udellc/Optron/Images/general assembly/MPU/IMG_2807.JPG

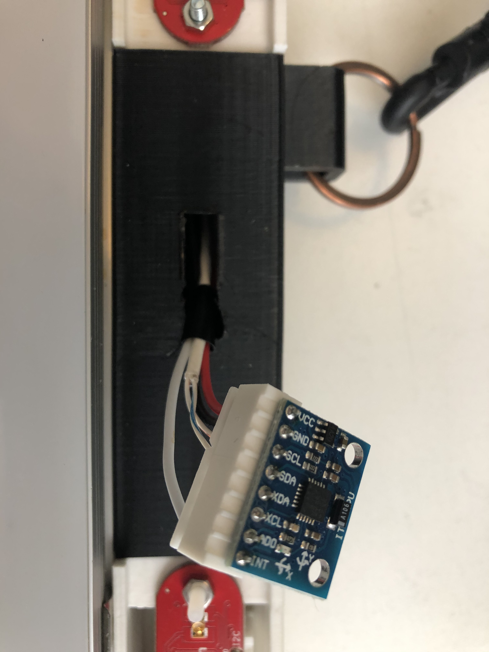
Images/general assembly/MPU/IMG_2807.JPG
