udellc/Optron/Images/general assembly/LED/IMG_2640.JPG

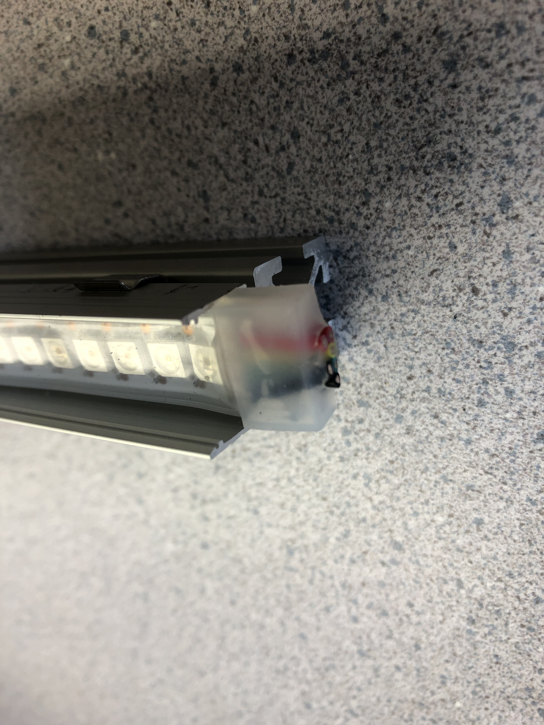
Images/general assembly/LED/IMG_2640.JPG
