udellc/Optron/Images/blocks/EPickWireManager2.1 orth1.png

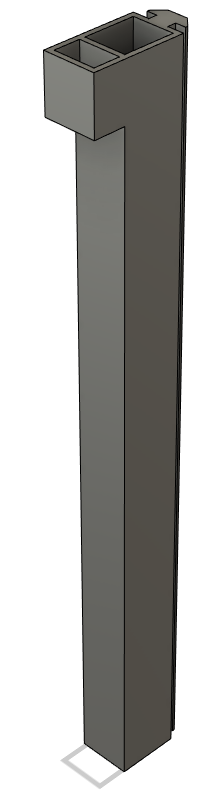
Images/blocks/EPickWireManager2.1 orth1.png
