udellc/Optron/Images/blocks/FretBoard ortho1.png

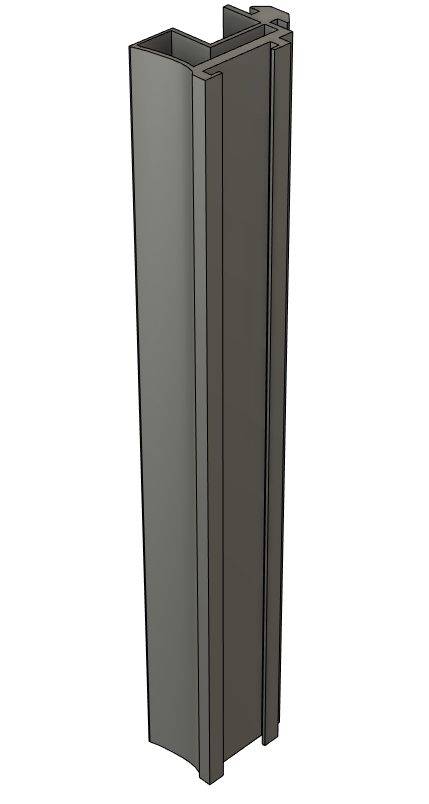
Images/blocks/FretBoard ortho1.png
