udellc/Optron/Images/blocks/FretBoard ortho2.png

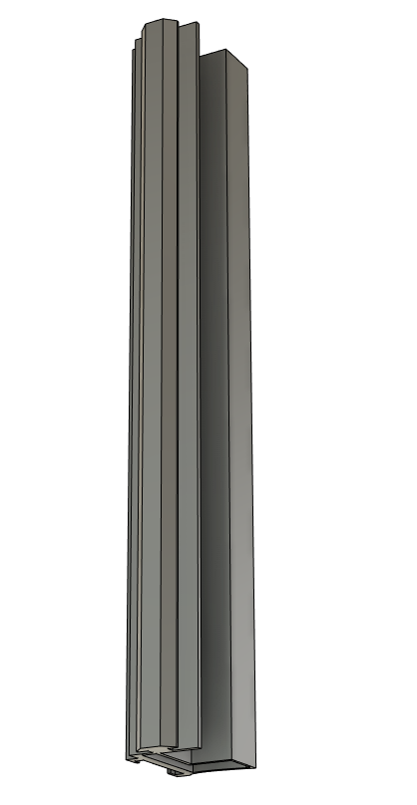
Images/blocks/FretBoard ortho2.png
