udellc/Optron/Images/blocks/FretBoardWireManager2.1.2 orth1.png

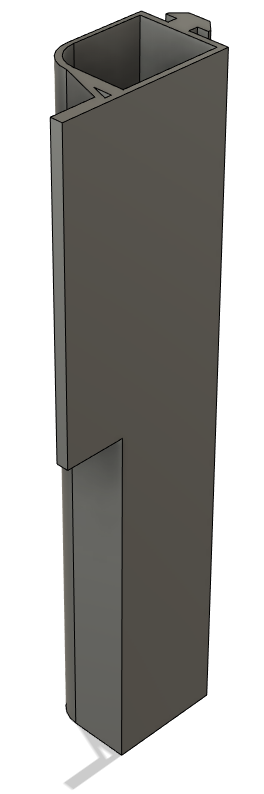
Images/blocks/FretBoardWireManager2.1.2 orth1.png
