udellc/Optron/Images/blocks/FretBoardWireManager2.1.2 orth2.png

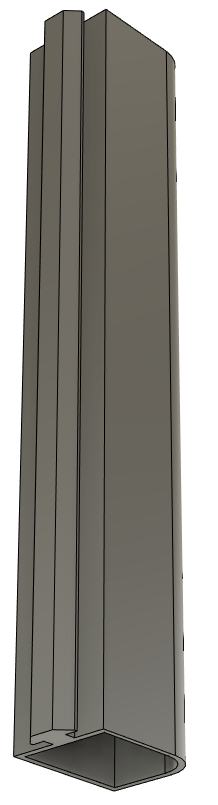
Images/blocks/FretBoardWireManager2.1.2 orth2.png
