udellc/Optron/Images/blocks/PCBMountBottom2.1.2 ortho1.png

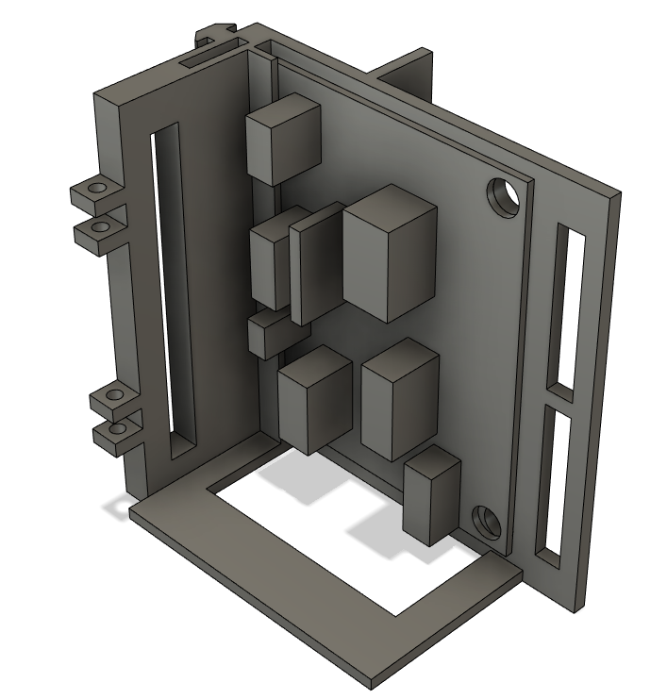
Images/blocks/PCBMountBottom2.1.2 ortho1.png
