udellc/Optron/Images/blocks/PCBMountBottom2.1.2 ortho2.png

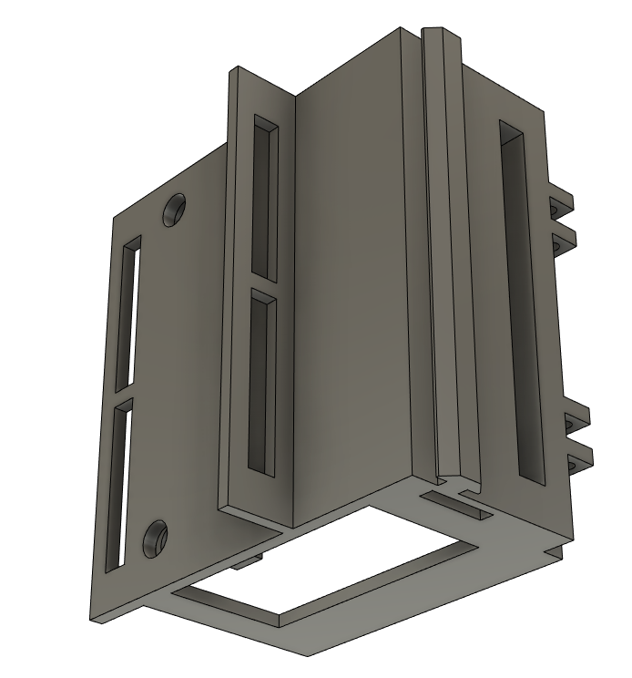
Images/blocks/PCBMountBottom2.1.2 ortho2.png
