udellc/Optron/Images/blocks/PCBMountTop2.1.2 ortho1.png

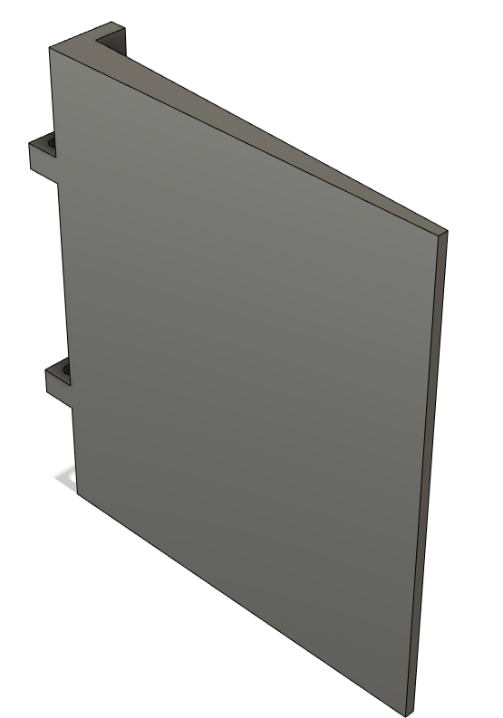
Images/blocks/PCBMountTop2.1.2 ortho1.png
