udellc/Optron/Images/blocks/PCBMountTop2.1.2 ortho2.png

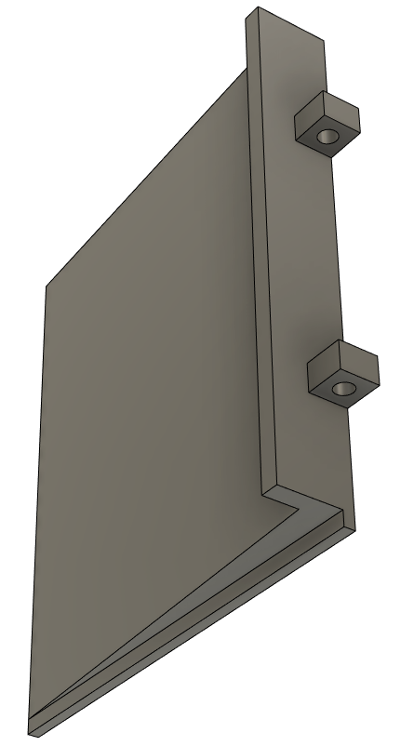
Images/blocks/PCBMountTop2.1.2 ortho2.png
