udellc/Optron/Images/blocks/SlidingWireManager2.1 ortho1.png

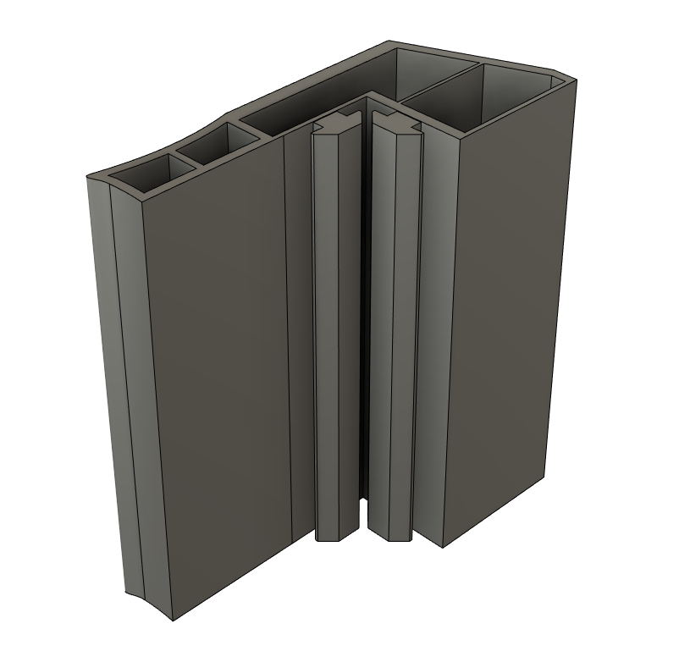
Images/blocks/SlidingWireManager2.1 ortho1.png
