udellc/Optron/Images/blocks/SlidingWireManager2.1 ortho2.png

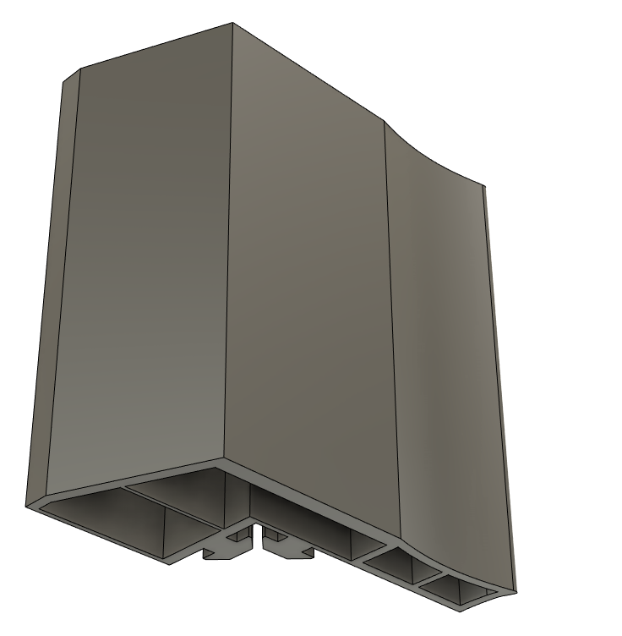
Images/blocks/SlidingWireManager2.1 ortho2.png
