udellc/Optron/Images/blocks/SlidingWireManagerSimple2.1 ortho1.png

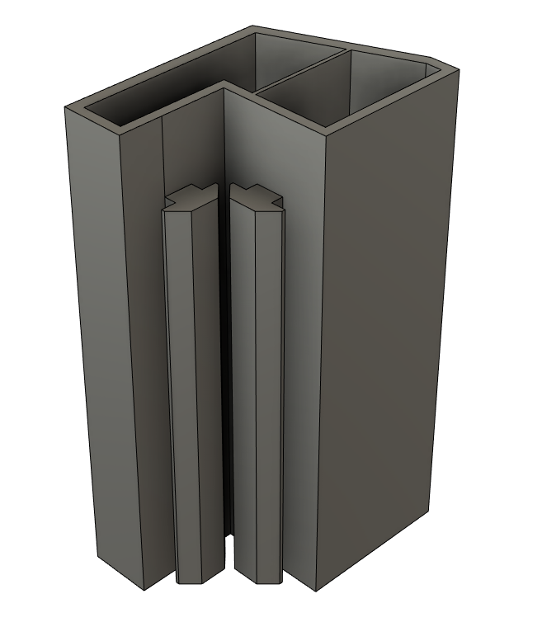
Images/blocks/SlidingWireManagerSimple2.1 ortho1.png
