udellc/Optron/Images/blocks/SlidingWireManagerSimple2.1 ortho2.png

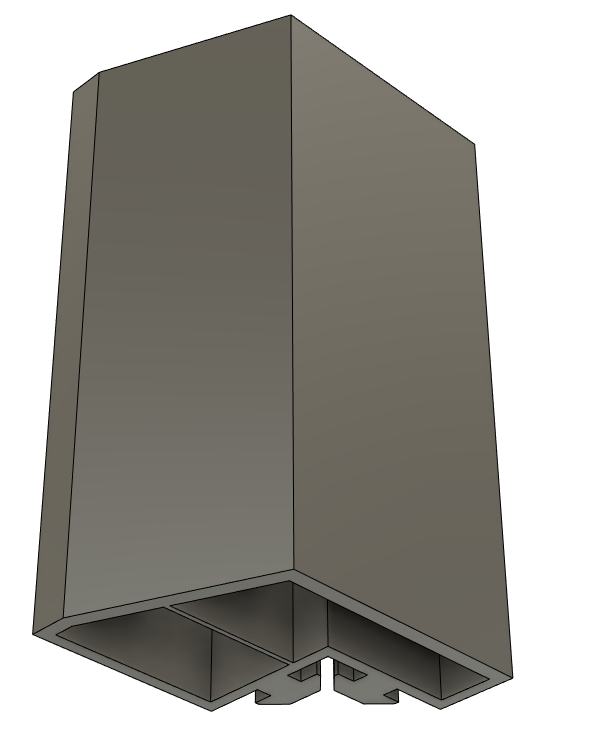
Images/blocks/SlidingWireManagerSimple2.1 ortho2.png
