udellc/Optron/Images/blocks/SlidingWireManagerStrapmount2.1 ortho1.png

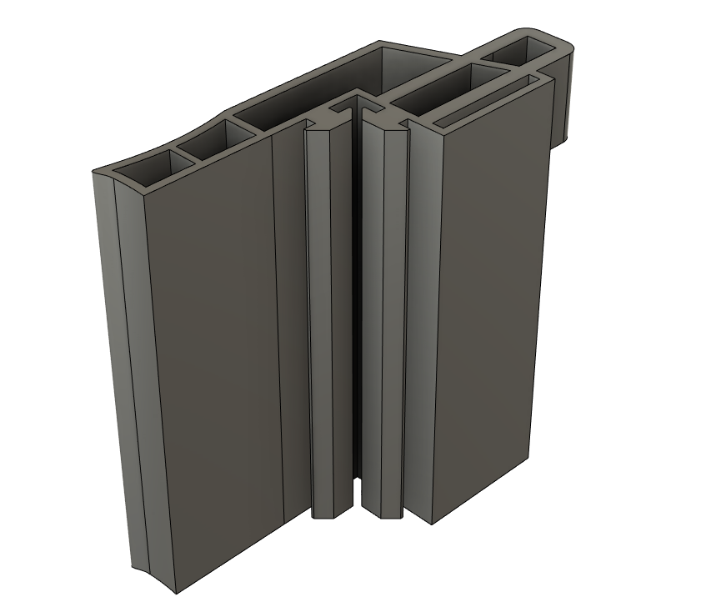
Images/blocks/SlidingWireManagerStrapmount2.1 ortho1.png
