udellc/Optron/Images/blocks/SlidingWireManagerStrapmount2.1 ortho2.png

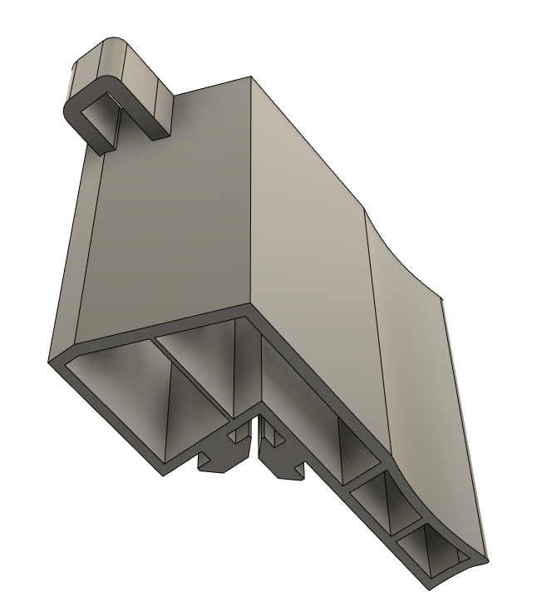
Images/blocks/SlidingWireManagerStrapmount2.1 ortho2.png
