udellc/Optron/Images/blocks/SlidingWireManagerStrapmountMPU6050Mount2.1 orth2.png

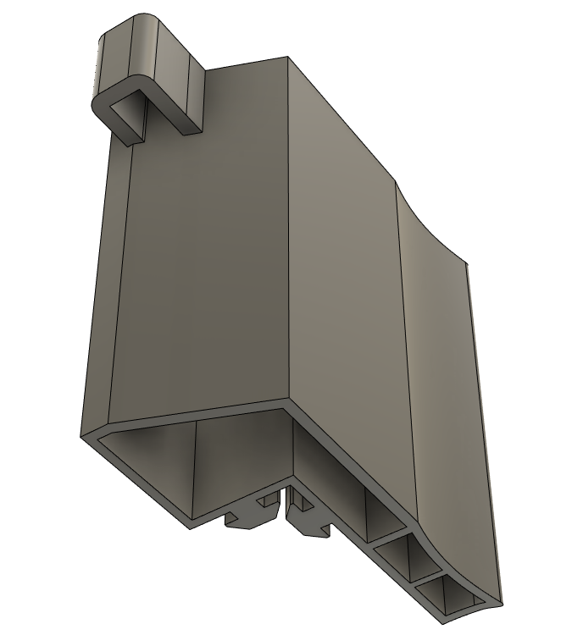
Images/blocks/SlidingWireManagerStrapmountMPU6050Mount2.1 orth2.png
