udellc/Optron/Images/blocks/ZXGestureSensorMount2.1 ortho1.png

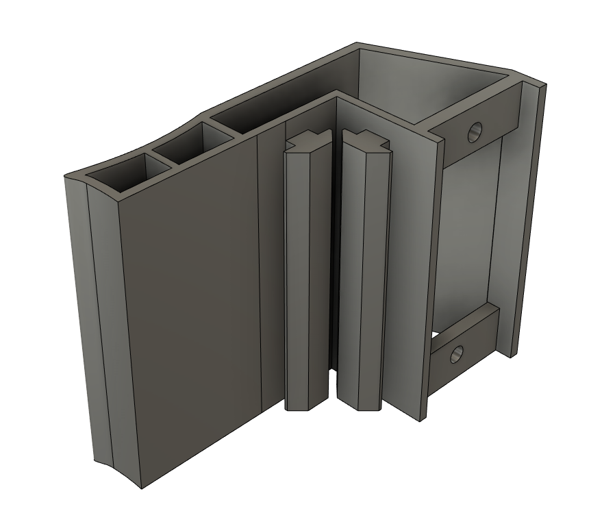
Images/blocks/ZXGestureSensorMount2.1 ortho1.png
