udellc/Optron/Images/blocks/ZXGestureSensorMount2.1 ortho2.png

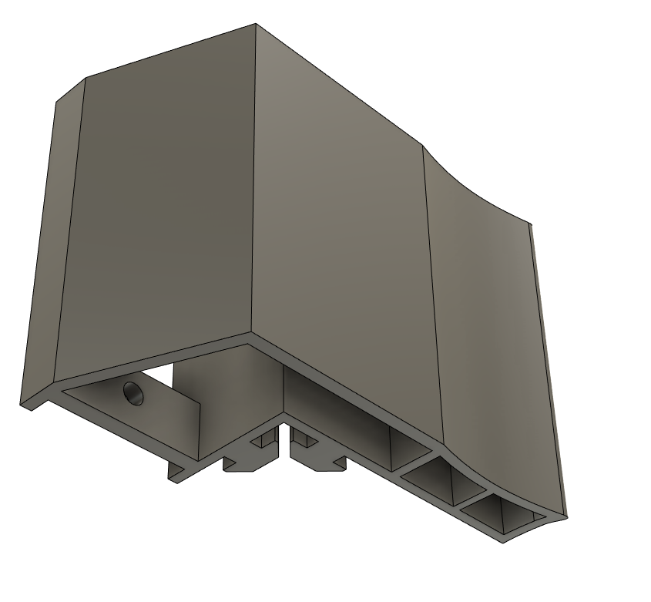
Images/blocks/ZXGestureSensorMount2.1 ortho2.png
