udellc/Optron/Images/blocks/ZXGestureSensorMountSimple2.1 ortho1.png

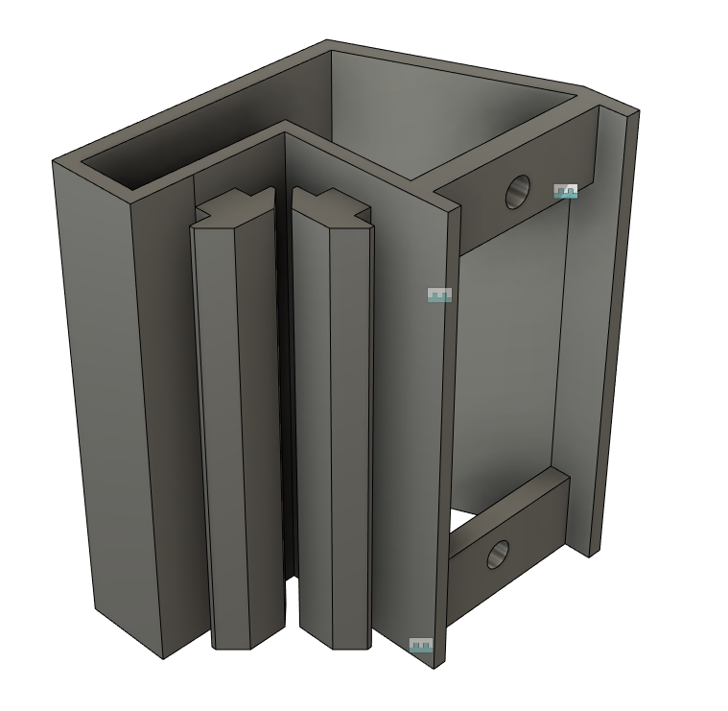
Images/blocks/ZXGestureSensorMountSimple2.1 ortho1.png
