udellc/Optron/Images/blocks/ZXGestureSensorMountSimple2.1 ortho2.png

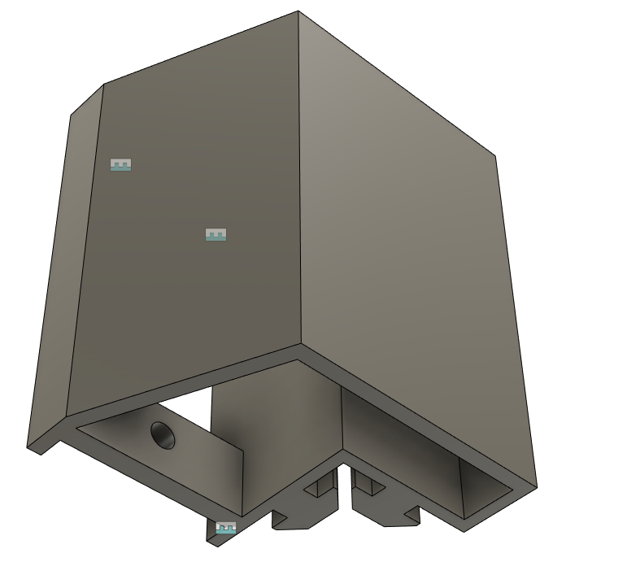
Images/blocks/ZXGestureSensorMountSimple2.1 ortho2.png
