udellc/Optron/Images/in_action.jpg

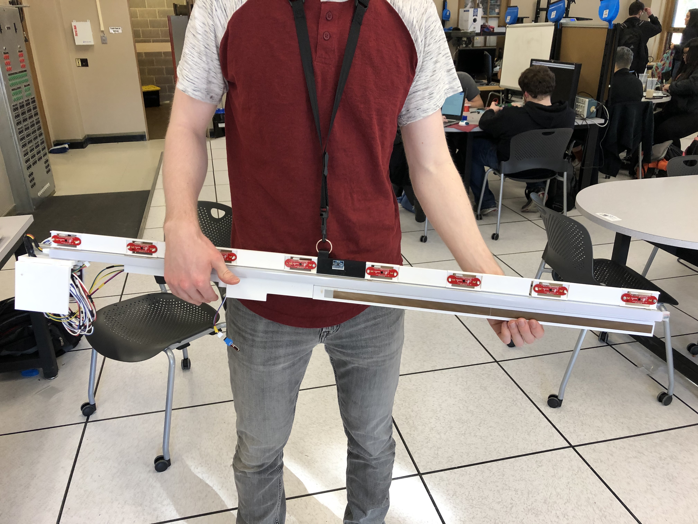
Images/in_action.jpg
