udellc/Optron/Program Flow Diagram.png

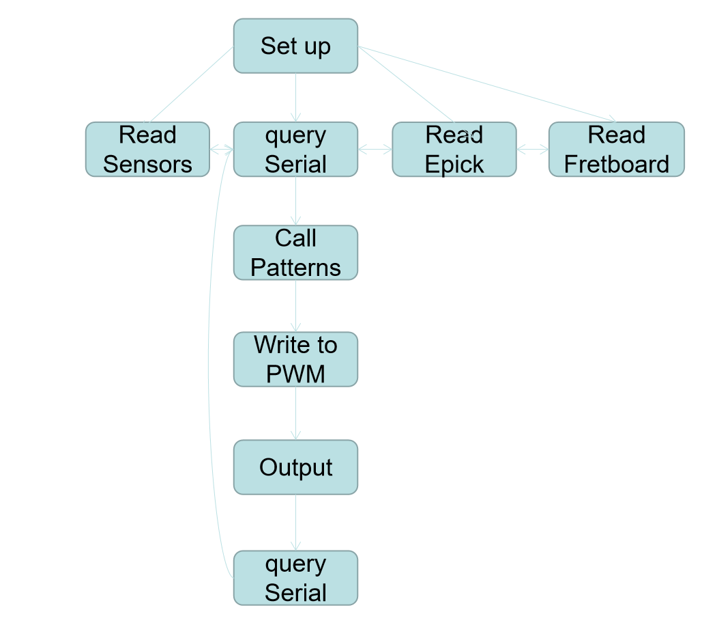
Program Flow Diagram.png
