udellc/Optron/Optron2.1 BOM.xlsx

Sheet: Overview
Optron Bill of Materials |  | Part Numbers
Document Created by: Chet Udell |  | Part numbers come in three parts, and are assigned to each part in the BOM:
Document Created on: 10/10/2019 |  | A letter which indicates type of part:
 |  | M - Mechanical | E - Electrical | H - Hardware
 |  | A number which indicates which part it is
Per 1 Optron: |  | A number indicating which duplicate of a part it is
Mechanical Components Total: | $71.13
Electrical Components Total: | $238.02 | For example:
PCBs Total: | $45.00 | M-26-0 is the first ZXGestureSensorMount2.1
3D Printing Total: | $164.68
Labor: | $0.00
Overall Cost: | $518.83

Sheet: Electrical Components
Optron Electrical Components Bill of Materials
Section of Optron | Optron ID number | Item | Distributor part number | MFG part number | Qty per 1 Optron | Cost per 1 pcs | Cost per 1 Optron | Product/site info | Datasheet/Guide | Notes
Microcontroller Assembly | E-28 | ItsyBitsy | ID:3800 | ID:3800 | 1 | $14.95 | $14.95 | Adafruit (https://www.adafruit.com/product/3800) | Datasheet (http://ww1.microchip.com/downloads/en/DeviceDoc/60001507E.pdf) | Main Microprocessor
 | E-29 | i2c Logic Level Shifter | BOB-12009 | BOB-12009 | 1 | $2.95 | $2.95 | Sparkfun (https://www.sparkfun.com/products/12009) | Datasheet (https://cdn.sparkfun.com/datasheets/BreakoutBoards/BSS138.pdf) | for shifting 3V i2c logic to 5V ZX sensor logic
 | E-30 | Quad Level Shifter | 1787 | 74AHCT125 | 1 | $1.50 | $1.50 | Adafruit (https://www.adafruit.com/product/1787) | Datasheet (https://cdn-shop.adafruit.com/product-files/1787/1787AHC125.pdf) | For shifting 3V M4 SPI MO SCK logic to 5V Dotstar Logic
 | E-31 | i2c Multiplexer 8ch | 2717 | TCA9548A | 1 | $6.95 | $6.95 | Adafruit (https://www.adafruit.com/product/2717) | Datasheet (https://cdn-shop.adafruit.com/datasheets/tca9548a.pdf) | Enables using 8 ZX sensors
Sensors | E-32 | 6dof IMU breakout | MPU6050 | MPU6050 | 1 | $5.84 | $5.84 | Amazon (https://www.amazon.com/GY-521-MPU-6050-Module-Sensors-Accelerometer/dp/B08184X254?hvadid=385372410444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) | DataSheet (https://www.invensense.com/wp-content/uploads/2015/02/MPU-6000-Datasheet1.pdf) | RegisterMap (https://www.invensense.com/wp-content/uploads/2015/02/MPU-6000-Register-Map1.pdf) | 3-axis gyroscope, 3-axis accelerometer, and a Digital Motion Processor™ (DMP)
 | E-33 | FSR Long | 1071 | Interlink408 | 1 | $19.95 | $19.95 | Adafruit (https://www.adafruit.com/product/1071) | DataSheet (https://cdn-shop.adafruit.com/datasheets/FSR400Series_PD.pdf) | Pressure sensor for Guitar Neck
 | E-34 | Long Linear Pot | SEN-08681 | SP-L-0500-103-MP | 1 | $23.95 | $23.95 | Sparkfun (https://www.sparkfun.com/products/8681) | DataSheet (https://www.sparkfun.com/datasheets/Sensors/Flex/SoftPot-Datasheet.pdf) | Position sensor for Guitar Neck
 | E-35 | ZX Gesture |  |  | 8 | $9.90 | $79.20 | Sparkfun (https://www.sparkfun.com/products/13162) | DataSheet (https://cdn.sparkfun.com/assets/learn_tutorials/3/4/5/XYZ_Interactive_Technologies_-_ZX_SparkFun_Sensor_Datasheet.pdf) | IR hand position tracking
 | E-36 | Bend Sensor, 1in bidirectional male connector, polyester overlay | 1in bi directional male tabs |  | 1 | $7.83 | $7.83 | Flexpoint (https://shop.flexpoint.com/products/the-bend-sensor%C2%AE?variant=17047449141294) | DataSheet (https://docs.wixstatic.com/ugd/5ec652_fc693c57e9374146bdcbbaa52bceb2d3.pdf) | ePick
LEDs | E-37 | Adafruit Dotstars 144led/m white, 1m | 2242 |  | 1 | $49.95 | $49.95 | Adafruit (https://www.adafruit.com/product/2242) | Tutorial (https://learn.adafruit.com/adafruit-dotstar-leds) | FastLED.io | 1 DotStar (https://cdn-shop.adafruit.com/product-files/2242/SK9822SHIJI.pdf)
 | E-38 | Adafruit Dotstars 144led/m white 0.5m | 2329 |  | 1 | $24.95 | $24.95 | Adafruit (https://www.adafruit.com/product/2329) | Tutorial
Misc | E-39 | Alitove 5V AC to DC |  |  | 1 | $25.99 | $25.99 | Amazon (https://www.amazon.com/ALITOVE-Transformer-Converter-5-5x2-1mm-100V-240V/dp/B01LXN7MN3?th=1) | Manufacturer Info (http://www.alitove.net/product/5v-15a-bk/) | Power supply
 | E-40 | 2.1mm DC Barrel Jack (for breadboard) |  |  | 1 | $8.99 | $8.99 | Amazon (https://www.amazon.com/DIKAVS-Breadboard-friendly-2-1mm-Barrel-Jack/dp/B074LK7G86/) |  | Power supply jack
 | E-41 | 2.1mm DC Barrel Jack (for PCB) |  |  | 1 | $5.99 | $5.99 | Amazon (https://www.amazon.com/Uxcell-a15012900ux0190-5-5x2-1-Female-Connector/dp/B011HFLKI2/)
 | E-42 | Haptic Motor Driver |  |  | 1 | $7.95 | $7.95 | Digikey (https://www.digikey.com/product-detail/en/sparkfun-electronics/ROB-14538/1568-1862-ND/9093800?productid=9093800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) |  | Future Components
 | E-43 | LRA Motor |  |  | 1 | $3.61 | $3.61 | Digikey (https://www.digikey.com/product-detail/en/jinlong-machinery-electronics-inc/G1036002D/1670-1068-ND/9974281) | DataSheet (http://www.vibration-motor.com/wp-content/themes/vibration-motors/dk-pdf/products/download/G1036002D.pdf)
Headers, Jumpers |  | R1 2.2k
 |  | R2 10k
 |  | R3, R4 47k
 |  | C1, 1kuF
 |  | M4.1, M4.2
 |  | M4.3
 |  | J5VDC, J5VDC2
 |  | J.MPU
 |  | J. 74A1, 74A2
 |  | B1
 |  | J.FSR
 |  | J.C1, for 1000µFCap |  |  |  |  |  |  | Cap reference (https://learn.adafruit.com/adafruit-dotstar-leds/power-and-connections) | 1000µF cap needed close to the strip for power consideration
 |  | J.DS
 |  | J.PIC
 |  | J.LN
 |  | i2c1.1, i2c2.1
 |  | i2c.1.2, i2c.2.2
 |  | J. TCA.1, TCA.2

Sheet: Mechanical Components
Optron Mechanical Components Bill of Materials
Section of Optron | Part Number | Item Description | Distributor part number | MFG part number | Qty per 1 Optron | Cost per 1 pcs | Cost per 1 Optron | Required Purchasing quantity | Cost for Required quantity | Product/site info | Notes
Core | M-0 | Al Extrusion Track 20x20 x 1220 mm | HFS3-1515-1220 | HFS5-2020-1220 | 1 | $7.68 | $7.68 | 1 | $7.68 | Misumi (https://us.misumi-ec.com/vona2/detail/110302683830/) | You will need to put the specs in yourself: HFS5, 2020, 1220mm len
 | M-1 | Muzata LED Channel | U103 | U103 | 1 | $32.99 | $32.99 | 1 | $32.99 | Amazon (https://www.amazon.com/gp/product/B07R7ZRZB1/ref=ppx_yo_dt_b_asin_title_o00_s00?ie=UTF8&psc=1) | This is a pack of 6 3.3ft diffusers which will be cut to length
Fretboard | M-2 | Teflon PFTE Film, 24" wide, 0.01" thick, 1ft length | 8569K63 | 8569K63 | 1 | $6.79 | $6.79 | 0.33 | $20.58 | McMaster (https://www.mcmaster.com/8569k63) | Will Need to laser cut frets. (https://github.com/udellc/Optron/blob/master/DXFs/Teflon.dxf)
 | M-3 | Silicone Rubber Strip, Grey, High-temp, Adhesive back, 3/4" wide, 1/32" thick | 8622k52 | 8622k52 | 1 | $7.43 | $7.43 | 0.33 | $22.52 | McMaster (https://www.mcmaster.com/8622k52) | Cut to Length
Securing, Fasteners | H-4 | M3 Slide in T Nut for 2020 Series Aluminum Extrusion Profile Slot 6mm | BR-TN-0015 | n/a | 12 | $0.16 | $1.92 | 50 | $7.99 | Amazon (https://www.amazon.com/gp/product/B01GCDG2QE/ref=ppx_yo_dt_b_asin_title_o00_s01?ie=UTF8&psc=1) | For mounting LED channel and other parts
 | H-5 | M3 x 0.5 mm Thread Steel Phillips Flat Head Screws, 8 mm Long | 91420A118 |  | 24 | $0.03 | $0.67 | 100 | $2.80 | McMasterCarr (https://www.mcmaster.com/91420a118) | For mounting LED channel and other parts
 | H-6 | M3 x 0.5 mm Thread Stainless Steel Hex Nut | 91828A211 |  | 42 | $0.06 | $2.33 | 100 | $5.55 | McMasterCarr (https://www.mcmaster.com/91828a211) | For mounting LED channel, IR sensors, PCB, and other parts
 | H-7 | M3 Stainless Steel Split Lock Washer | 92148A150 |  | 24 | $0.01 | $0.24 | 100 | $0.99 | McMasterCarr (https://www.mcmaster.com/92153a416) | For mounting LED channel and other parts
 | H-45 | M3 x 0.5 mm Thread Steel Phillips Flat Head Screws, 12 mm Long | 91420A122 |  | 8 | $0.03 | $0.26 | 100 | $3.20 | McMasterCarr (https://www.mcmaster.com/91420a122) | For mounting LED channel and other parts
 | H-44 | M3 x 0.5 mm Thread Nylon Slotted Flat Head Screws, 16 mm Long | 92929A246 |  | 18 | $0.10 | $1.73 | 100 | $9.63 | McMasterCarr (https://www.mcmaster.com/92929a246-93840A126) | For mounting IR sensor and PCB
 | H-8 | M3 Nylon Plastic Washer | 95610A530 |  | 18 | $0.04 | $0.65 | 100 | $3.60 | McMasterCarr (https://www.mcmaster.com/95610a530-95610A130) | For mounting IR sensor and PCB
 | H-9 | M3 x 0.5 mm Thread Nylon Slotted Flat Head Screws, 8 mm Long | 92929A252 |  | 0 | $0.09 | $0.00 | 100 | $9.40 | McMasterCarr (https://www.mcmaster.com/92929A252) | For mounting IR sensor and PCB
Pinout Cabling | H-10 | 4 pin JST-XH Male thru-hole. |  |  | 16 | 0.194 | 3.88 | 20 | 0.194 | Digikey (https://www.digikey.com/product-detail/en/jst-sales-america-inc/B4B-XH-A-LF-SN/455-2249-ND/1651047) | Used with IR sensors.
 | H-11 | 4 pin JST-XH Female thru-hole. |  |  | 16 | 0.0728 | 1.82 | 25 | 0.0728 | Digikey (https://www.digikey.com/product-detail/en/jst-sales-america-inc/XHP-4/455-2267-ND/683353) | Used with IR sensors.
 | H-12 | 3 pin JST-XH Male thru hole. |  |  | 4 | 0.19 | 1.14 | 6 | 0.19 | Digikey (https://www.digikey.com/product-detail/en/jst-sales-america-inc/B3B-XH-A-LF-SN/455-2248-ND/1651046) | Used with Position/Flex sensor
 | H-13 | 3 pin JST-XH Female thru hole. |  |  | 4 | 0.1 | 0.6 | 6 | 0.1 | Digikey (https://www.digikey.com/product-detail/en/jst-sales-america-inc/XHP-3/455-2219-ND/1651017) | Used with Position/Flex sensor
 | H-14 | 2 pin JST-XH Male thru hole. |  |  | 2 | 0.15 | 0.6 | 4 | 0.15 | Digikey (https://www.digikey.com/product-detail/en/jst-sales-america-inc/B2B-XH-A-LF-SN/455-2247-ND/1651045) | Used with Pressure sensor
 | H-15 | 2 pin JST-XH Female thru hole. |  |  | 2 | 0.1 | 0.4 | 4 | 0.1 | Digikey (http://www.digikey.com/product-detail/en/jst-sales-america-inc/XHP-2/455-2266-ND/555485) | Used with Pressure sensor
 | H-16 | XH JST Contact |  |  | 0.0363 | 80 | 5.445 | 150 | 0.0363 | Digikey (https://www.digikey.com/product-detail/en/SXH-001T-P0.6/455-1135-1-ND/527370/?itemSeq=315029088) | These are the sockets for JST connectors
Brush Track for cable mgmt |  | North shore commercial door |  |  |  |  |  |  |  | NSCD (https://cart.northshorecommercialdoor.com/yhst-16416632405890/ymix/MetaController.html?ysco_key_event_id=1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)

Sheet: PCBs
V8a | $38.00 | x 3 oshpark
TRRS breakout | $1.75 | x 3 oshpark | get 15 total
Total for v8 run: | $45.00

Sheet: 3D Printing
Part Number | Name | Quantity | Grams | Total Grams | Infill | Layer Height | Generate Support | STL | gcode
M-17 | FretBoard2.1 | 1 | 68.59 | 68.59 | 33 | 0.2 | No | STL (https://github.com/udellc/Optron/blob/master/STLs/2.1/FretBoard2.1.stl) | gcode (https://github.com/udellc/Optron/blob/master/STLs/2.1/FretBoard2.1.gcode)
M-18 | FretBoardBottom2.1 | 1 | 67.86 | 67.86 | 33 | 0.2 | Yes | STL (https://github.com/udellc/Optron/blob/master/STLs/2.1/FretBoardBottom2.1.stl) | gcode (https://github.com/udellc/Optron/blob/master/STLs/2.1/FretBoardBottom2.1.gcode)
M-19 | FretBoardTop2.1 | 1 | 70.65 | 70.65 | 33 | 0.2 | No | STL (https://github.com/udellc/Optron/blob/master/STLs/2.1/FretBoardTop2.1.stl) | gcode (https://github.com/udellc/Optron/blob/master/STLs/2.1/FretBoardTop2.1.gcode)
M-22 | SlidingWireManger2.1 | 3 | 71.62 | 214.86 | 33 | 0.2 | No | STL (https://github.com/udellc/Optron/blob/master/STLs/2.1/SlidingWireManager2.1.stl) | gcode (https://github.com/udellc/Optron/blob/master/STLs/2.1/SlidingWireManger2.1.gcode)
M-23 | SlidingWireMangerSimple2.1 | 3 | 53.54 | 160.62 | 33 | 0.2 | No | STL (https://github.com/udellc/Optron/blob/master/STLs/2.1/SlidingWireManagerSimple2.1.stl) | gcode (https://github.com/udellc/Optron/blob/master/STLs/2.1/SlidingWireMangerSimple2.1.gcode)
M-48 | PCBMountBottom2.1.2 | 1 | 72.5 | 72.5 | 33 | 0.2 | Yes | STL (https://github.com/udellc/Optron/blob/master/STLs/2.1/PCBMountBottom2.1.2.stl)
M-47 | PCBMountTop2.1.2 | 1 | 43.13 | 43.13 | 33 | 0.2 | Yes | STL (https://github.com/udellc/Optron/blob/master/STLs/2.1/PCBMountTop2.1.2.stl)
M-26 | ZXGestureSensorMount2.1 | 4 | 47.52 | 190.08 | 33 | 0.2 | Yes | STL (https://github.com/udellc/Optron/blob/master/STLs/2.1/ZXGestureSensorMount2.1.stl) | gcode (https://github.com/udellc/Optron/blob/master/STLs/2.1/ZXGestureSensorMount2.1.gcode)
M-27 | ZXGestureSensorMountSimple2.1 | 4 | 35.24 | 140.96 | 33 | 0.2 | Yes | STL (https://github.com/udellc/Optron/blob/master/STLs/2.1/ZXGestureSensorMountSimple2.1.stl) | gcode (https://github.com/udellc/Optron/blob/master/STLs/2.1/ZXGestureSensorMountSimple2.1.gcode)
M-46 | SlidingWireManagerSimpleStrapmountMPU6050Mount2.1 | 1 | 79 | 79 | 33 | 0.2 | Yes | STL (https://github.com/udellc/Optron/blob/master/STLs/2.1/SlidingWireManagerStrapmountMPU6050Mount2.1.stl)
M-49 | EPickWireManager2.1 | 1 | 30.63 | 30.63 | 33 | 0.2 | Yes | STL (https://github.com/udellc/Optron/blob/master/STLs/2.1/EPickWireManager2.1.stl)
M-50 | FretBoardWireManager2.1.2 | 1 | 39.38 | 39.38 | 33 | 0.2 | Yes | STL (https://github.com/udellc/Optron/blob/master/STLs/2.1/FretBoardWireManager2.1.2.stl)
M-24 | SlidingWireManagerSimpleStrapmount2.1 | 0 | 62.48 | 0 | 33 | 0.2 | No | STL (https://github.com/udellc/Optron/blob/master/STLs/2.1/SlidingWireManagerSimpleStrapmount2.1.stl) | gcode (https://github.com/udellc/Optron/blob/master/STLs/2.1/SlidingWireManagerSimpleStrapmount2.1.gcode)
M-25 | SlidingWireManagerStrapmount2.1 | 0 | 80.38 | 0 | 33 | 0.2 | No | STL (https://github.com/udellc/Optron/blob/master/STLs/2.1/SlidingWireManagerStrapmount2.1.stl) | gcode (https://github.com/udellc/Optron/blob/master/STLs/2.1/SlidingWireManagerStrapmount2.1.gcode)
M-21 | PCBMount2.1 | 0 | 23.21 | 0 | 33 | 0.2 | Yes | STL (https://github.com/udellc/Optron/blob/master/STLs/2.1/PCBMount2.1.stl) | gcode (https://github.com/udellc/Optron/blob/master/STLs/2.1/PCBMount2.1.gcode)
M-20 | FretBoardWireManager2.1 | 0 | 4.25 | 0 | 33 | 0.2 | Yes | STL (https://github.com/udellc/Optron/blob/master/STLs/2.1/FretBoardWireManager2.1.stl) | gcode (https://github.com/udellc/Optron/blob/master/STLs/2.1/FretBoardWireManager2.1.gcode)
 | Cost Per Gram:
 | $0.16
 | Total Cost:
 | $164.68
