udellc/Optron/STLs/2.0/DiffuserBodyv1.stl

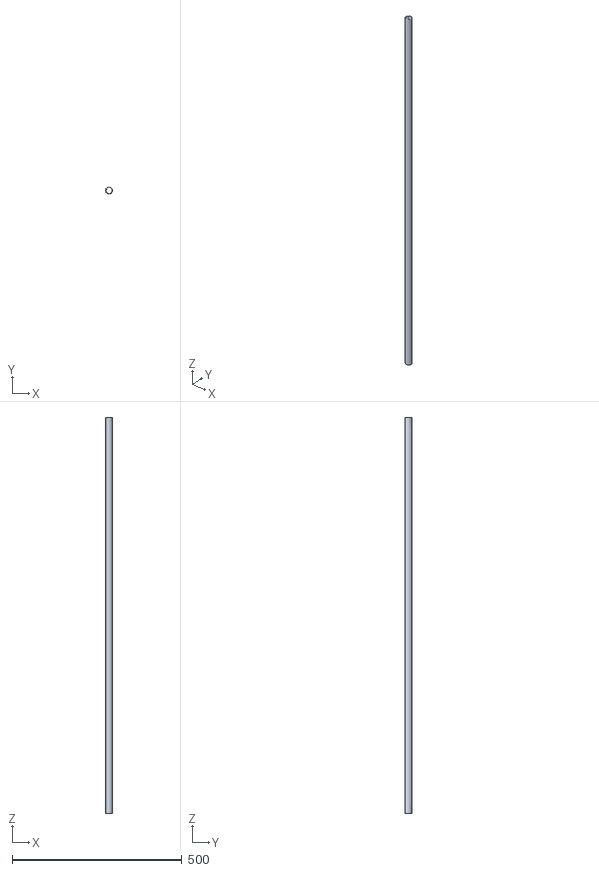
[picture p26: CAD file, 2019-10-22]
STLs/2.0/DiffuserBodyv1.stl
20.3 x 20.3 x 1165.2
