udellc/Optron/STLs/2.1/EPickWireManager2.1.stl

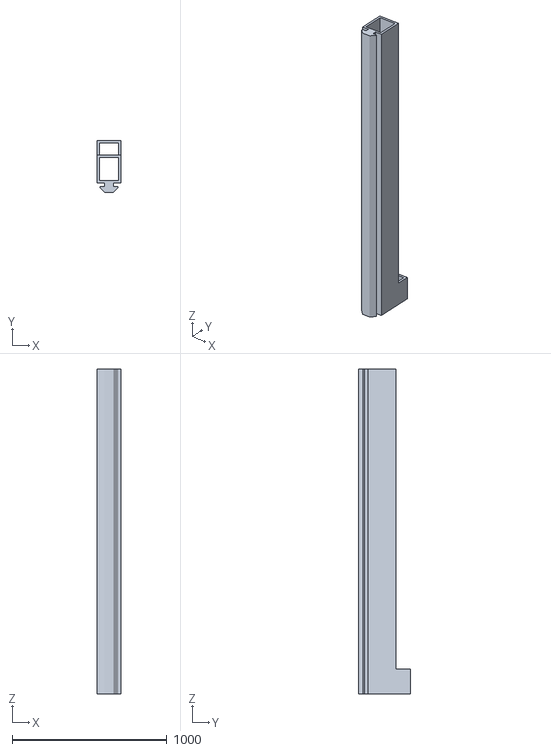
[picture p27: CAD file, 2020-04-10]
STLs/2.1/EPickWireManager2.1.stl
154.0 x 335.0 x 2100.0
