udellc/Optron/STLs/2.0/GitStrapMount.stl

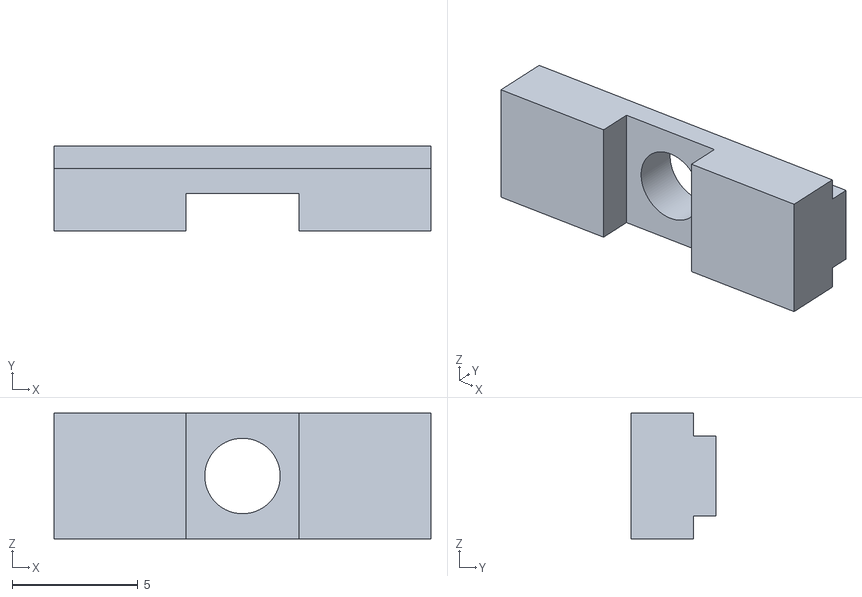
[picture p28: CAD file, 2019-10-15]
STLs/2.0/GitStrapMount.stl
15.0 x 3.40 x 5.00
