udellc/Optron/STLs/2.1/PCBMountBottom2.1.2.stl

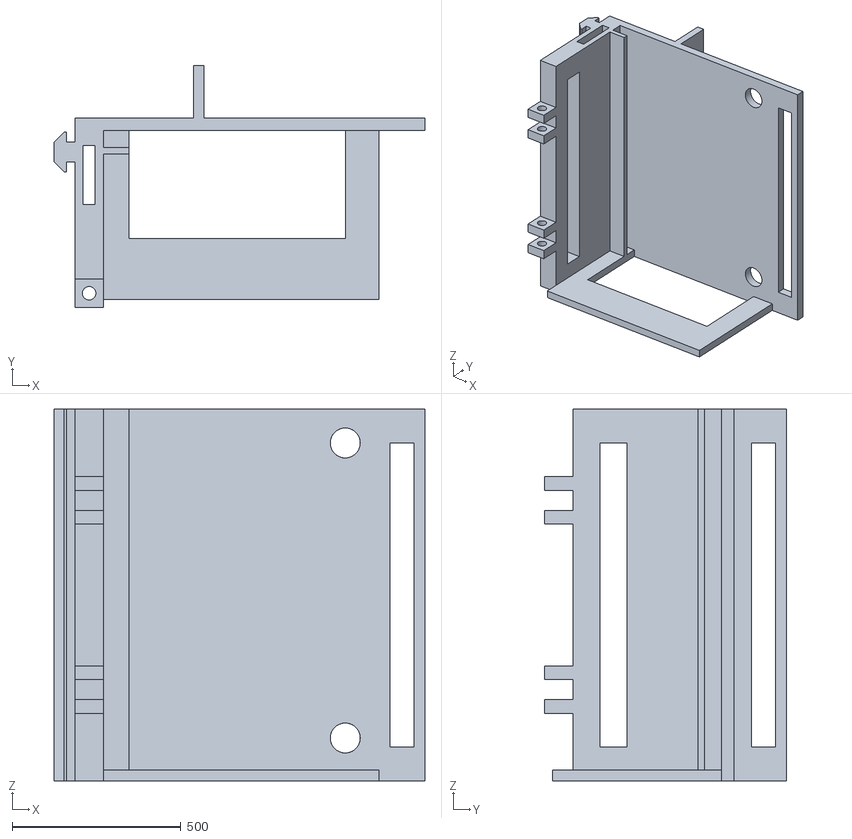
[picture p29: CAD file, 2020-04-10]
STLs/2.1/PCBMountBottom2.1.2.stl
1098.0 x 716.0 x 1100.0
