udellc/Optron/STLs/2.0/NeckClipBridgeV2.stl

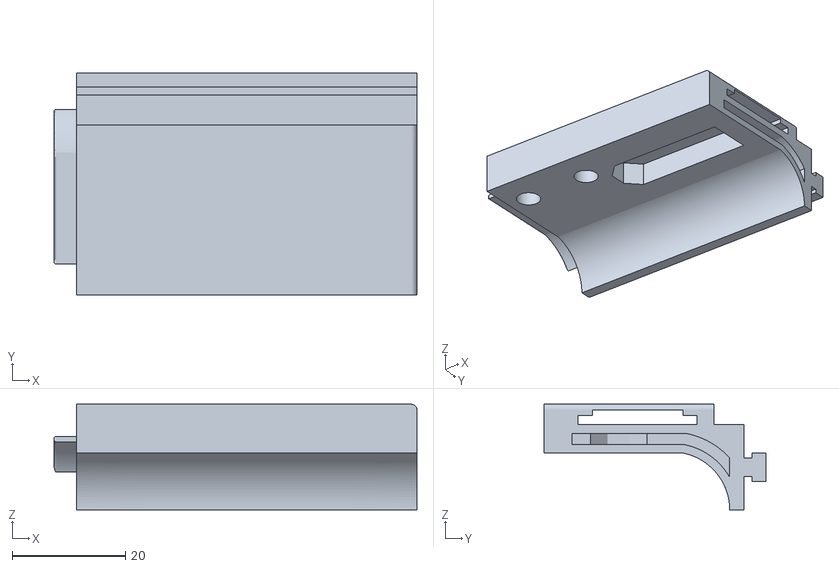
[picture p30: CAD file, 2019-10-15]
STLs/2.0/NeckClipBridgeV2.stl
64.0 x 39.1 x 18.6
