udellc/Optron/STLs/2.1/FretBoardWireManager2.1.2.stl

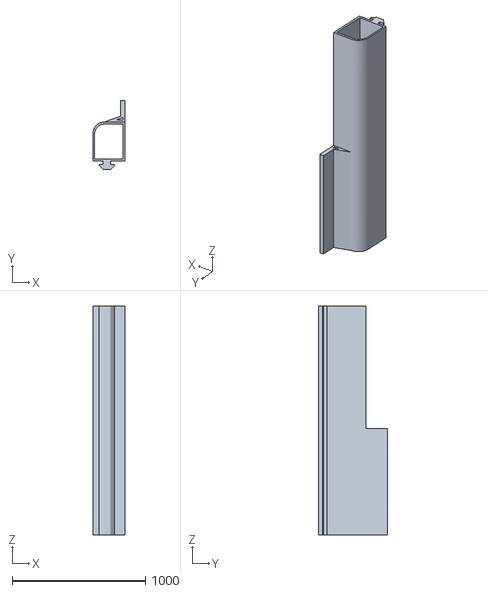
[picture p31: CAD file, 2020-04-10]
STLs/2.1/FretBoardWireManager2.1.2.stl
240.0 x 516.0 x 1720.0
