udellc/Optron/STLs/2.0/GitStrapPegTop.stl

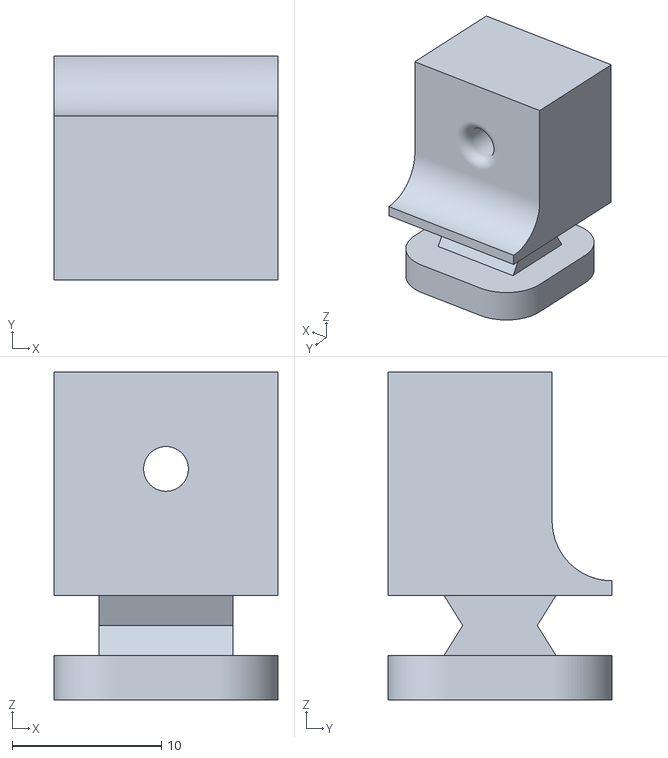
[picture p32: CAD file, 2019-10-15]
STLs/2.0/GitStrapPegTop.stl
15.0 x 15.0 x 22.0
