udellc/Optron/STLs/2.1/PCBMountTop2.1.2.stl

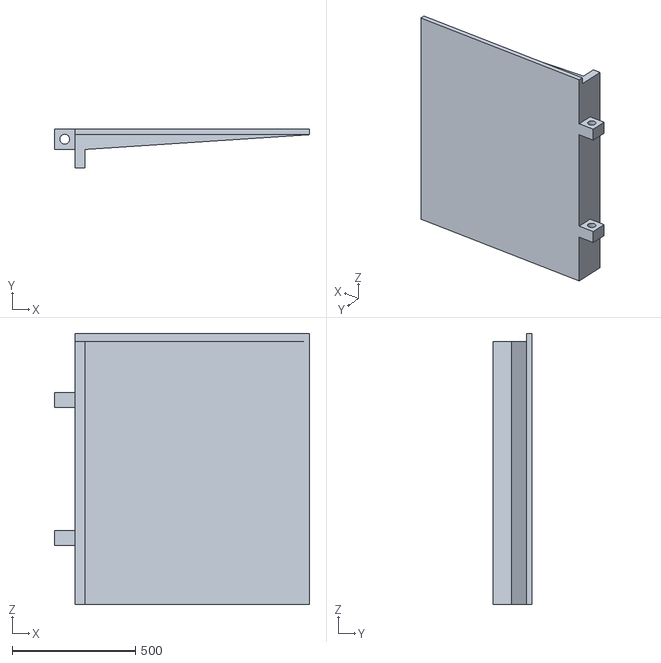
[picture p33: CAD file, 2020-04-10]
STLs/2.1/PCBMountTop2.1.2.stl
1036.0 x 160.0 x 1100.0
