udellc/Optron/STLs/2.0/NeckClipV3.stl

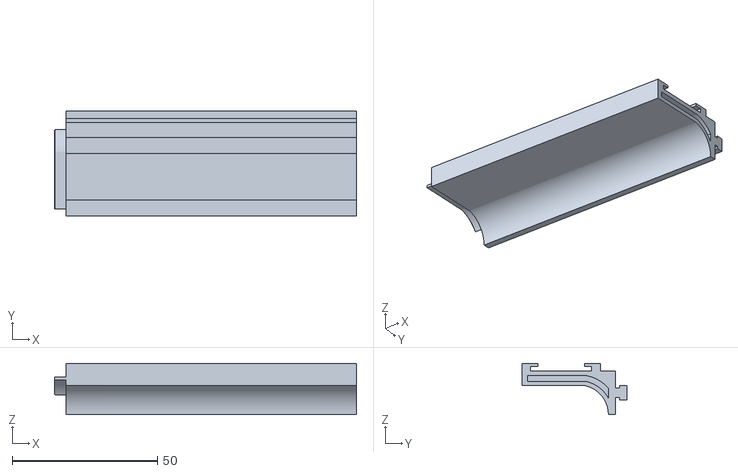
[picture p34: CAD file, 2019-10-15]
STLs/2.0/NeckClipV3.stl
104.0 x 36.1 x 17.6
