udellc/Optron/STLs/2.1/SlidingWireManagerStrapmountMPU6050Mount2.1.stl

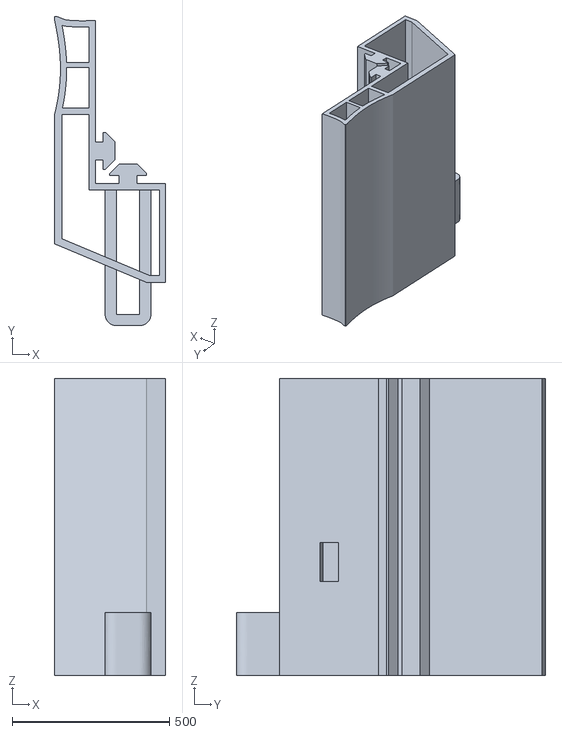
[picture p35: CAD file, 2020-02-19]
STLs/2.1/SlidingWireManagerStrapmountMPU6050Mount2.1.stl
354.8 x 985.1 x 945.7
