udellc/Optron/STLs/2.0/NeckClipNutV1.stl

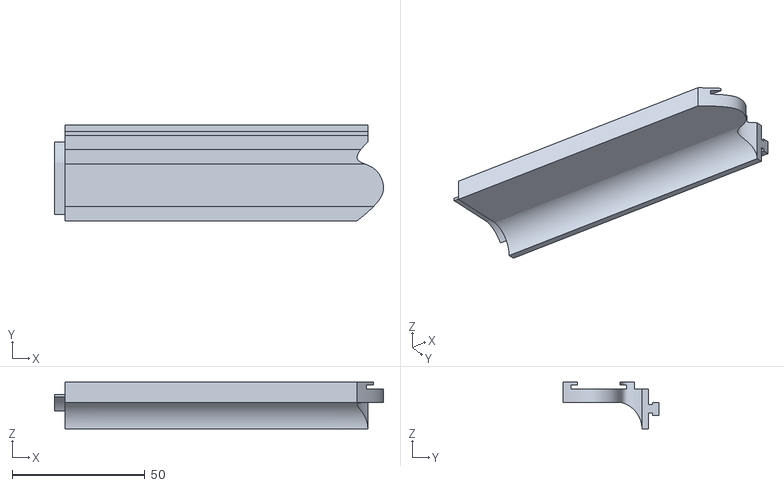
[picture p36: CAD file, 2019-10-15]
STLs/2.0/NeckClipNutV1.stl
124.0 x 36.1 x 17.6
