udellc/Optron/STLs/2.1/ZXGestureSensorMount2.1.stl

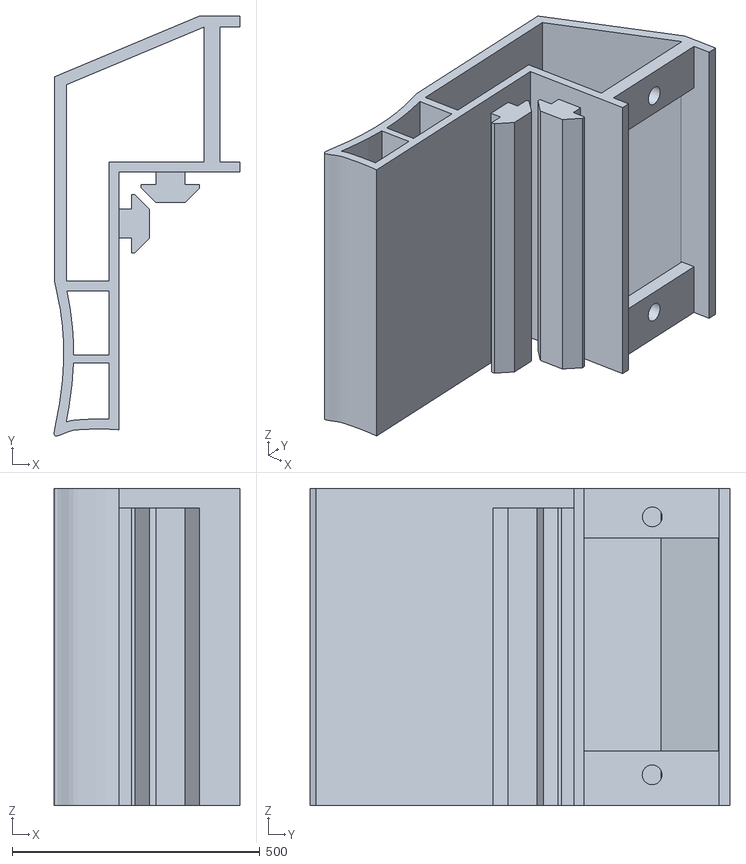
[picture p37: CAD file, 2020-01-15]
STLs/2.1/ZXGestureSensorMount2.1.stl
374.8 x 847.2 x 640.0
