udellc/Optron/STLs/2.0/PCBmountV3.stl

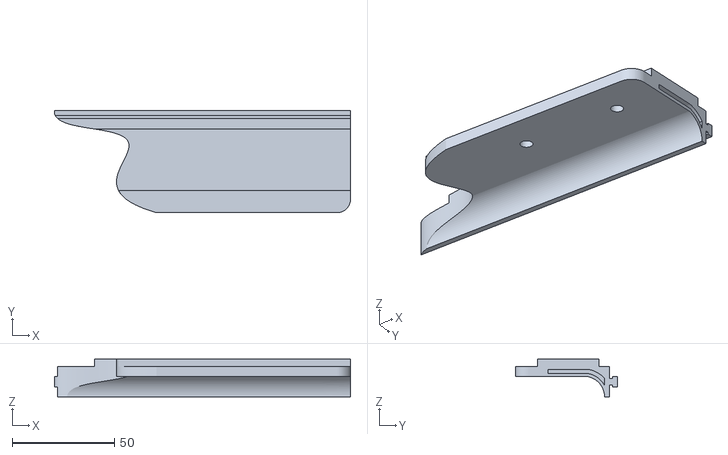
[picture p38: CAD file, 2019-10-15]
STLs/2.0/PCBmountV3.stl
145.0 x 50.1 x 18.6
