udellc/Optron/STLs/2.1/ZXGestureSensorMountSimple2.1.stl

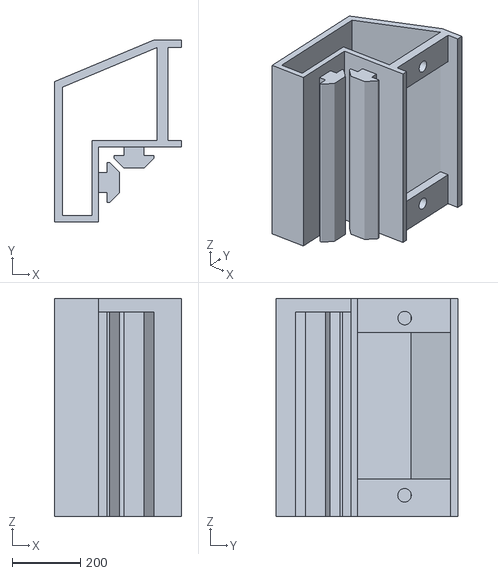
[picture p39: CAD file, 2020-01-15]
STLs/2.1/ZXGestureSensorMountSimple2.1.stl
374.0 x 534.7 x 640.0
