udellc/Optron/STLs/2.0/LED_insert100mm.stl

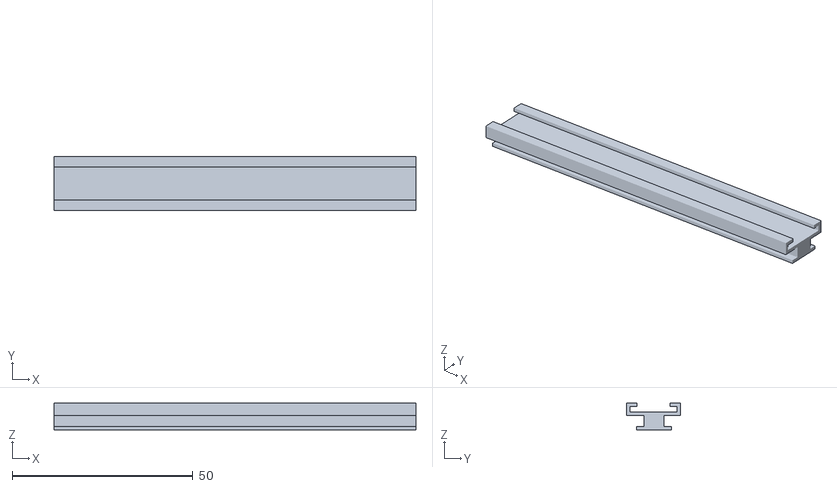
[picture p40: CAD file, 2019-10-15]
STLs/2.0/LED_insert100mm.stl
100.0 x 15.0 x 7.45
