udellc/Optron/STLs/2.1/FretBoard2.1.stl

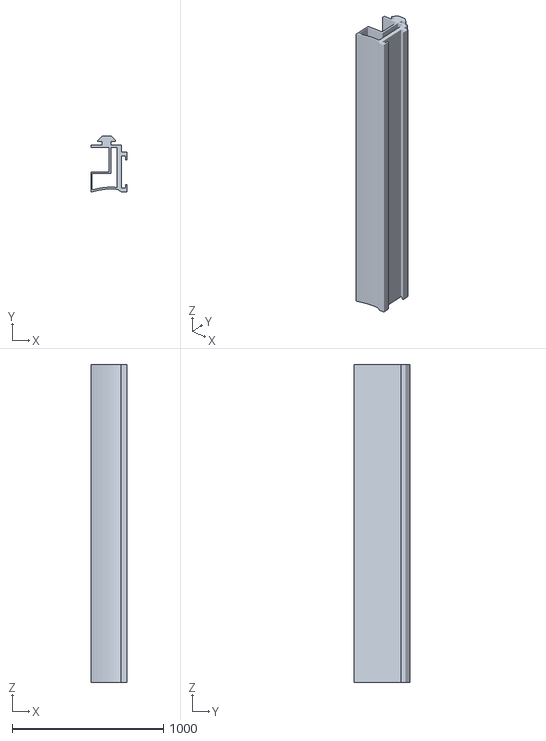
[picture p41: CAD file, 2020-01-15]
STLs/2.1/FretBoard2.1.stl
240.0 x 372.0 x 2100.0
