udellc/Optron/STLs/2.0/KeyedDiffuserBraceV3ZX.stl

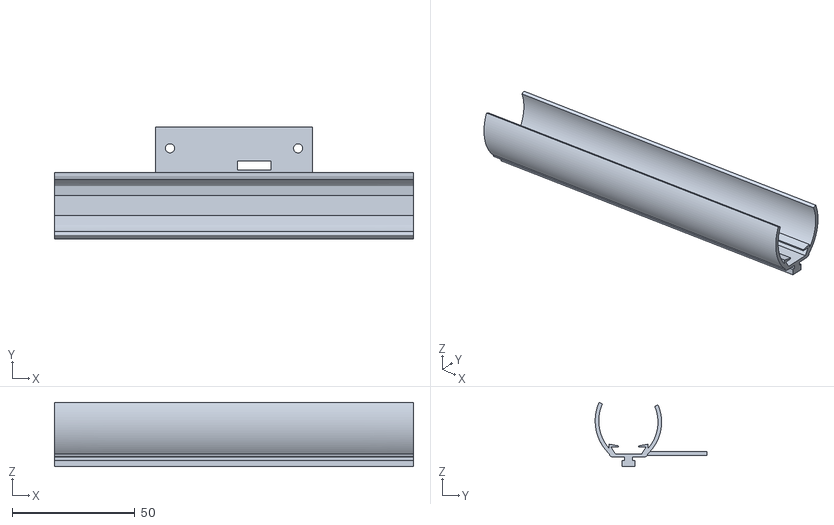
[picture p42: CAD file, 2019-10-15]
STLs/2.0/KeyedDiffuserBraceV3ZX.stl
146.0 x 45.4 x 26.1
