udellc/Optron/STLs/2.1/SlidingWireManagerSimpleStrapmount2.1.stl

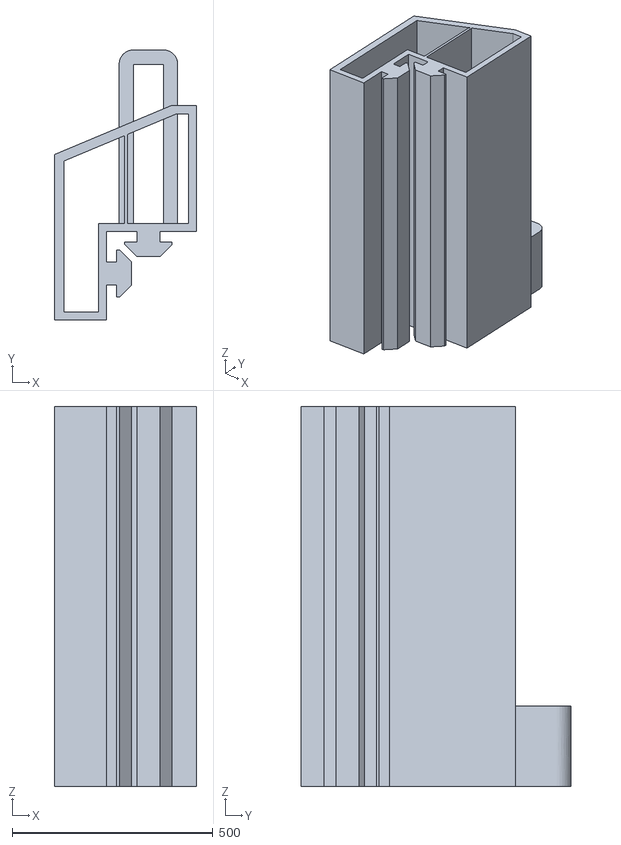
[picture p43: CAD file, 2020-01-15]
STLs/2.1/SlidingWireManagerSimpleStrapmount2.1.stl
354.0 x 672.6 x 945.7
