udellc/Optron/STLs/2.0/CableClip1V2.stl

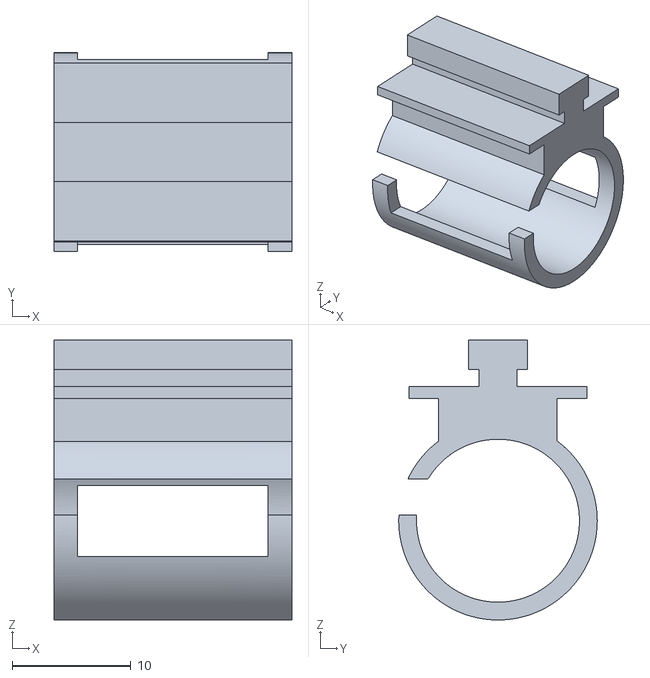
[picture p44: CAD file, 2019-10-15]
STLs/2.0/CableClip1V2.stl
20.0 x 16.7 x 23.5
