udellc/Optron/STLs/2.0/BarrelJackHolderFix.stl

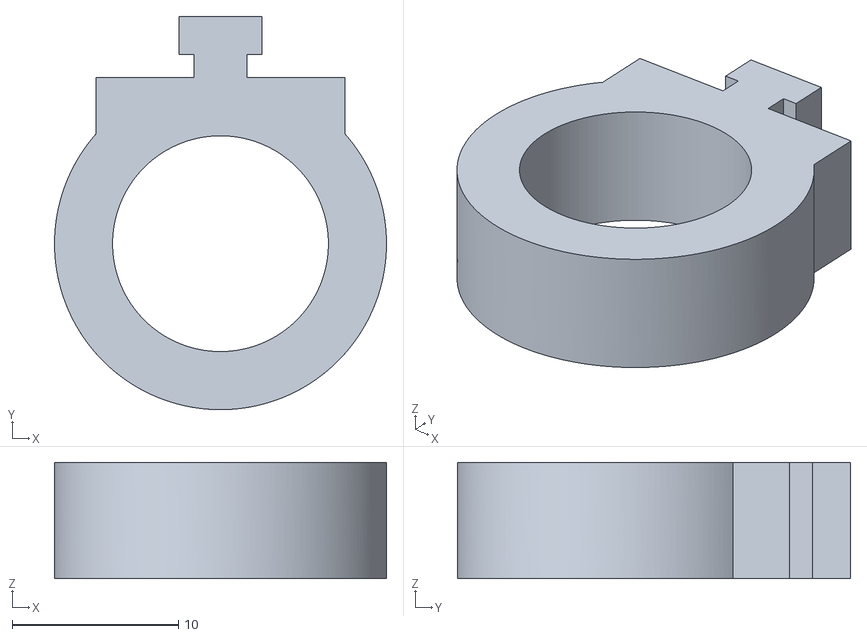
[picture p45: CAD file, 2019-10-15]
STLs/2.0/BarrelJackHolderFix.stl
20.0 x 23.7 x 7.00
