udellc/Optron/STLs/2.1/SlidingWireManagerSimple2.1.stl

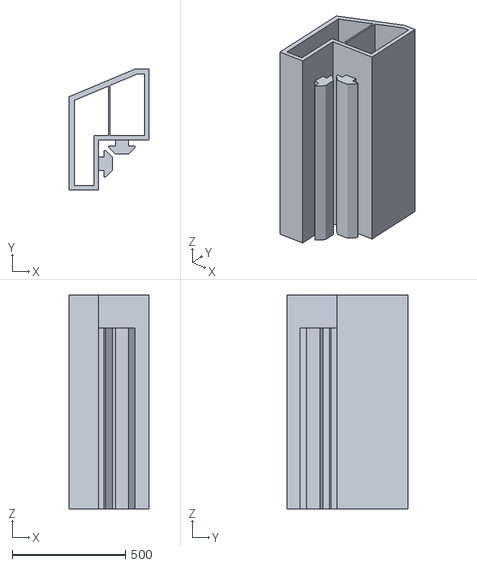
[picture p46: CAD file, 2020-01-15]
STLs/2.1/SlidingWireManagerSimple2.1.stl
354.0 x 534.7 x 945.7
