udellc/Optron/STLs/2.0/fingerboard6.17.154mm.stl

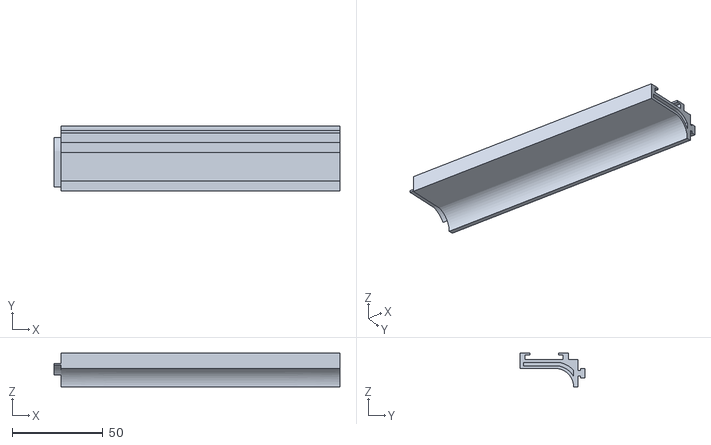
[picture p47: CAD file, 2019-10-15]
STLs/2.0/fingerboard6.17.154mm.stl
158.0 x 36.1 x 18.6
