udellc/Optron/STLs/2.1/FretBoardWireManager2.1.stl

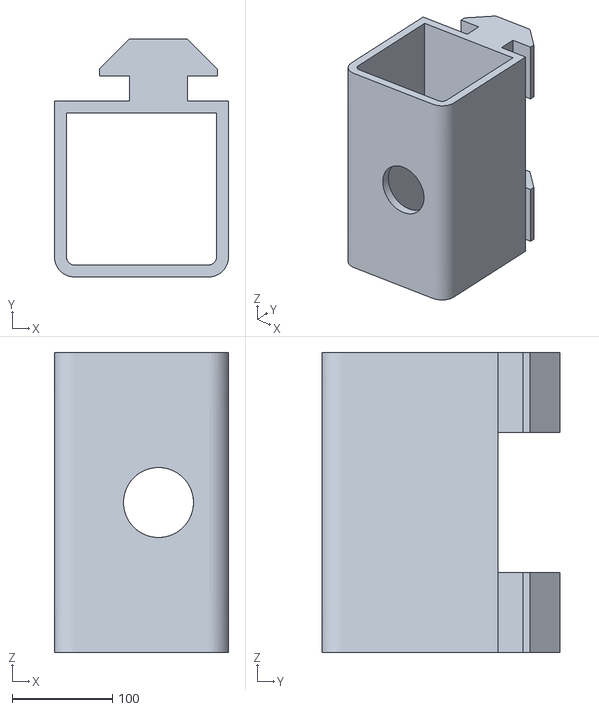
[picture p48: CAD file, 2020-01-15]
STLs/2.1/FretBoardWireManager2.1.stl
174.0 x 238.0 x 300.0
