udellc/Optron/STLs/2.0/fingerBoardClip6.17.stl

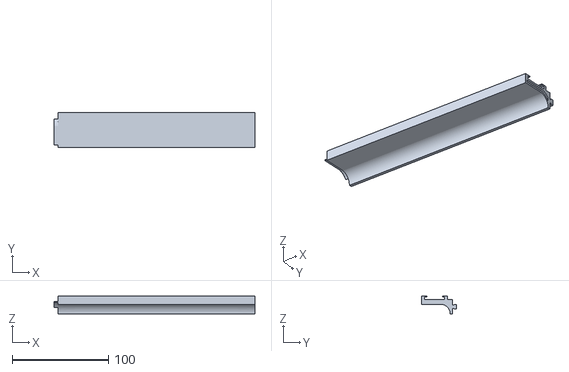
[picture p49: CAD file, 2019-10-15]
STLs/2.0/fingerBoardClip6.17.stl
209.0 x 36.1 x 18.6
