udellc/Optron/STLs/2.1/SlidingWireManager2.1.stl

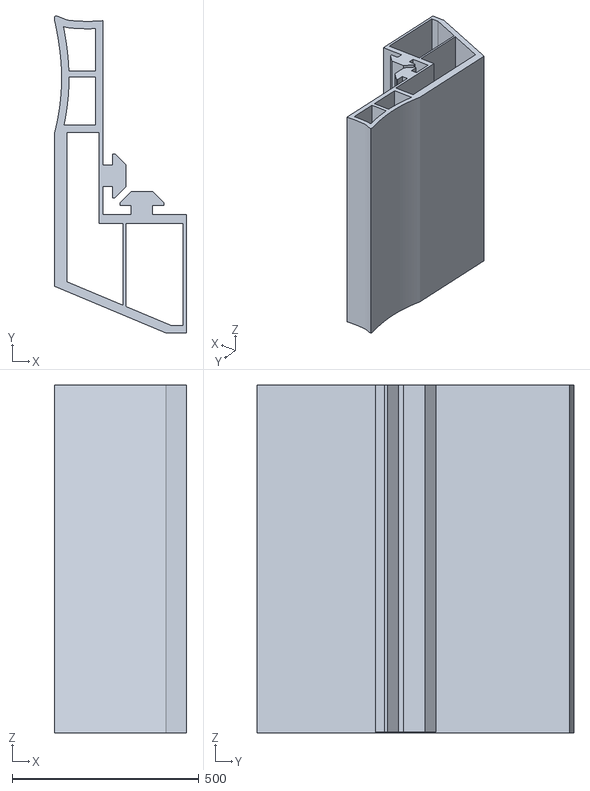
[picture p50: CAD file, 2020-01-15]
STLs/2.1/SlidingWireManager2.1.stl
354.8 x 849.6 x 931.4
