udellc/Optron/STLs/2.0/StrumLine.stl

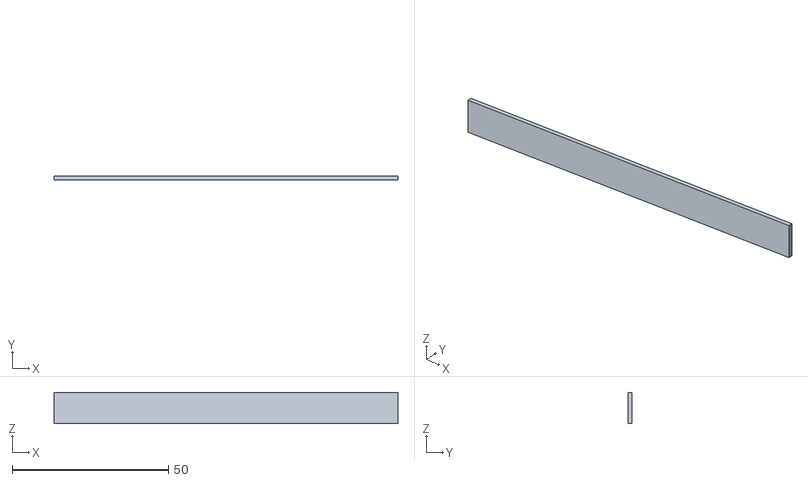
[picture p51: CAD file, 2019-10-15]
STLs/2.0/StrumLine.stl
110.2 x 1.30 x 10.0
