udellc/Optron/STLs/2.1/FretBoardTop2.1.stl

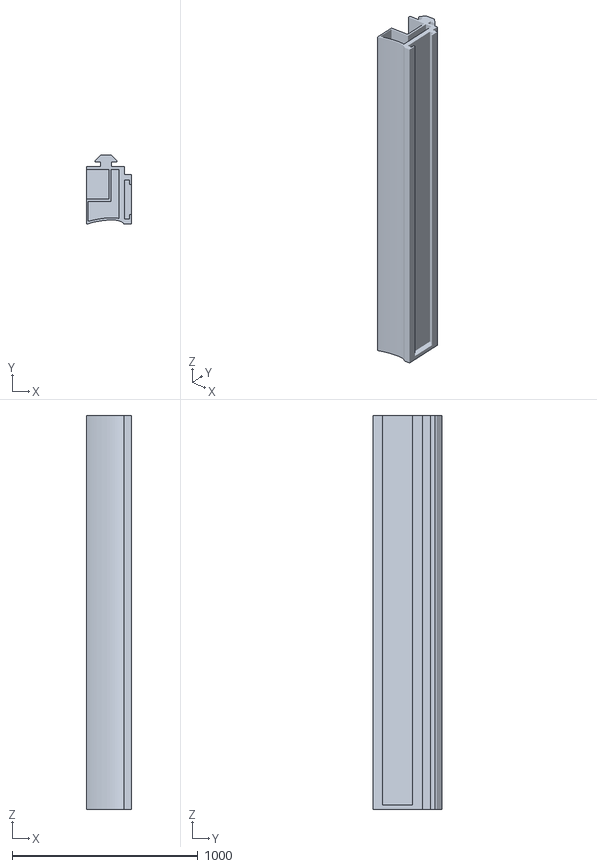
[picture p52: CAD file, 2020-01-15]
STLs/2.1/FretBoardTop2.1.stl
240.0 x 372.0 x 2124.0
