udellc/Optron/STLs/2.1/SlidingWireManagerStrapmount2.1.stl

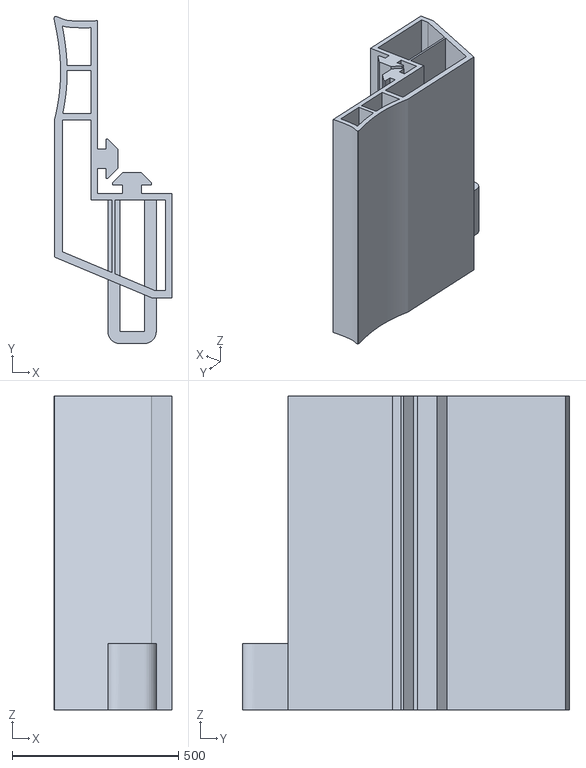
[picture p53: CAD file, 2020-01-15]
STLs/2.1/SlidingWireManagerStrapmount2.1.stl
354.8 x 985.1 x 945.7
