udellc/Optron/STLs/2.1/PCBmount2.1.stl

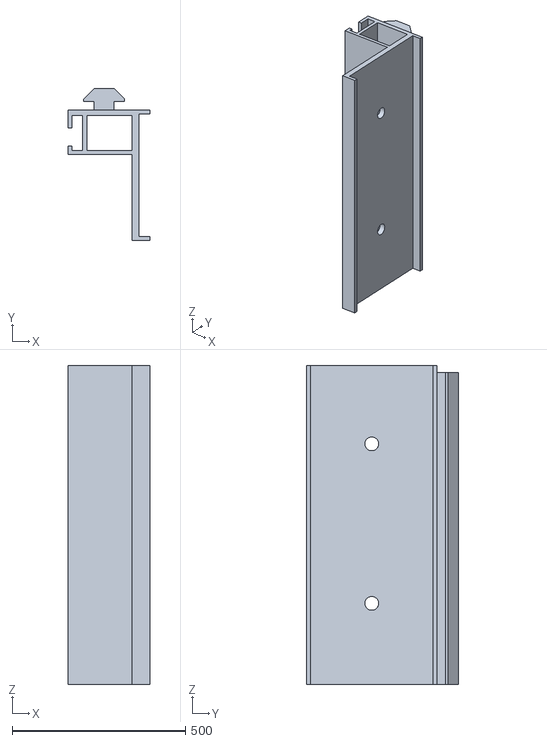
[picture p54: CAD file, 2020-01-07]
STLs/2.1/PCBmount2.1.stl
236.0 x 438.0 x 920.0
