udellc/Optron/(list of files, cad)

Other CAD files:
DXFs/Teflon.dxf
STLs/2.1/FretBoardBottom2.1.stl
