udellc/Optron/Images/blocks/ir_sensor_assembly.png

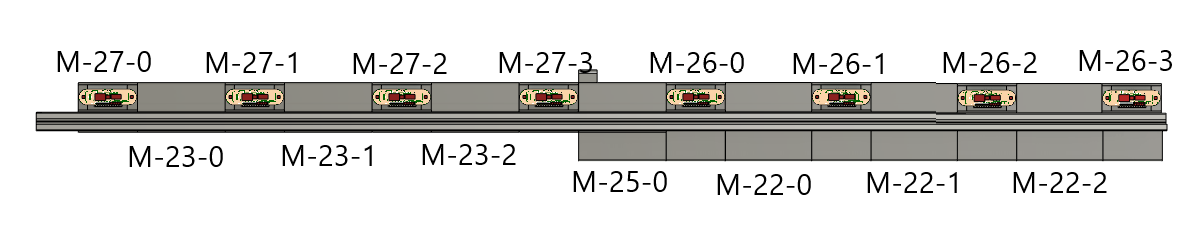
Images/blocks/ir_sensor_assembly.png
