udellc/Optron/Images/general assembly/Fretboard/bottom.png

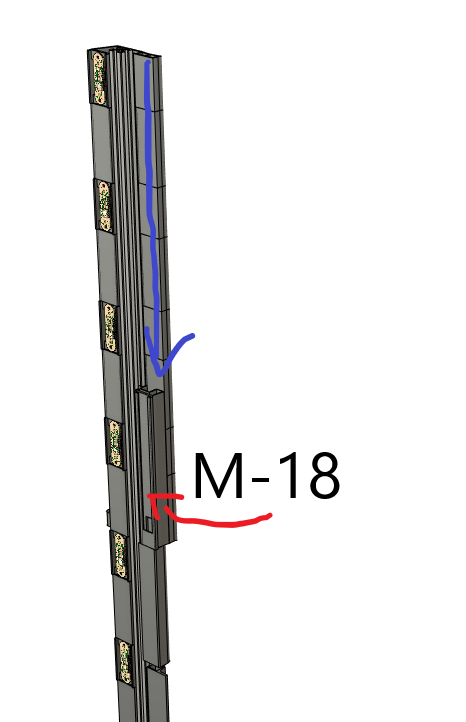
Images/general assembly/Fretboard/bottom.png
