udellc/Optron/Images/general assembly/Fretboard/middle.png

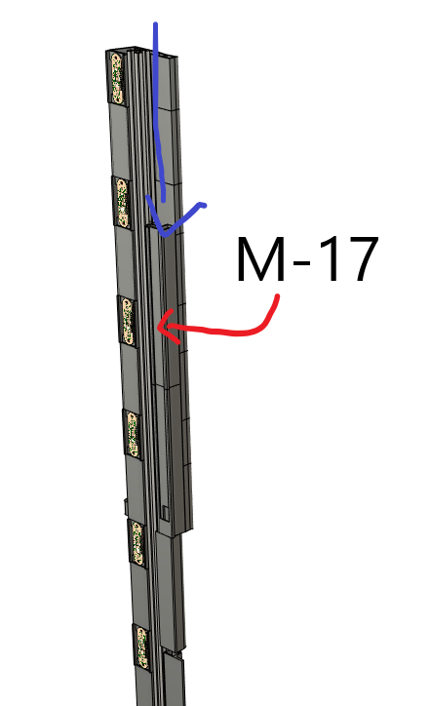
Images/general assembly/Fretboard/middle.png
