udellc/Optron/Images/general assembly/Fretboard/top.png

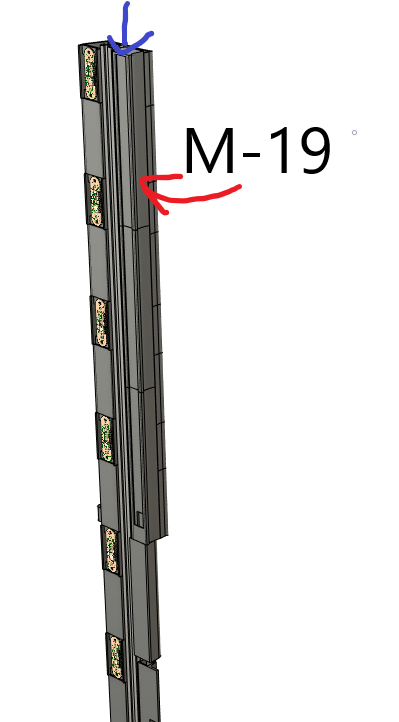
Images/general assembly/Fretboard/top.png
