udellc/Optron/Images/general assembly/IMG_2809.JPG

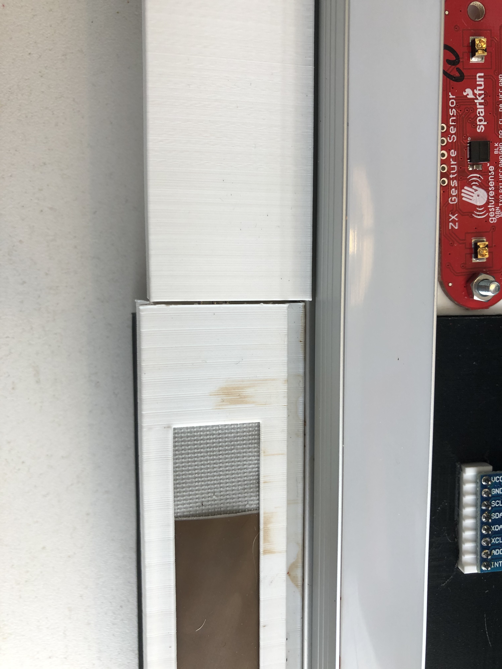
Images/general assembly/IMG_2809.JPG
