udellc/Optron/Images/general assembly/IMG_2810.JPG

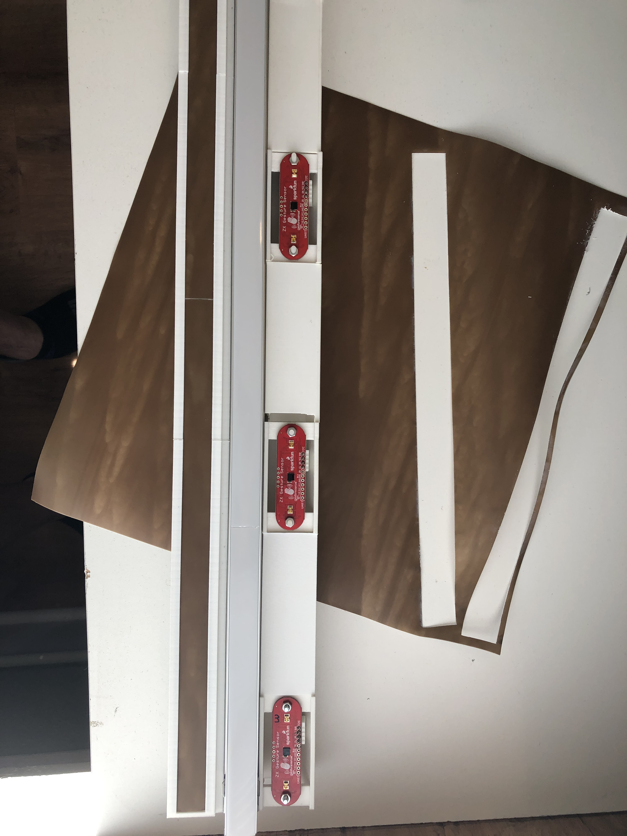
Images/general assembly/IMG_2810.JPG
