udellc/Optron/Images/general assembly/IMG_2811.JPG

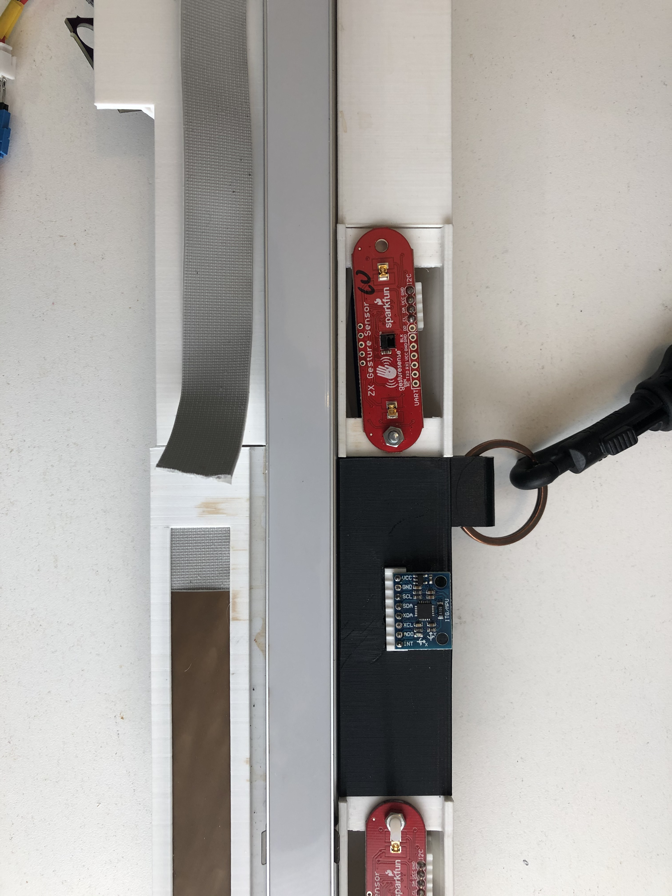
Images/general assembly/IMG_2811.JPG
