udellc/Optron/Images/general assembly/IMG_2812.JPG

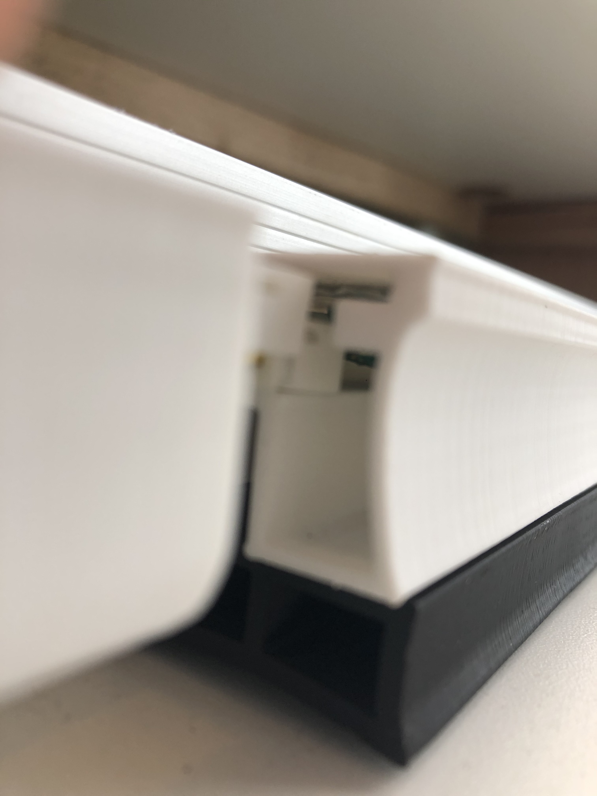
Images/general assembly/IMG_2812.JPG
