udellc/Optron/Images/general assembly/IMG_2813.JPG

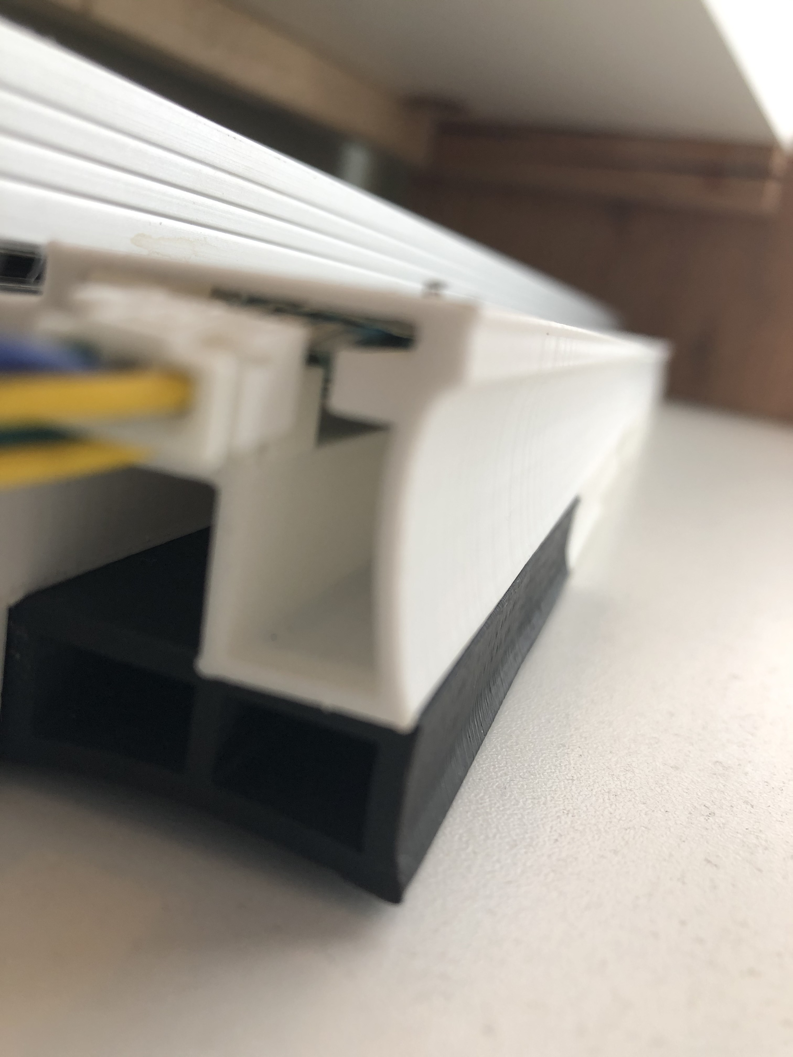
Images/general assembly/IMG_2813.JPG
