udellc/Optron/Images/general assembly/IR/cad/chopped_step_1.png

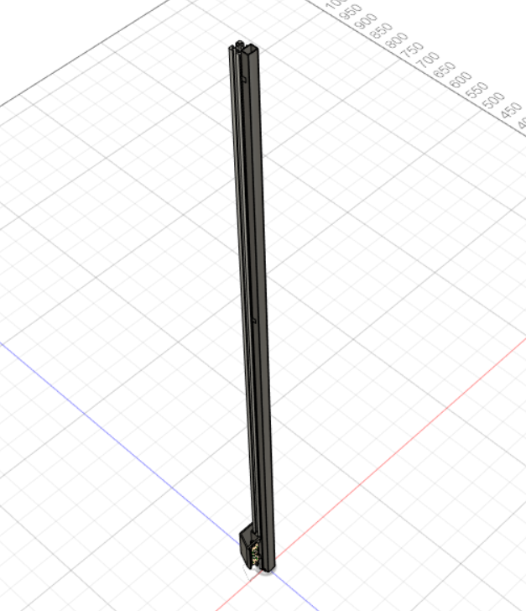
Images/general assembly/IR/cad/chopped_step_1.png
