udellc/Optron/Images/general assembly/IR/cad/step_1.png

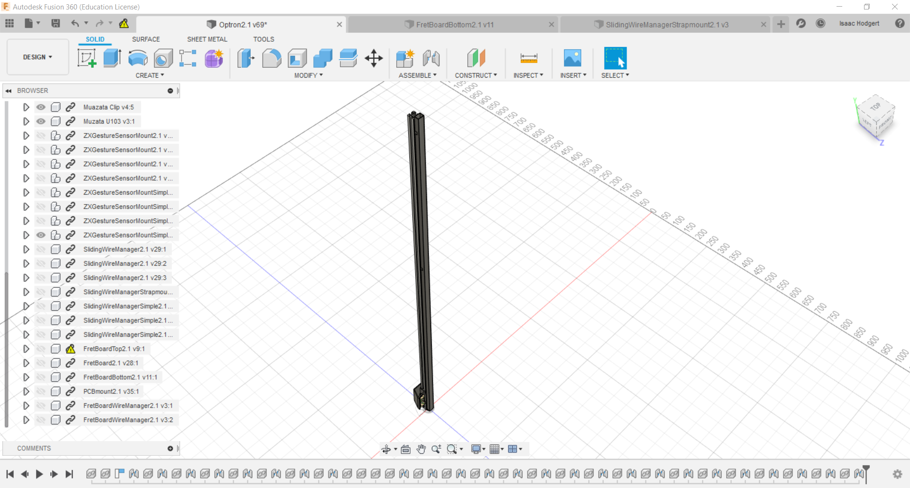
Images/general assembly/IR/cad/step_1.png
