udellc/Optron/Images/general assembly/IR/cad/step_12.png

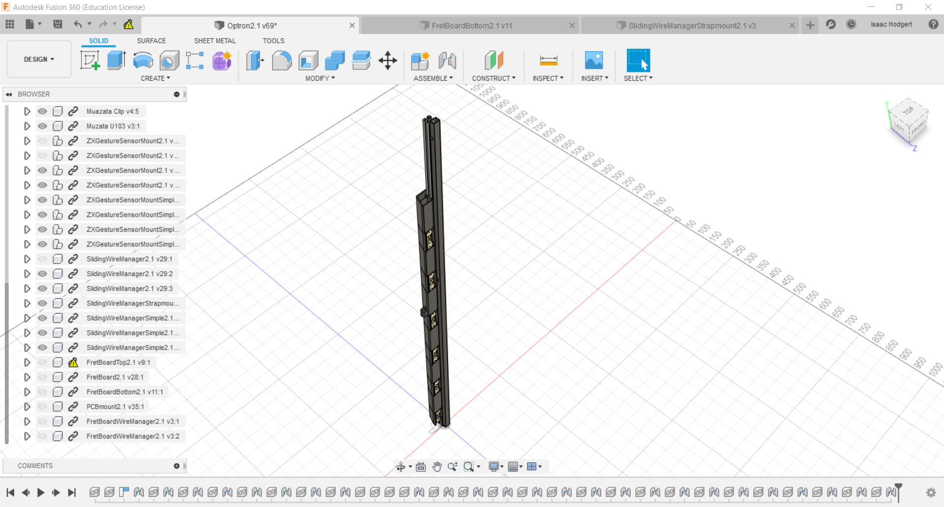
Images/general assembly/IR/cad/step_12.png
