udellc/Optron/Images/general assembly/IR/IMG_2630.JPG

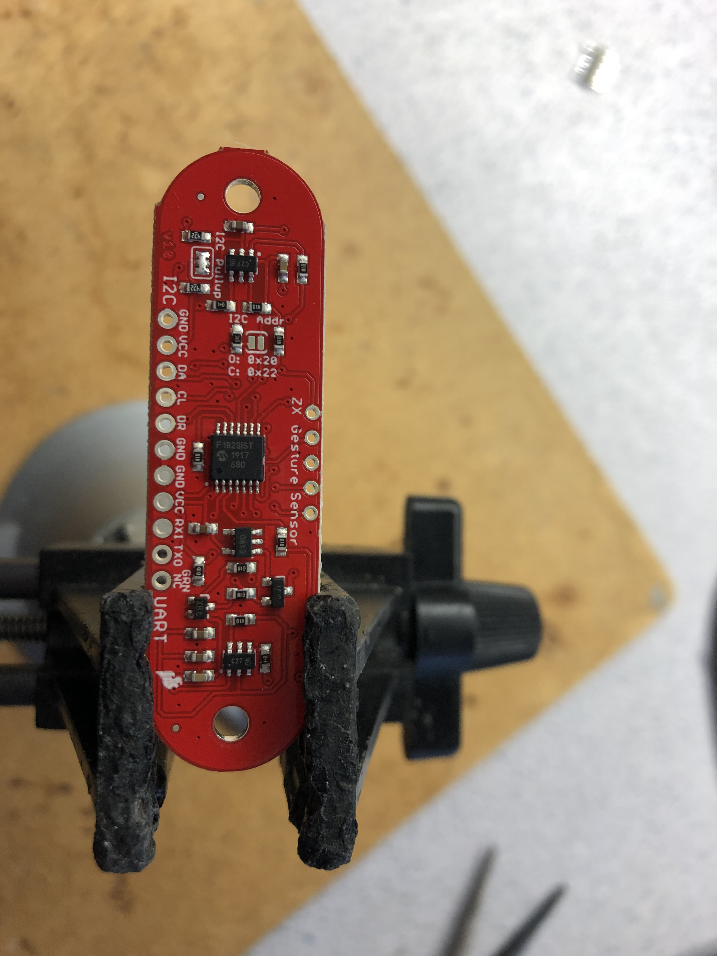
Images/general assembly/IR/IMG_2630.JPG
