udellc/Optron/Images/general assembly/IR/IMG_2631.JPG

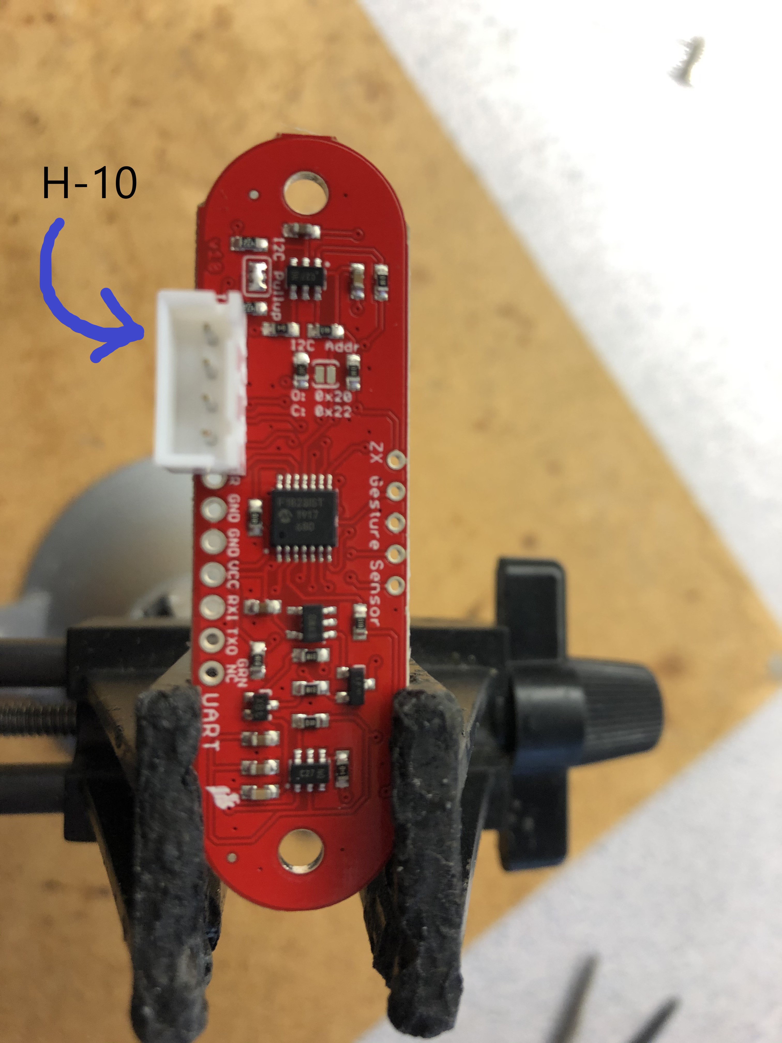
Images/general assembly/IR/IMG_2631.JPG
