udellc/Optron/Images/general assembly/IR/IMG_2646.JPG

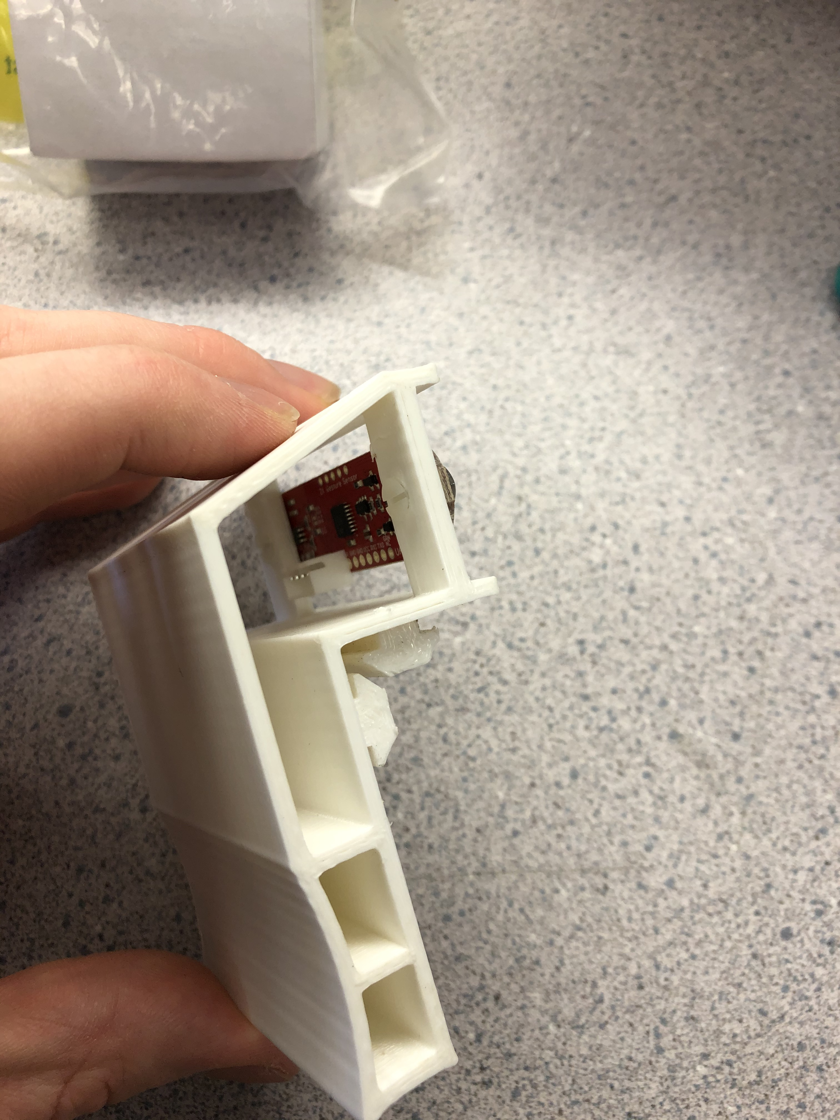
Images/general assembly/IR/IMG_2646.JPG
