udellc/Optron/Images/general assembly/IR/IMG_2647.JPG

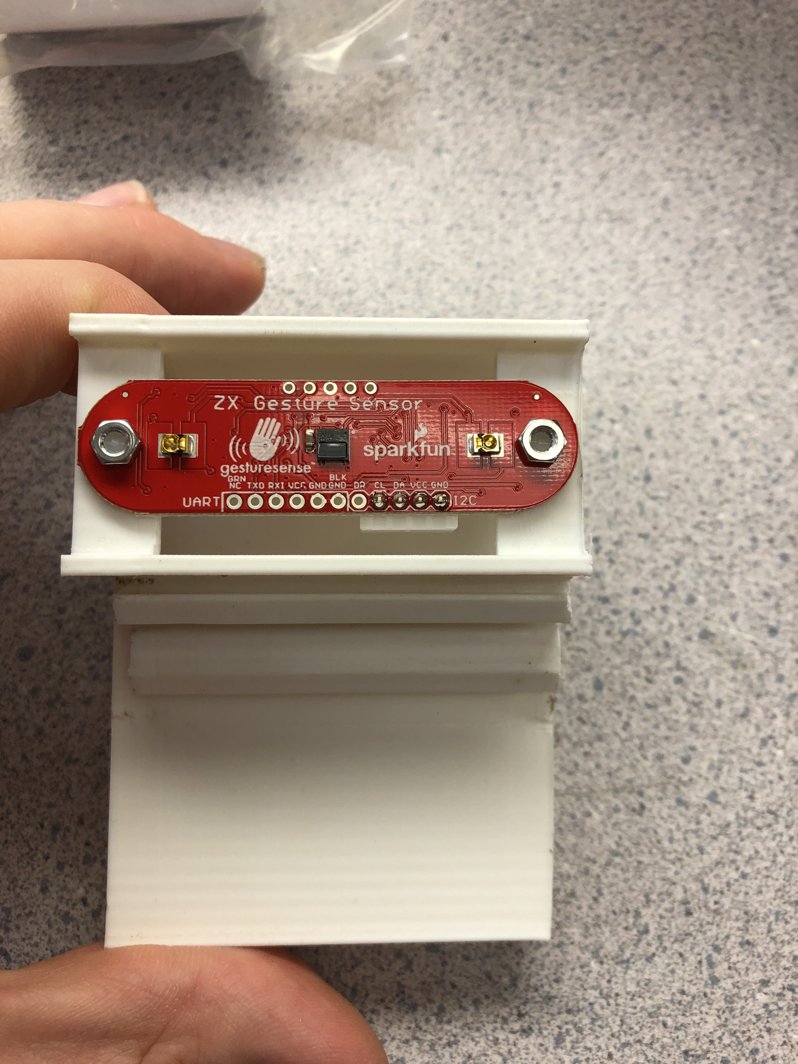
Images/general assembly/IR/IMG_2647.JPG
