udellc/Optron/Images/general assembly/IR/IMG_2668.JPG

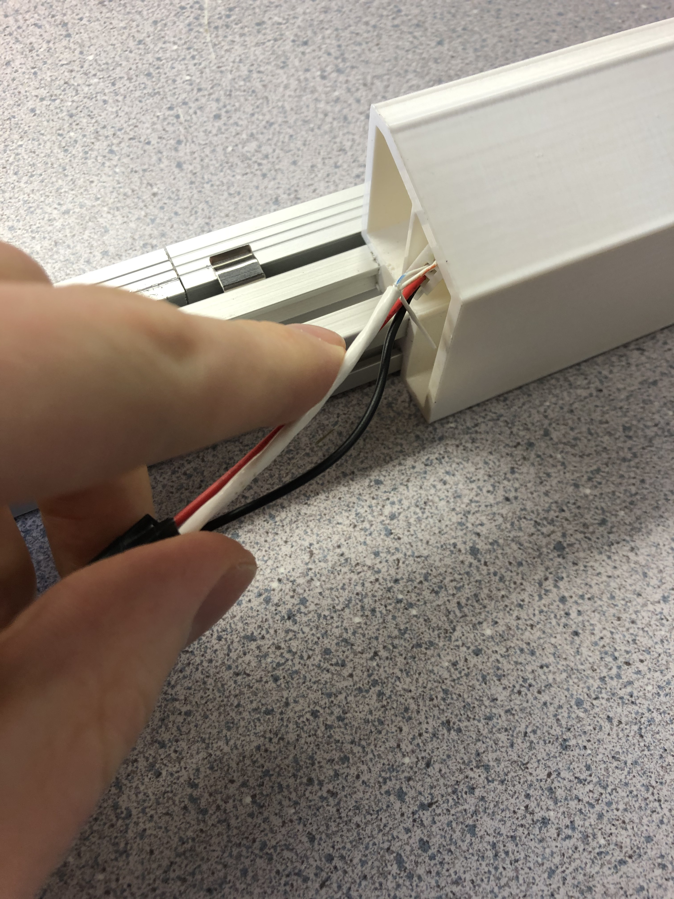
Images/general assembly/IR/IMG_2668.JPG
