udellc/Optron/Images/general assembly/IR/IMG_2669.JPG

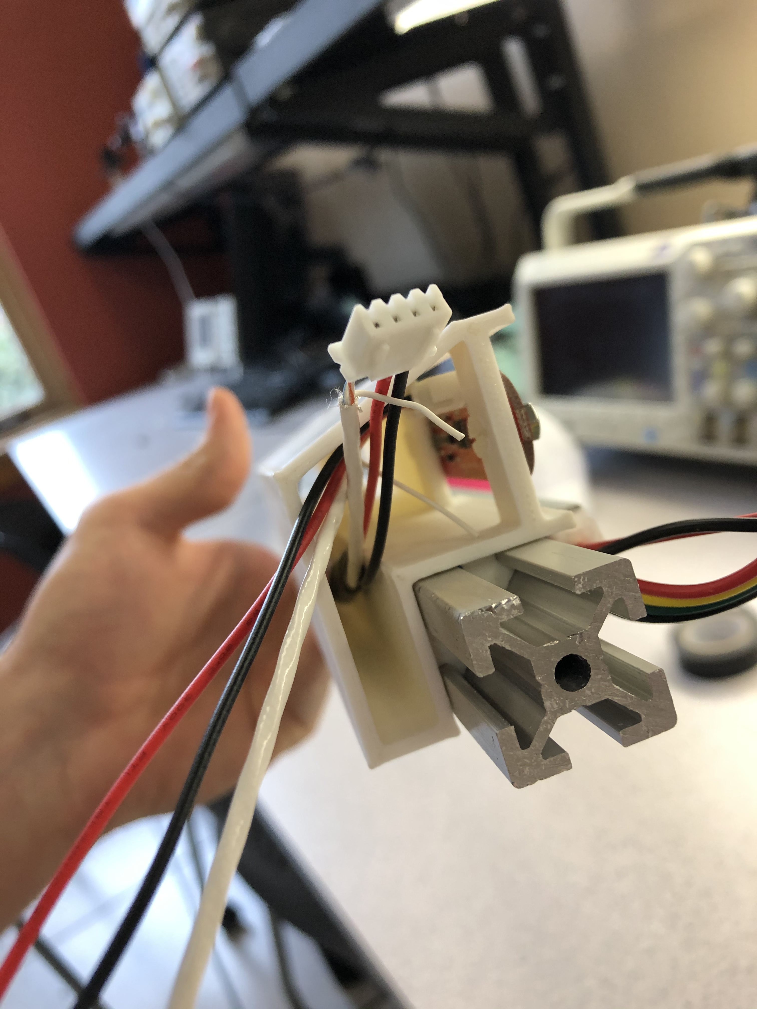
Images/general assembly/IR/IMG_2669.JPG
