udellc/Optron/Images/general assembly/JST/IMG_2648.JPG

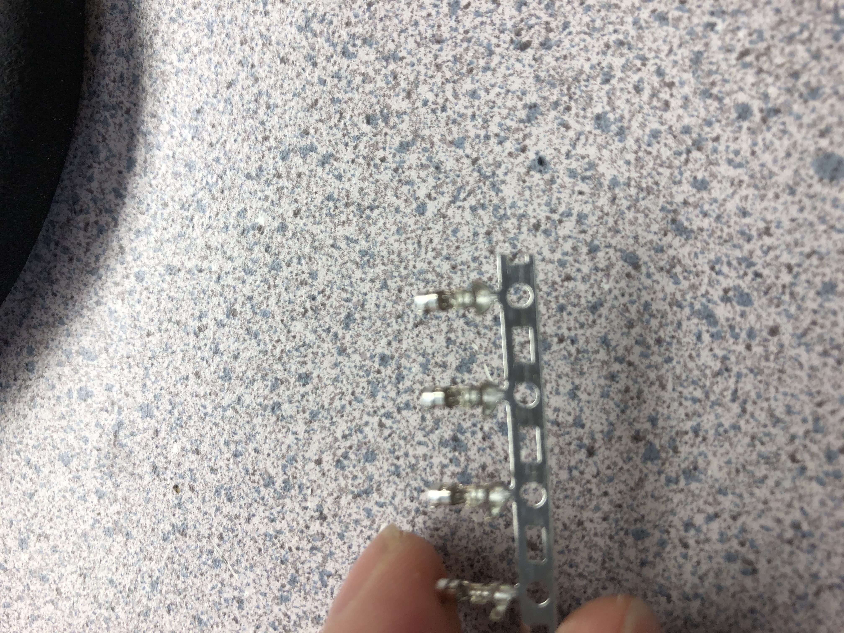
Images/general assembly/JST/IMG_2648.JPG
