udellc/Optron/Images/general assembly/JST/IMG_2650.JPG

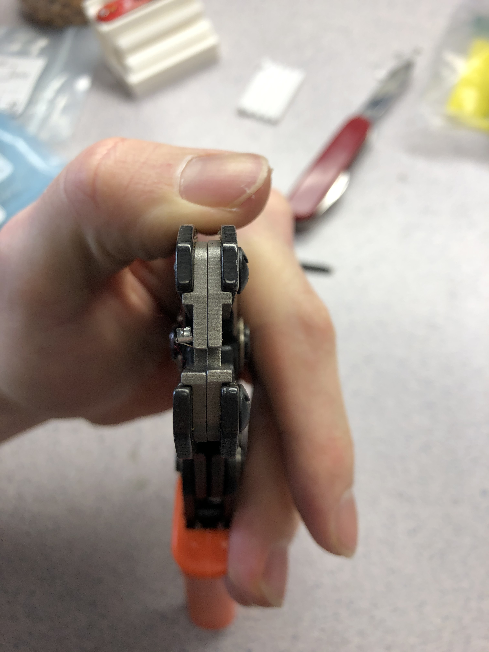
Images/general assembly/JST/IMG_2650.JPG
