udellc/Optron/Images/general assembly/JST/IMG_2651.JPG

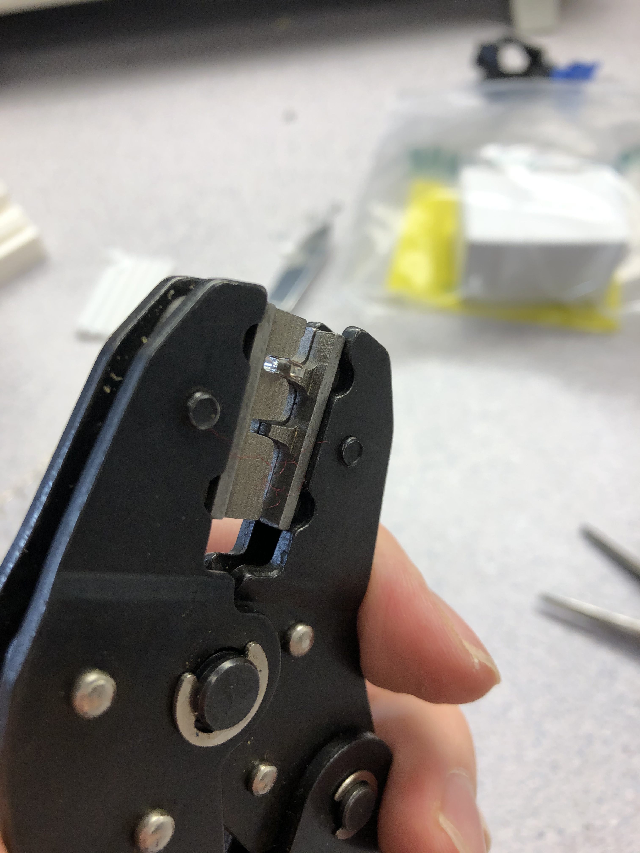
Images/general assembly/JST/IMG_2651.JPG
