udellc/Optron/Images/general assembly/JST/IMG_2652.JPG

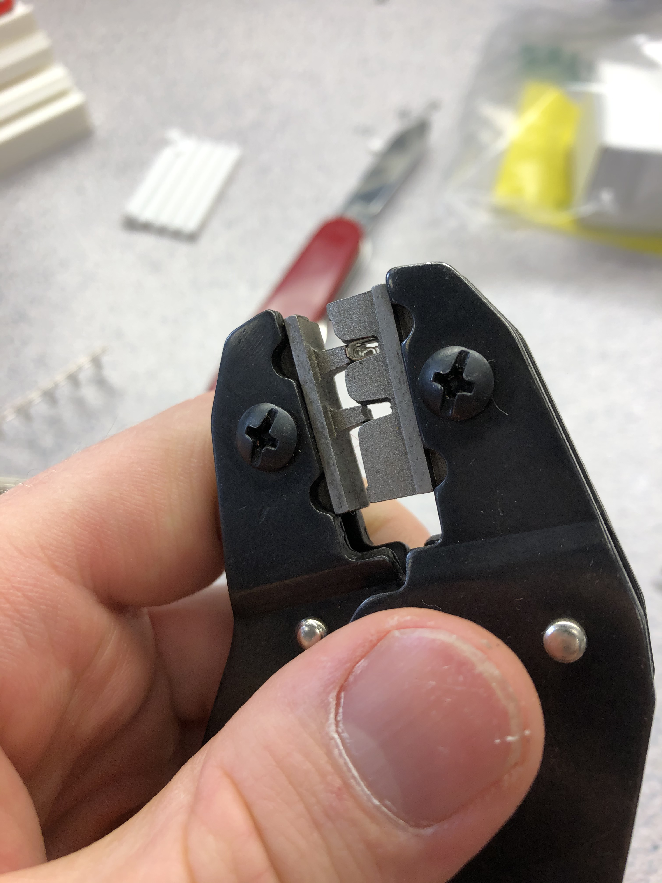
Images/general assembly/JST/IMG_2652.JPG
