udellc/Optron/Images/general assembly/JST/IMG_2653.JPG

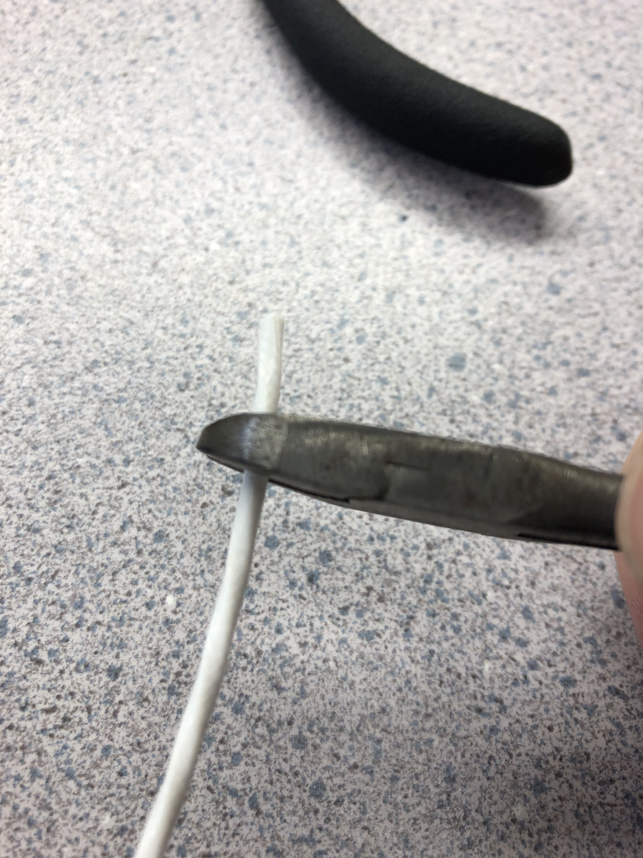
Images/general assembly/JST/IMG_2653.JPG
