udellc/Optron/Images/general assembly/JST/IMG_2658.JPG

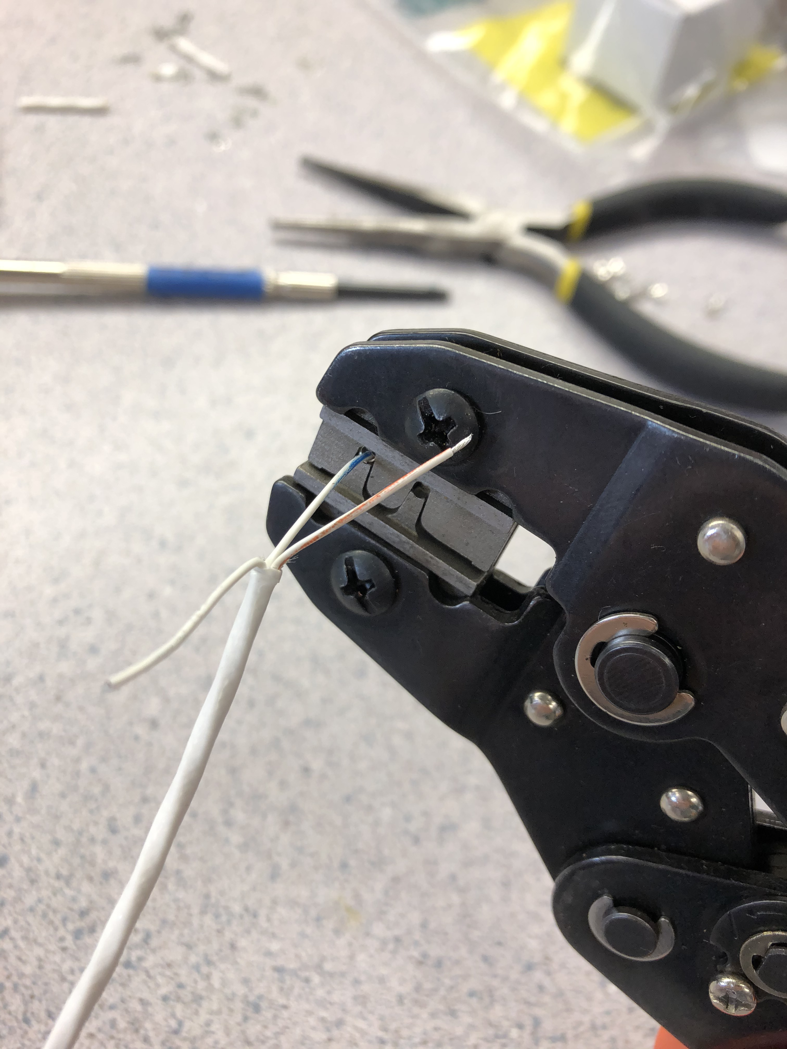
Images/general assembly/JST/IMG_2658.JPG
