udellc/Optron/Images/general assembly/JST/IMG_2659.JPG

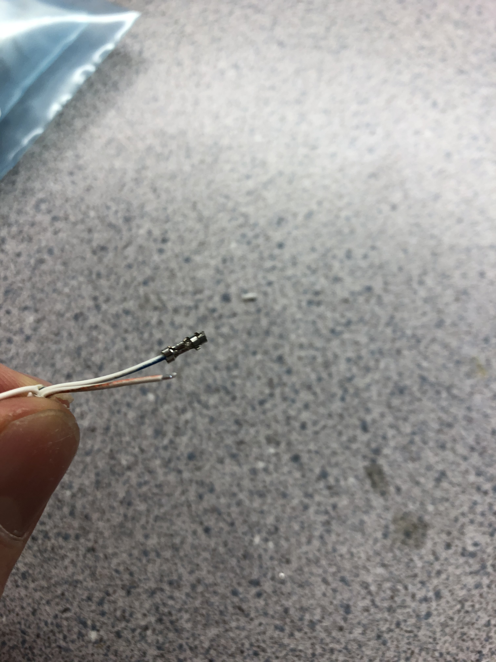
Images/general assembly/JST/IMG_2659.JPG
