udellc/Optron/Images/general assembly/JST/IMG_2661.JPG

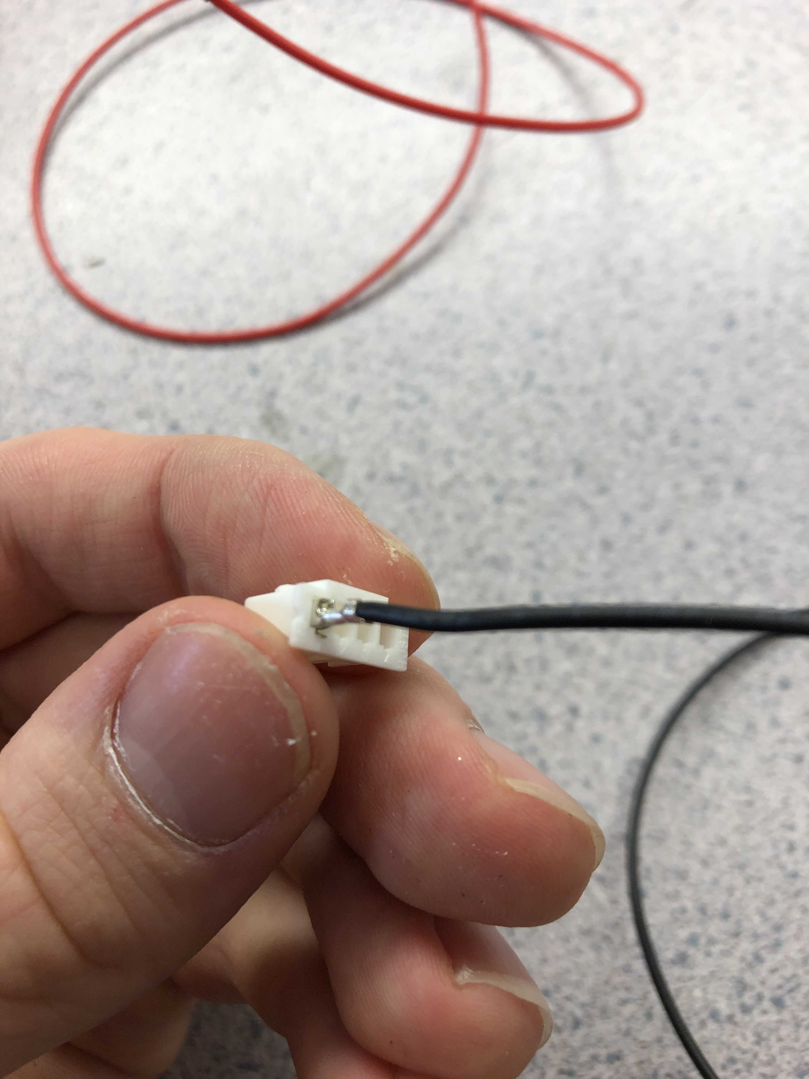
Images/general assembly/JST/IMG_2661.JPG
