udellc/Optron/Images/general assembly/JST/IMG_2662.JPG

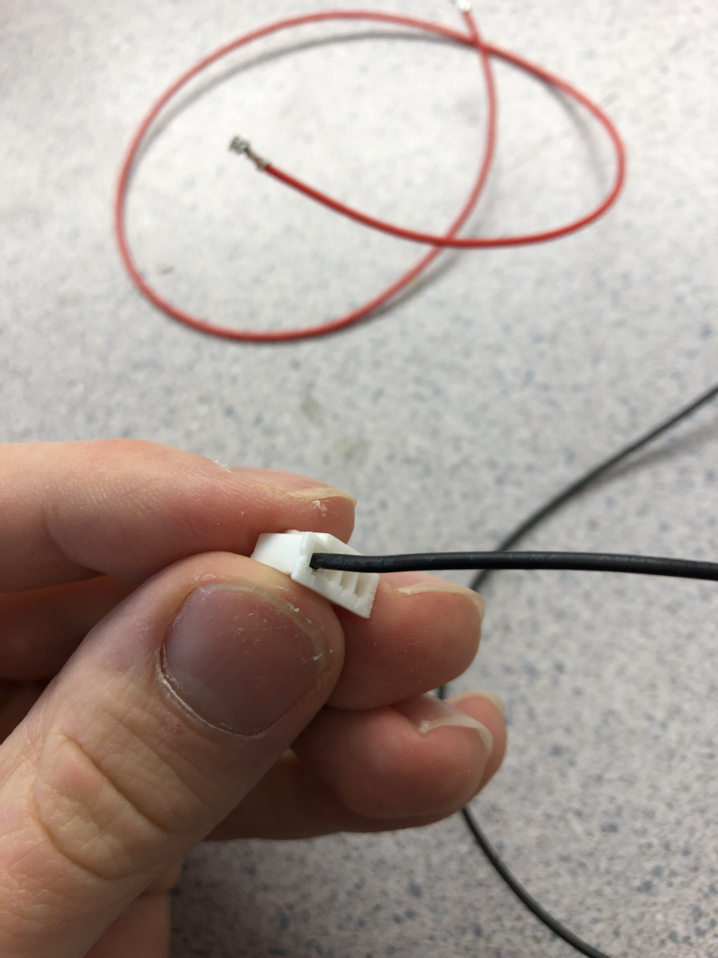
Images/general assembly/JST/IMG_2662.JPG
