udellc/Optron/Images/general assembly/LED/IMG_2632.JPG

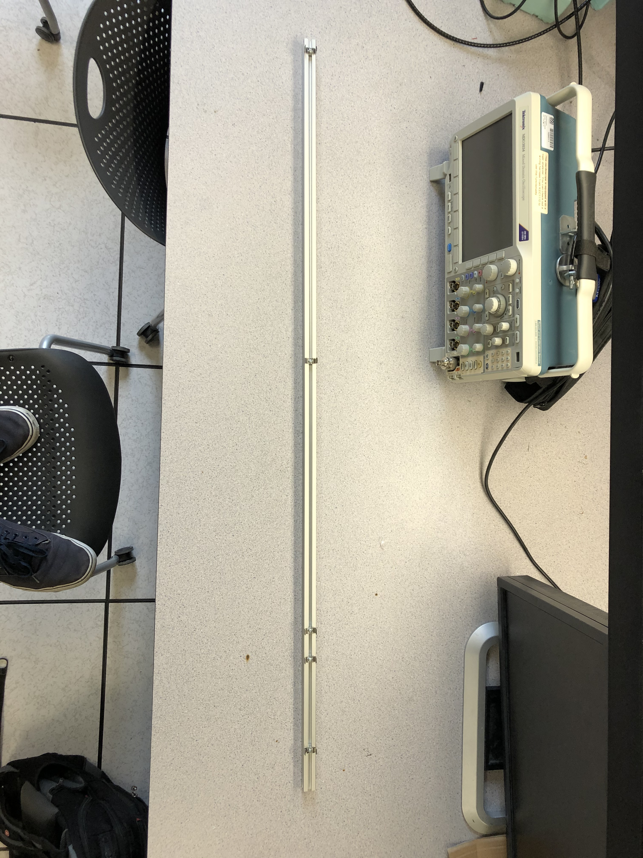
Images/general assembly/LED/IMG_2632.JPG
