udellc/Optron/Images/general assembly/LED/IMG_2636_edited.jpg

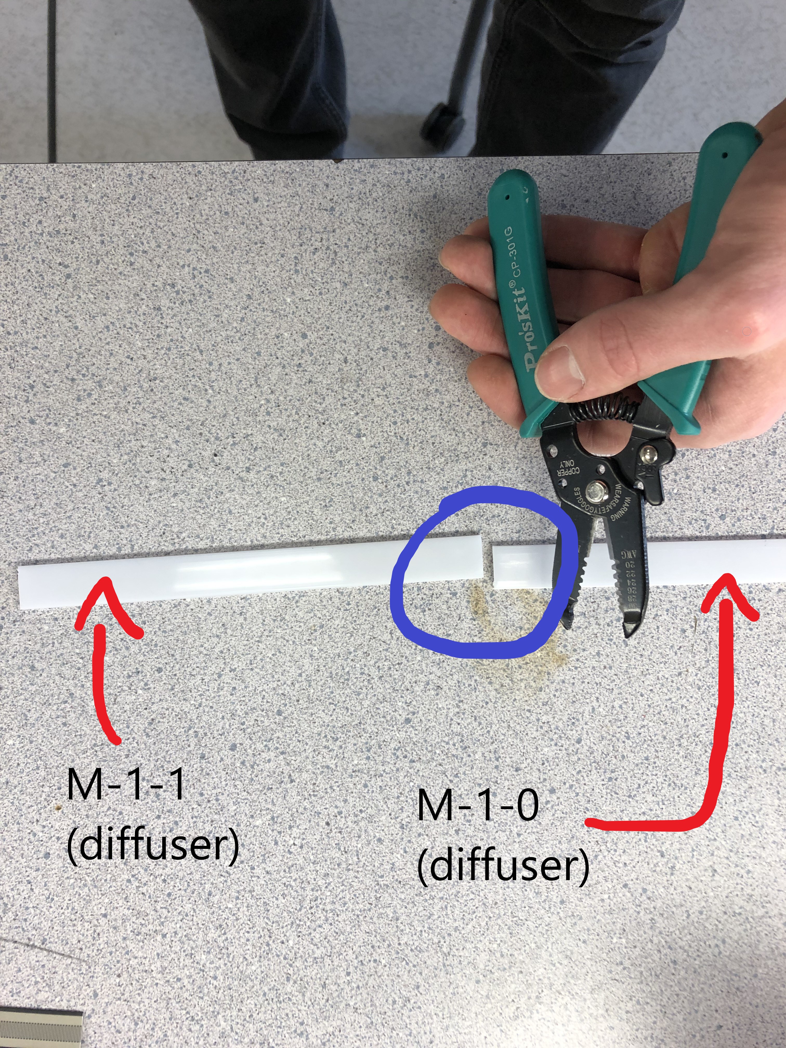
Images/general assembly/LED/IMG_2636_edited.jpg
