udellc/Optron/Images/general assembly/LED/IMG_2638.JPG

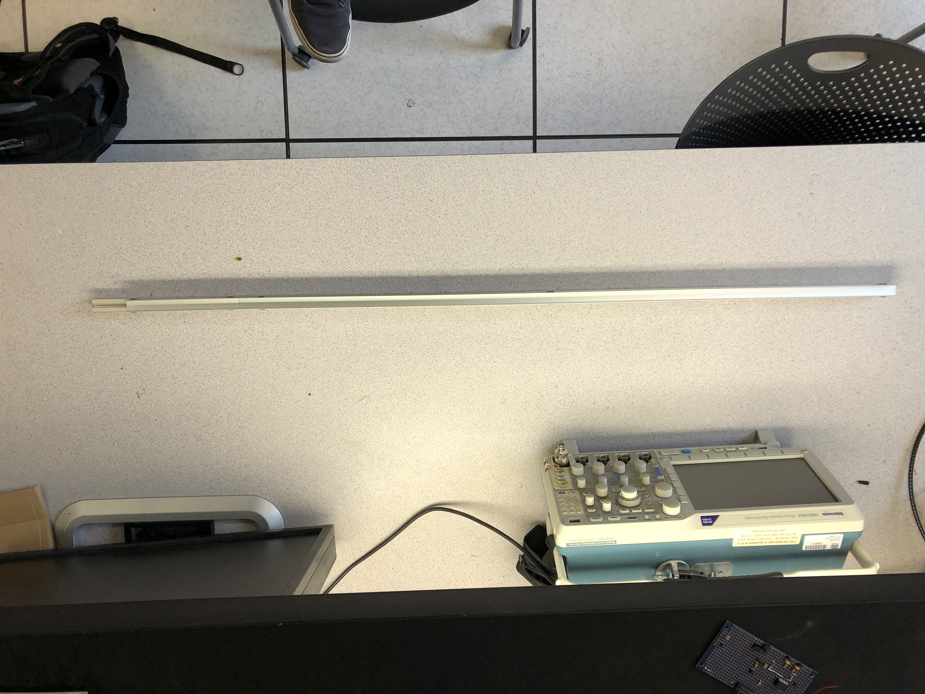
Images/general assembly/LED/IMG_2638.JPG
