udellc/Optron/Images/general assembly/LED/IMG_2641_edited.jpg

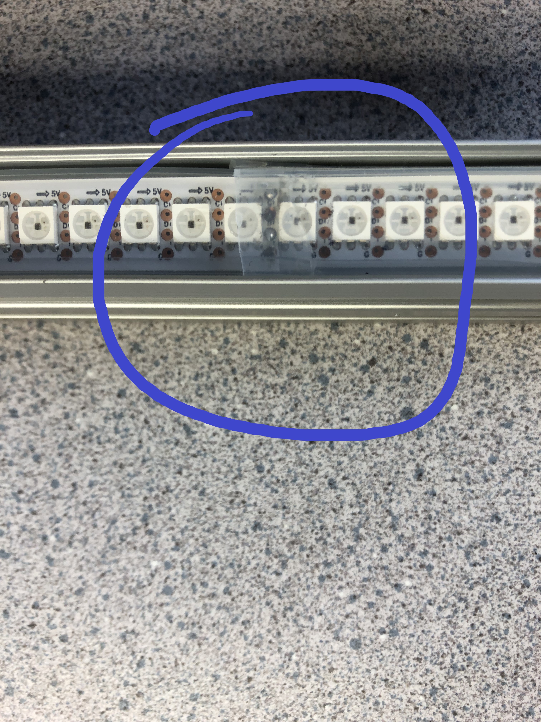
Images/general assembly/LED/IMG_2641_edited.jpg
