udellc/Optron/Images/general assembly/LED/sliding_tnut_inuse.jpg

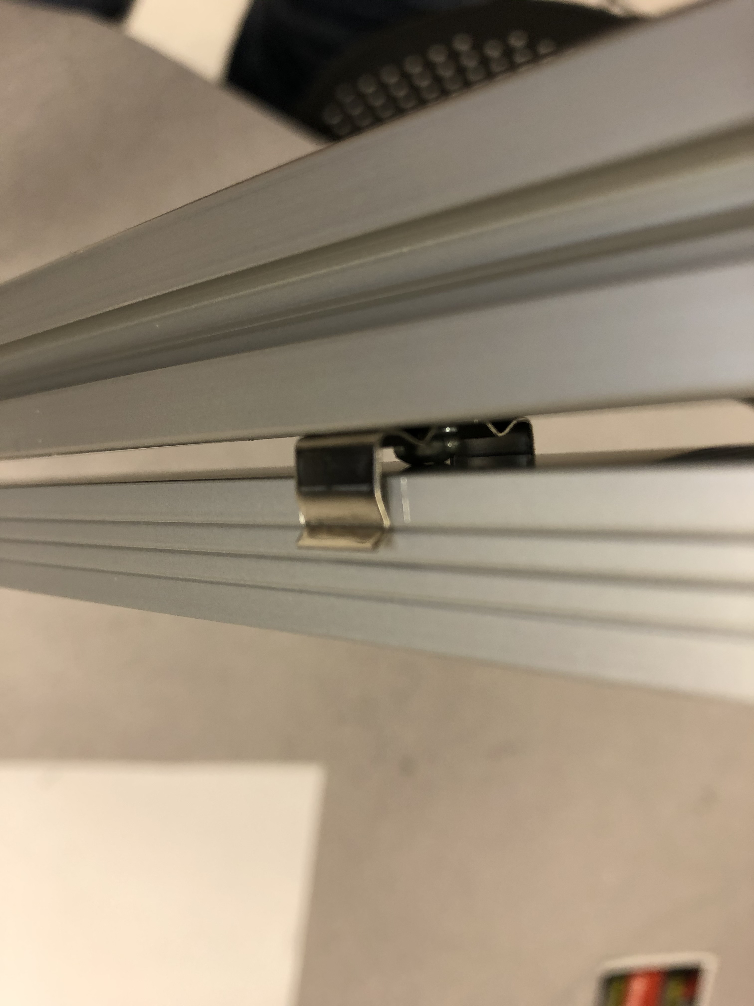
Images/general assembly/LED/sliding_tnut_inuse.jpg
