udellc/Optron/Images/general assembly/MPU/IMG_2808.JPG

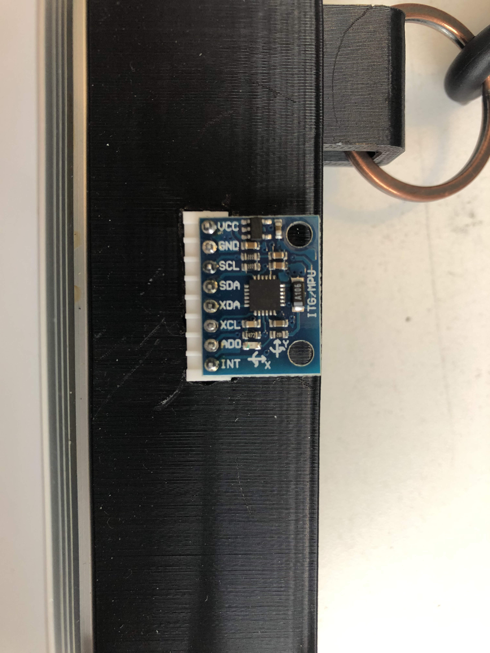
Images/general assembly/MPU/IMG_2808.JPG
