udellc/Optron/Images/general assembly/PCB/ataching pcb mount top.png

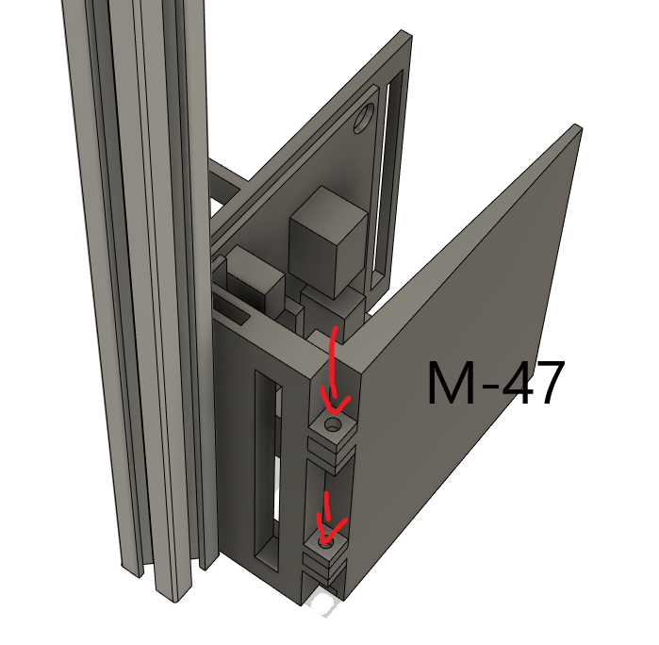
Images/general assembly/PCB/ataching pcb mount top.png
