udellc/Optron/Images/general assembly/PCB/attaching main pcb to bottom.png

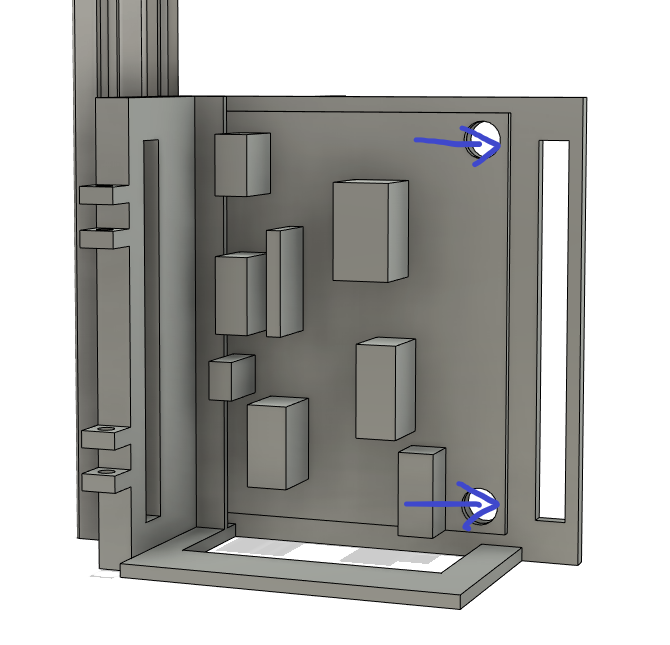
Images/general assembly/PCB/attaching main pcb to bottom.png
