udellc/Optron/Images/general assembly/PCB/sliding on PCB mount bottom.png

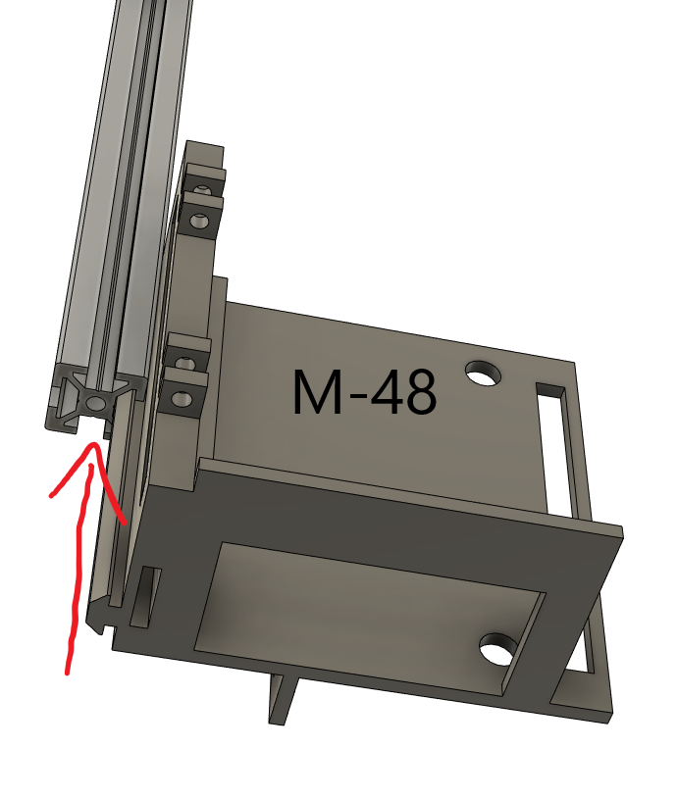
Images/general assembly/PCB/sliding on PCB mount bottom.png
