udellc/Optron/PCBs/PCB2.1.0/OptronV7_PCB.brd

## EAGLE design PCBs/PCB2.1.0/OptronV7_PCB.brd (2020-05-01)

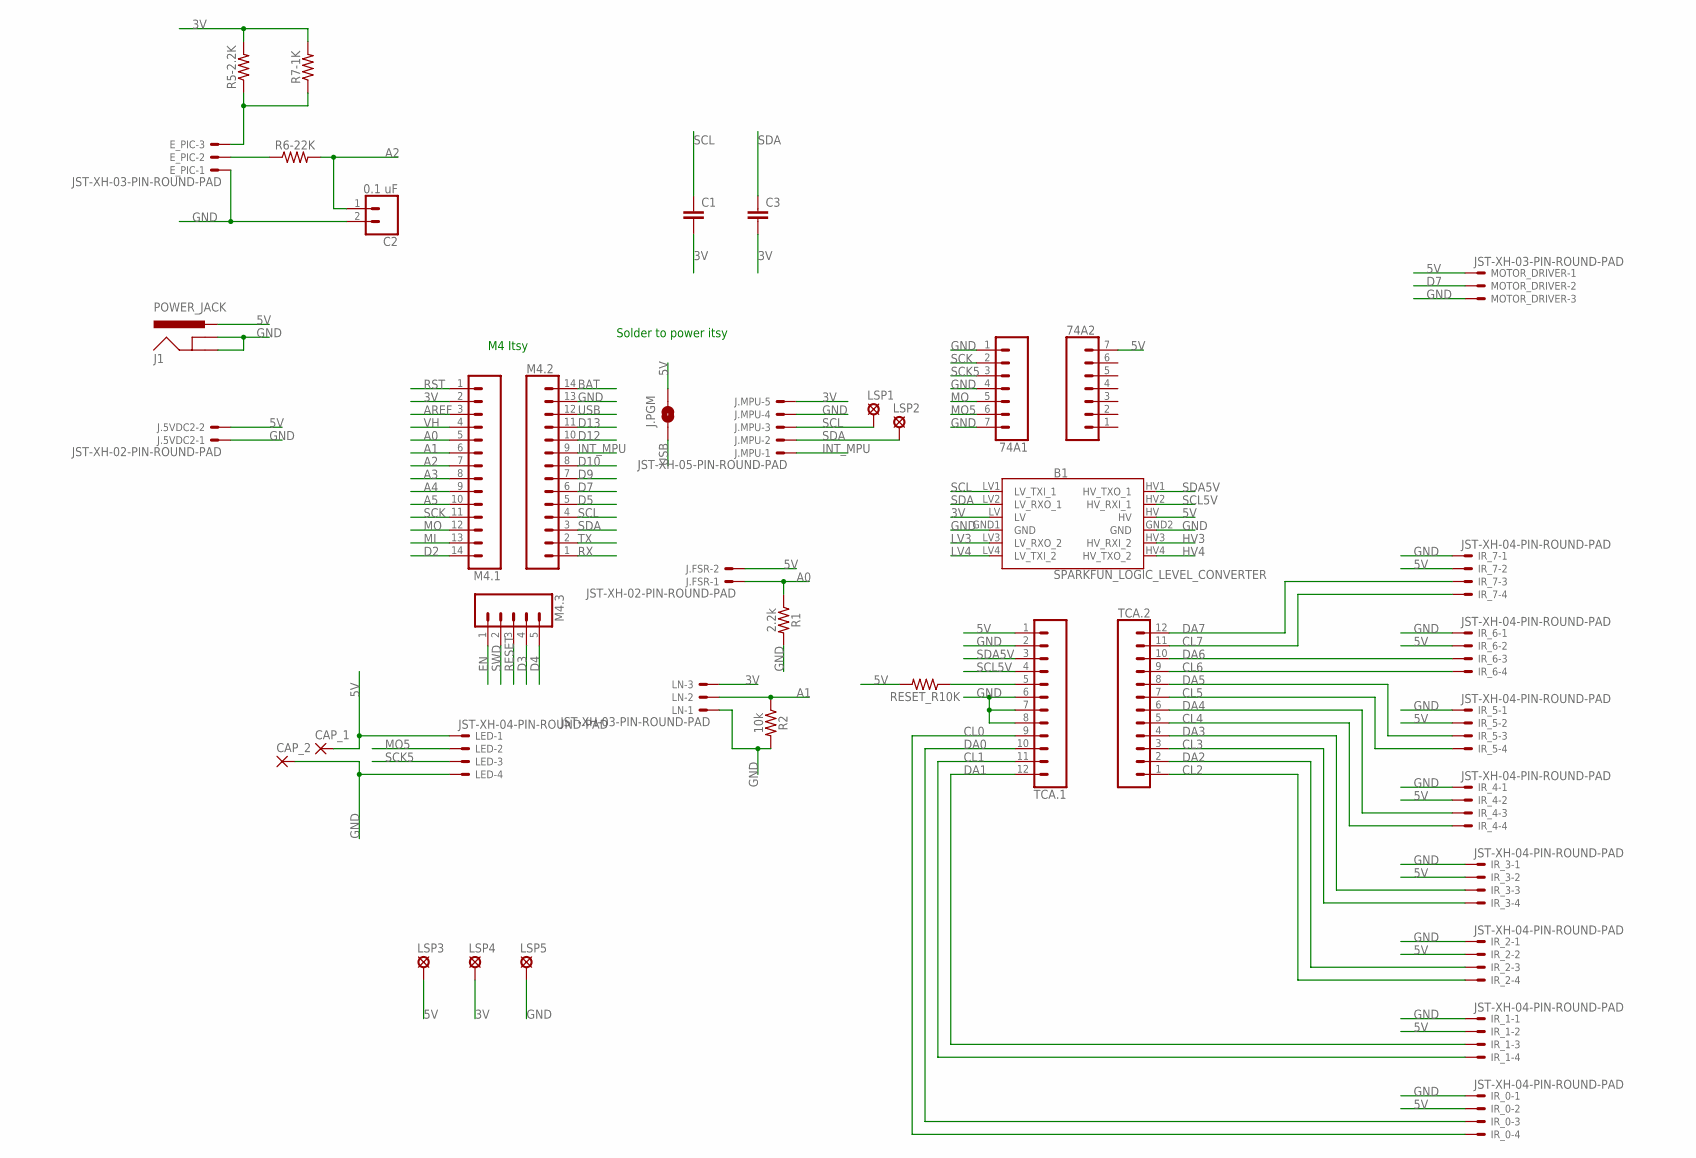
[picture p116: schematic OptronV7_PCB.sch]

Parts:
74A1, 74A2: CONN_07; 1X07
B1: SPARKFUN_LOGIC_LEVEL_CONVERTER
C1, C3: C5/2.5; C5B2.5
C2: 0.1 uF; 1X02
CAP_1, CAP_2: 1,6/0,8
E_PIC: JST-XH-03-PIN-ROUND-PAD; JST-XH-03-PACKAGE-ROUND-PAD
IR_0, IR_1, IR_2, IR_3, IR_4, IR_5, IR_6, IR_7: JST-XH-04-PIN-ROUND-PAD; JST-XH-04-PACKAGE-ROUND-PAD
J1: POWER_JACK; POWER_JACK_PTH
J.5VDC2, J.FSR: JST-XH-02-PIN-ROUND-PAD; JST-XH-02-PACKAGE-ROUND-PAD
J.MPU: JST-XH-05-PIN-ROUND-PAD; JST-XH-05-PACKAGE-ROUND-PAD
J.PGM: JUMPER-SMT_2_NO_NO-SILK; SMT-JUMPER_2_NO_NO-SILK
LED: JST-XH-04-PIN-ROUND-PAD; JST-XH-04-PACKAGE-ROUND-PAD
LN: JST-XH-03-PIN-ROUND-PAD; JST-XH-03-PACKAGE-ROUND-PAD
LSP1, LSP2, LSP3, LSP4, LSP5: MCS08
M4.1, M4.2: CONN_14; 1X14
M4.3: CONN_05; 1X05
MOTOR_DRIVER: JST-XH-03-PIN-ROUND-PAD; JST-XH-03-PACKAGE-ROUND-PAD
R1: 2.2k; AXIAL-0.3
R2: 10k; AXIAL-0.3
R5-2.2K, R6-22K, R7-1K: AXIAL-0.3
RESET_R10K: AXIAL-0.3
TCA.1, TCA.2: CONN_12; 1X12

Connections:
3V: B1.LV, C1.2, C3.2, J.MPU.5, LN.3, LSP4.MP, M4.1.2, R5-2.2K.P$2 (2), R7-1K.P$2 (2)
5V: 74A2.7, B1.HV, CAP_1.1, IR_0.2, IR_1.2, IR_2.2, IR_3.2, IR_4.2, IR_5.2, IR_6.2, IR_7.2, J1.PWR, J.5VDC2.2, J.FSR.2, J.PGM.2, LED.1, LSP3.MP, MOTOR_DRIVER.1, RESET_R10K.P$2 (2), TCA.1.1
A0: J.FSR.1, M4.1.5, R1.P$1 (1)
A1: LN.2, M4.1.6, R2.P$1 (1)
A2: C2.1, M4.1.7, R6-22K.P$2 (2)
A3: M4.1.8
A4: M4.1.9
A5: M4.1.10
AREF: M4.1.3
BAT: M4.2.14
CL0: IR_0.4, TCA.1.9
CL1: IR_1.4, TCA.1.11
CL2: IR_2.4, TCA.2.1
CL3: IR_3.4, TCA.2.3
CL4: IR_4.4, TCA.2.5
CL5: IR_5.4, TCA.2.7
CL6: IR_6.4, TCA.2.9
CL7: IR_7.4, TCA.2.11
D2: M4.1.14
D3: M4.3.4
D4: M4.3.5
D5: M4.2.5
D7: M4.2.6, MOTOR_DRIVER.2
D9: M4.2.7
D10: M4.2.8
D12: M4.2.10
D13: M4.2.11
DA0: IR_0.3, TCA.1.10
DA1: IR_1.3, TCA.1.12
DA2: IR_2.3, TCA.2.2
DA3: IR_3.3, TCA.2.4
DA4: IR_4.3, TCA.2.6
DA5: IR_5.3, TCA.2.8
DA6: IR_6.3, TCA.2.10
DA7: IR_7.3, TCA.2.12
EN: M4.3.1
GND: 74A1.1, 74A1.4, 74A1.7, B1.GND1 (GND), B1.GND2 (GND), C2.2, CAP_2.1, E_PIC.1, IR_0.1, IR_1.1, IR_2.1, IR_3.1, IR_4.1, IR_5.1, IR_6.1, IR_7.1, J1.GND, J1.GNDBREAK, J.5VDC2.1, J.MPU.4, LED.4, LN.1, LSP5.MP, M4.2.13, MOTOR_DRIVER.3, R1.P$2 (2), R2.P$2 (2), TCA.1.2, TCA.1.6, TCA.1.7, TCA.1.8
HV3: B1.HV3 (HV_RXI_2)
HV4: B1.HV4 (HV_TXO_2)
INT_MPU: J.MPU.1, M4.2.9
LV3: B1.LV3 (LV_RXO_2)
LV4: B1.LV4 (LV_TXI_2)
MI: M4.1.13
MO: 74A1.5, M4.1.12
MO5: 74A1.6, LED.2
unnamed: RESET_R10K.P$1 (1), TCA.1.5
unnamed: E_PIC.3, R5-2.2K.P$1 (1), R7-1K.P$1 (1)
unnamed: E_PIC.2, R6-22K.P$1 (1)
RESET: M4.3.3
RST: M4.1.1
RX: M4.2.1
SCK: 74A1.2, M4.1.11
SCK5: 74A1.3, LED.3
SCL: B1.LV1 (LV_TXI_1), C1.1, J.MPU.3, LSP1.MP, M4.2.4
SCL5V: B1.HV2 (HV_RXI_1), TCA.1.4
SDA: B1.LV2 (LV_RXO_1), C3.1, J.MPU.2, LSP2.MP, M4.2.3
SDA5V: B1.HV1 (HV_TXO_1), TCA.1.3
SWD: M4.3.2
TX: M4.2.2
USB: J.PGM.1, M4.2.12
VH: M4.1.4

Notes on the sheet:
M4 Itsy
Solder to power itsy

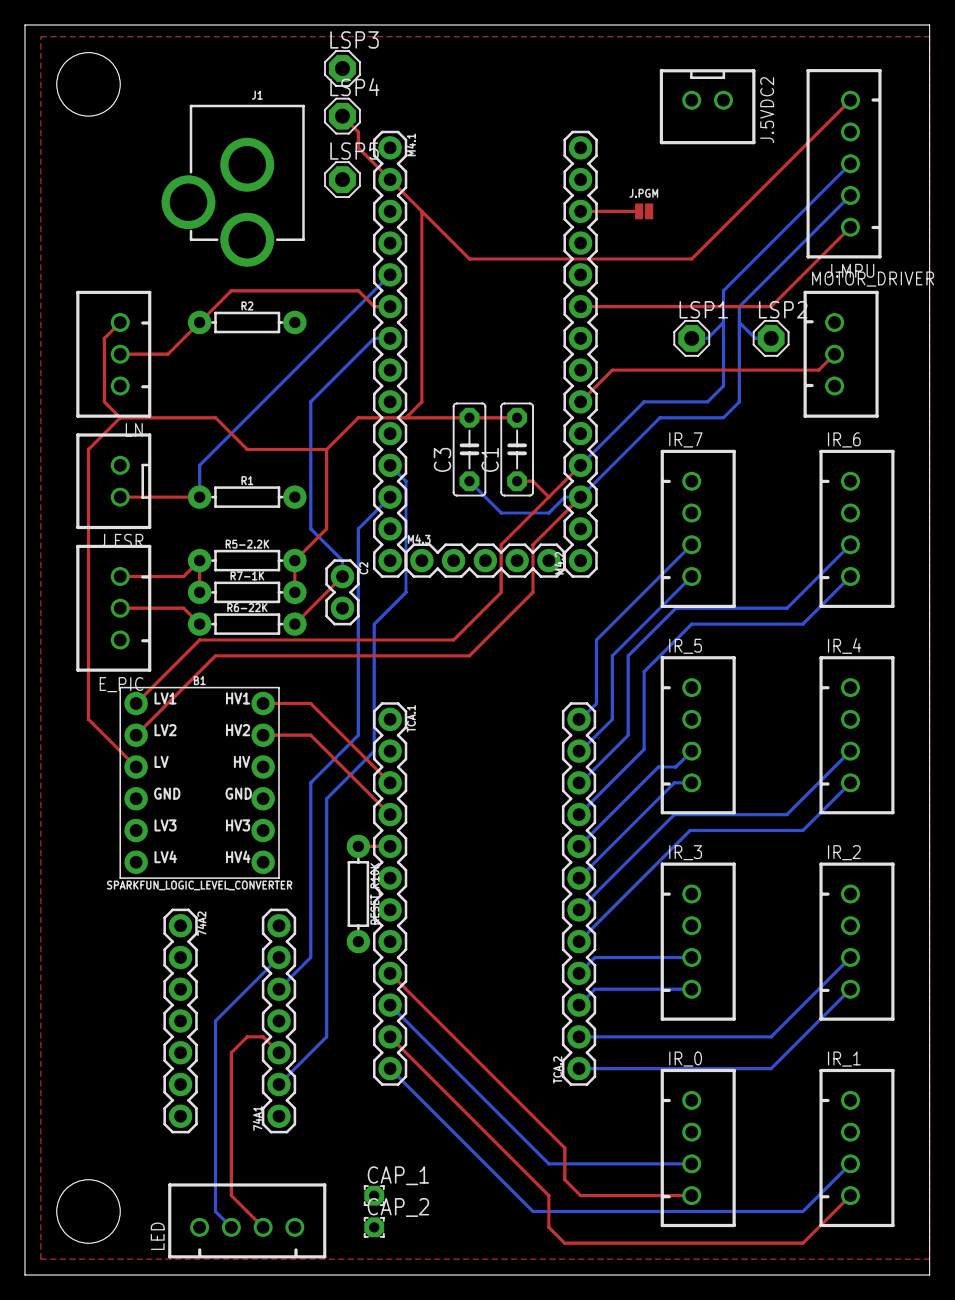
[picture p117: board PCBs/PCB2.1.0/OptronV7_PCB.brd from above]

Board: 2 copper layers, 72.4 x 100.0 mm, 41 parts (0 on the bottom side), 36 nets.
