udellc/Optron/PCBs/PCB 2.0.X/OptronV7_PCB.brd

## EAGLE design PCBs/PCB 2.0.X/OptronV7_PCB.brd (2019-10-12)

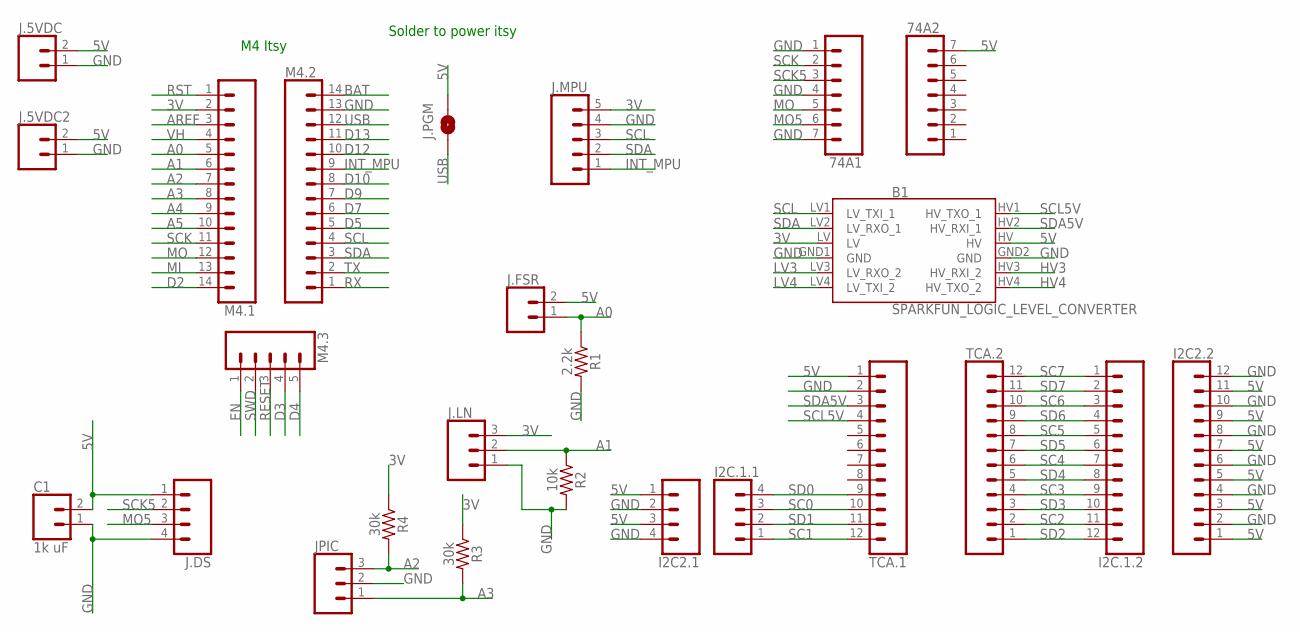
[picture p118: schematic OptronV7_PCB.sch]

Parts:
74A1, 74A2: CONN_07; 1X07
B1: SPARKFUN_LOGIC_LEVEL_CONVERTER
C1: 1k uF; 1X02
I2C2.1, I2C.1.1: CONN_04; 1X04
I2C2.2, I2C.1.2: CONN_12; 1X12
J.5VDC, J.5VDC2, J.FSR: CONN_02; 1X02
J.DS: CONN_04; 1X04
J.LN: CONN_03; 1X03
J.MPU: CONN_05; 1X05
J.PGM: JUMPER-SMT_2_NO_NO-SILK; SMT-JUMPER_2_NO_NO-SILK
JPIC: CONN_03; 1X03
M4.1, M4.2: CONN_14; 1X14
M4.3: CONN_05; 1X05
R1: 2.2k; AXIAL-0.3
R2: 10k; AXIAL-0.3
R3, R4: 30k; AXIAL-0.3
TCA.1, TCA.2: CONN_12; 1X12

Connections:
3V: B1.LV, J.LN.3, J.MPU.5, M4.1.2, R3.P$1 (1), R4.P$1 (1)
5V: 74A2.7, B1.HV, C1.2, I2C2.1.1, I2C2.1.3, I2C2.2.1, I2C2.2.3, I2C2.2.5, I2C2.2.7, I2C2.2.9, I2C2.2.11, J.5VDC.2, J.5VDC2.2, J.DS.1, J.FSR.2, J.PGM.2, TCA.1.1
A0: J.FSR.1, M4.1.5, R1.P$1 (1)
A1: J.LN.2, M4.1.6, R2.P$1 (1)
A2: JPIC.3, M4.1.7, R4.P$2 (2)
A3: JPIC.1, M4.1.8, R3.P$2 (2)
A4: M4.1.9
A5: M4.1.10
AREF: M4.1.3
BAT: M4.2.14
D2: M4.1.14
D3: M4.3.4
D4: M4.3.5
D5: M4.2.5
D7: M4.2.6
D9: M4.2.7
D10: M4.2.8
D12: M4.2.10
D13: M4.2.11
EN: M4.3.1
GND: 74A1.1, 74A1.4, 74A1.7, B1.GND1 (GND), B1.GND2 (GND), C1.1, I2C2.1.2, I2C2.1.4, I2C2.2.2, I2C2.2.4, I2C2.2.6, I2C2.2.8, I2C2.2.10, I2C2.2.12, J.5VDC.1, J.5VDC2.1, J.DS.4, J.LN.1, J.MPU.4, JPIC.2, M4.2.13, R1.P$2 (2), R2.P$2 (2), TCA.1.2
HV3: B1.HV3 (HV_RXI_2)
HV4: B1.HV4 (HV_TXO_2)
INT_MPU: J.MPU.1, M4.2.9
LV3: B1.LV3 (LV_RXO_2)
LV4: B1.LV4 (LV_TXI_2)
MI: M4.1.13
MO: 74A1.5, M4.1.12
MO5: 74A1.6, J.DS.3
RESET: M4.3.3
RST: M4.1.1
RX: M4.2.1
SC0: I2C.1.1.3, TCA.1.10
SC1: I2C.1.1.1, TCA.1.12
SC2: I2C.1.2.11, TCA.2.2
SC3: I2C.1.2.9, TCA.2.4
SC4: I2C.1.2.7, TCA.2.6
SC5: I2C.1.2.5, TCA.2.8
SC6: I2C.1.2.3, TCA.2.10
SC7: I2C.1.2.1, TCA.2.12
SCK: 74A1.2, M4.1.11
SCK5: 74A1.3, J.DS.2
SCL: B1.LV1 (LV_TXI_1), J.MPU.3, M4.2.4
SCL5V: B1.HV1 (HV_TXO_1), TCA.1.4
SD0: I2C.1.1.4, TCA.1.9
SD1: I2C.1.1.2, TCA.1.11
SD2: I2C.1.2.12, TCA.2.1
SD3: I2C.1.2.10, TCA.2.3
SD4: I2C.1.2.8, TCA.2.5
SD5: I2C.1.2.6, TCA.2.7
SD6: I2C.1.2.4, TCA.2.9
SD7: I2C.1.2.2, TCA.2.11
SDA: B1.LV2 (LV_RXO_1), J.MPU.2, M4.2.3
SDA5V: B1.HV2 (HV_RXI_1), TCA.1.3
SWD: M4.3.2
TX: M4.2.2
USB: J.PGM.1, M4.2.12
VH: M4.1.4

Notes on the sheet:
M4 Itsy
Solder to power itsy

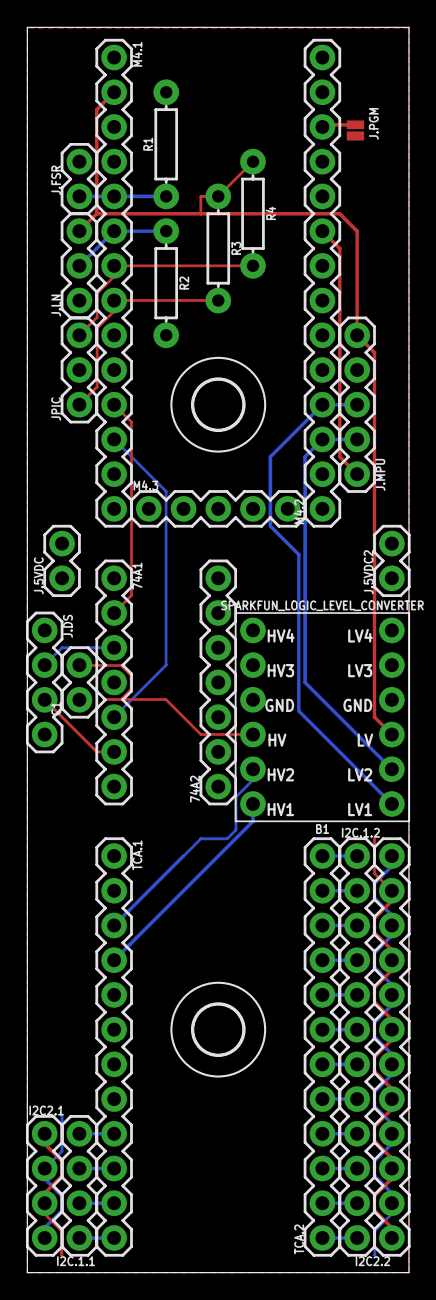
[picture p119: board PCBs/PCB 2.0.X/OptronV7_PCB.brd from above]

Board: 2 copper layers, 27.9 x 91.1 mm, 27 parts (0 on the bottom side), 33 nets.

Other parts of the board:
U$1, U$2: 3,6
