udellc/Optron/PCBs/Motor_Driver/Driver.brd

## EAGLE design PCBs/Motor_Driver/Driver.brd (2020-02-17)

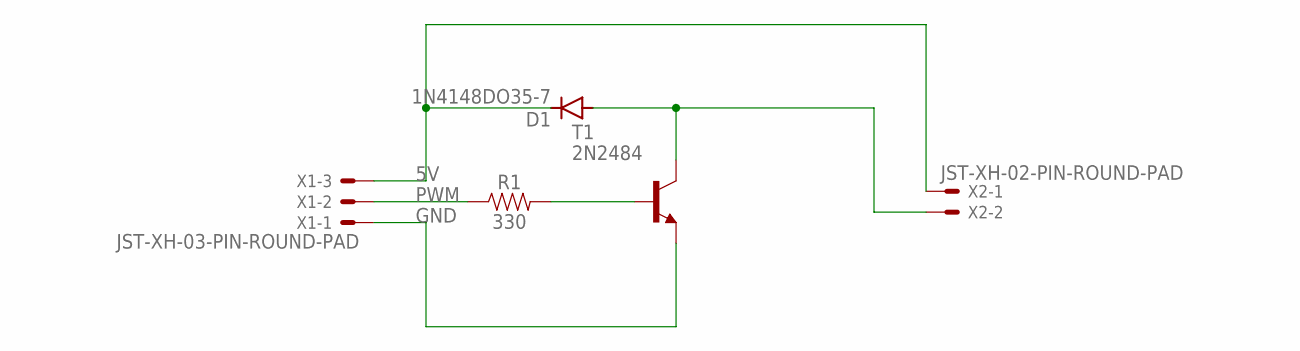
[picture p120: schematic Driver.sch]

Parts:
D1: 1N4148DO35-7; DO35-7
R1: 330; AXIAL-0.3
T1: 2N2484; TO18
X1: JST-XH-03-PIN-ROUND-PAD; JST-XH-03-PACKAGE-ROUND-PAD
X2: JST-XH-02-PIN-ROUND-PAD; JST-XH-02-PACKAGE-ROUND-PAD

Connections:
5V: D1.C, X1.3, X2.1
GND: T1.1 (E), X1.1
unnamed: R1.P$2 (2), T1.2 (B)
unnamed: D1.A, T1.3 (C), X2.2
PWM: R1.P$1 (1), X1.2

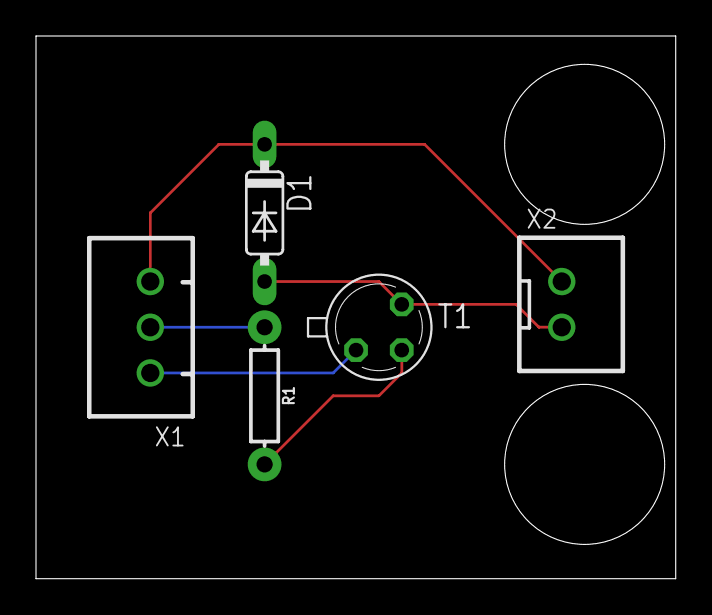
[picture p121: board Driver.brd from above]

Board: 2 copper layers, 35.5 x 30.1 mm, 5 parts (0 on the bottom side), 5 nets.
