udellc/Optron/(commit log)

2019-10-12 Optron V7 Main Adapter Board
    [OptronV7_PCB.brd, OptronV7_PCB.sch]
2019-10-22 Extrusion file from Misumi added
2019-11-21 Added ZX Gesture Sensor Mount 2.1
    [ZXGestureSensorMount2.1.stl]
2019-11-22 Fixed MPU6050 Library and function declarations
    [Headers.h]
2019-11-22 Added ZX Gesture Sensor Long Mount Clip STL
    [ZXGestureSensorLongMountClip2.1.stl]
2020-01-07 Added fret board stl's, wire manager stl's, and gesture sensor mount
    [FretBoard2.1.stl, FretBoardBottom2.1.stl, FretBoardTop2.1.stl, SlidingWireManager2.1.stl, SlidingWireManagerSimpleStrapmount2.1.stl, ZXGestureSensorMount2.1.stl]
2020-01-07 Separated 2.0 and 2.1 STLs
    [BarrelJackHolderFix.stl, CableClip1V2.stl, DiffuserBodyv1.stl, FretBoard2.1.stl, FretBoardBottom2.1.stl, FretBoardTop2.1.stl, GitStrapMount.stl, GitStrapPegTop.stl]
2020-01-07 Added pcb mount
    [PCBmount2.1.stl]
2020-01-07 Updated and added STL files
    [SlidingWireManagerSimple2.1.stl, ZXGestureSensorLongMountClip2.1.stl, ZXGestureSensorMount2.1.stl, ZXGestureSensorMountSimple2.1.stl]
2020-01-15 Updated STLs
    [FretBoard2.1.stl, FretBoardBottom2.1.stl, FretBoardTop2.1.stl, FretBoardWireManager2.1.stl, SlidingWireManager2.1.stl, SlidingWireManagerSimple2.1.stl, SlidingWireManagerSimpleStrapmount2.1.stl, SlidingWireManagerStrapmount2.1.stl]
2020-01-22 Added MPU6050 class. It is a frame right now that needs to be filled in.
2020-02-07 Added a bunch of assembly images
2020-02-08 Adding New PCB
    [OptronV7_PCB.brd, OptronV7_PCB.sch]
2020-02-09 Added a demo for branch. Works on teensy2.0.
2020-02-12 Added a bunch of images from the cad model.
2020-02-17 Added PCBs and Schematics
    [Driver.brd, Driver.sch, OptronV7_PCB.brd, OptronV7_PCB.sch]
2020-02-18 Added sliding wire manager strap mount with mpu mount.
    [SlidingWireManagerStrapmountMPU6050Mount2.1.stl]
2020-02-20 Added teflon dxf
    [Teflon.dxf]
2020-03-10 Added new PCB mount cad file
    [PCBMountBottom2.1.2.stl, PCBMountTop2.1.2.stl]
2020-03-10 Added EPick wire manager and Fretboard wire manager CAD files
    [EPickWireManager2.1.stl, FretBoardWireManager2.1.2.stl]
2020-03-10 Added BOM for Optron2.1
    [Optron2.1 BOM.xlsx]
2020-04-10 Added newest version of the PCB for review and requests for more additions.
    [OptronV7_PCB.brd, OptronV7_PCB.sch]
2020-04-17 PCB 2.1.0 added
    [OptronV7_PCB.brd, OptronV7_PCB.sch]
2020-04-20 Updated BOM
    [Optron2.1 BOM.xlsx]
2020-05-01 PCB review updates
    [OptronV7_PCB.brd, OptronV7_PCB.sch]
2020-05-02 Added brightness change-fretboard pressure
2020-05-03 Deleted previous main code in folder 'Optron2_1' and put current working code into folder titled 'Optron2.2'
2020-05-03 Made code more organized, and added toggle defines for sensing MPU and ZX sensors.
2020-05-03 Added masking of LEDs based on position sensor.
2020-05-04 Added some small bug fixes to masking.
    [LEDPatterns.ino]
2020-05-05 Added lighting control via IR sensors. Also added another sensor control panel for LEDs, and fixed up som ee-pick code.
    [E-pick.ino, Headers.h, LEDPatterns.ino, Optron2.1.ino, Patterns.h]
2020-05-27 added program flow diagram
