udellc/Optron/Images/diffuser_cut_away.jpg

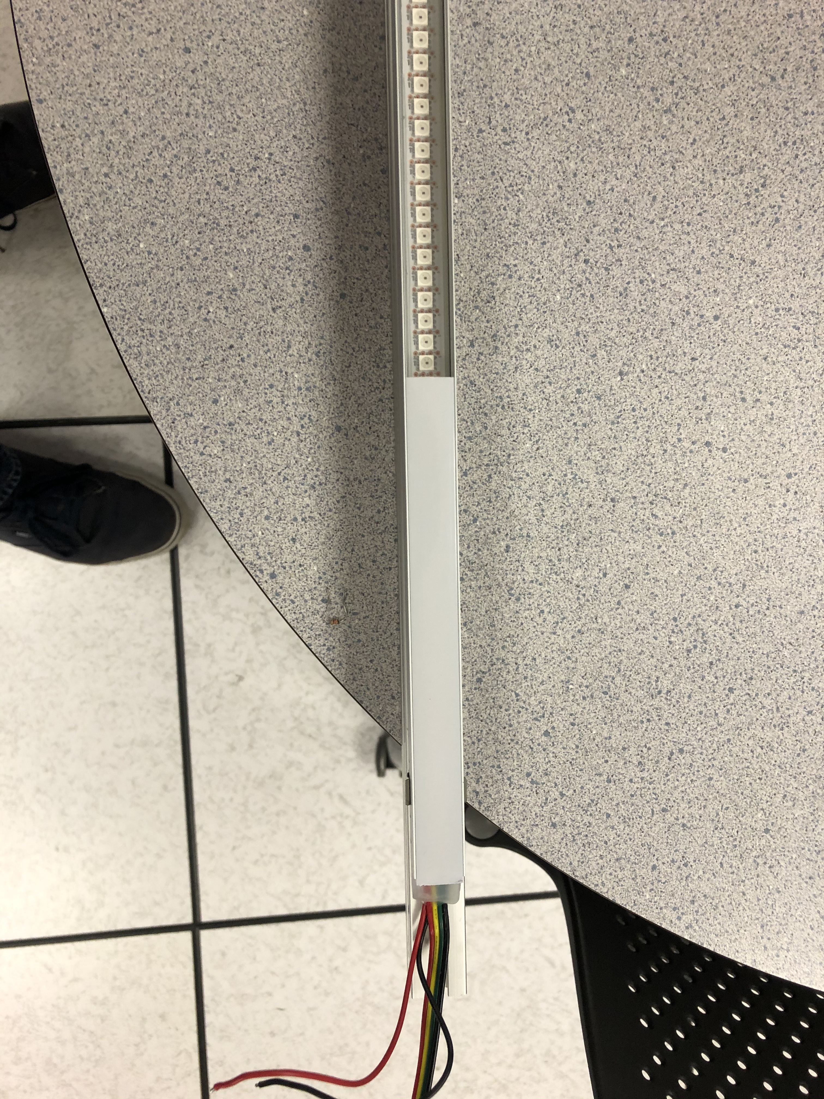
Images/diffuser_cut_away.jpg
