udellc/Optron/Images/general assembly/IR/IMG_2664.JPG

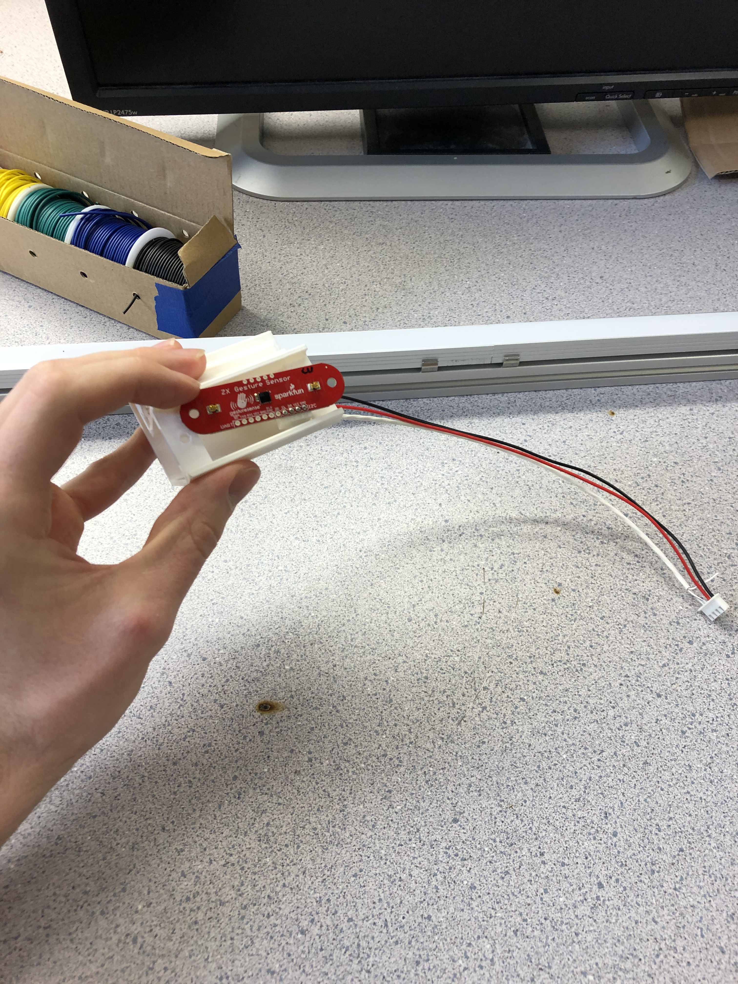
Images/general assembly/IR/IMG_2664.JPG
