udellc/Optron/Images/general assembly/IR/IMG_2679.JPG

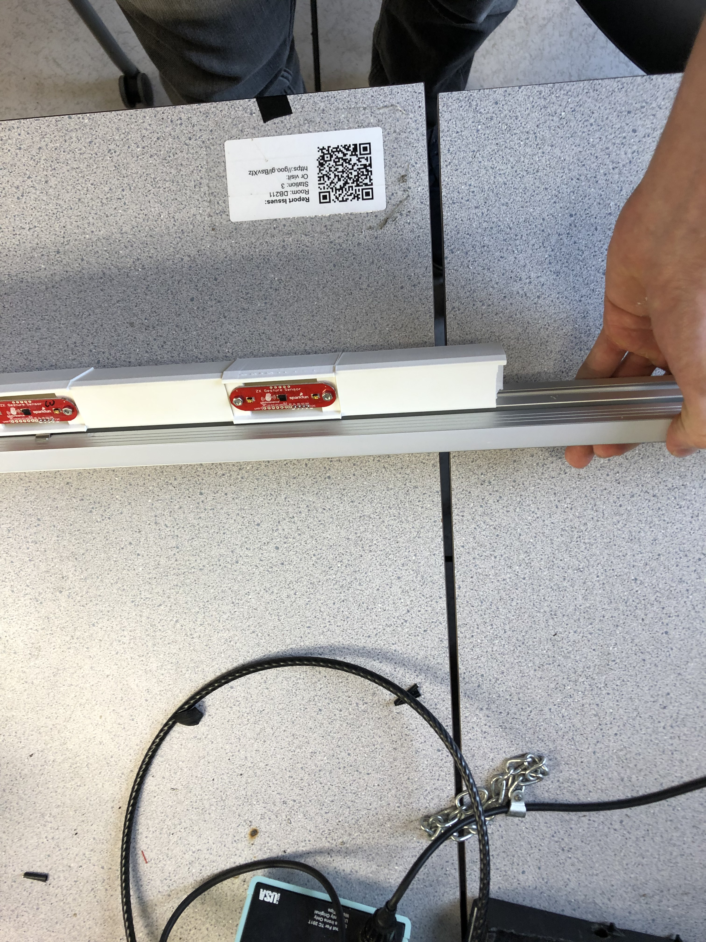
Images/general assembly/IR/IMG_2679.JPG
