udellc/Optron/Images/general assembly/LED/IMG_2636.JPG

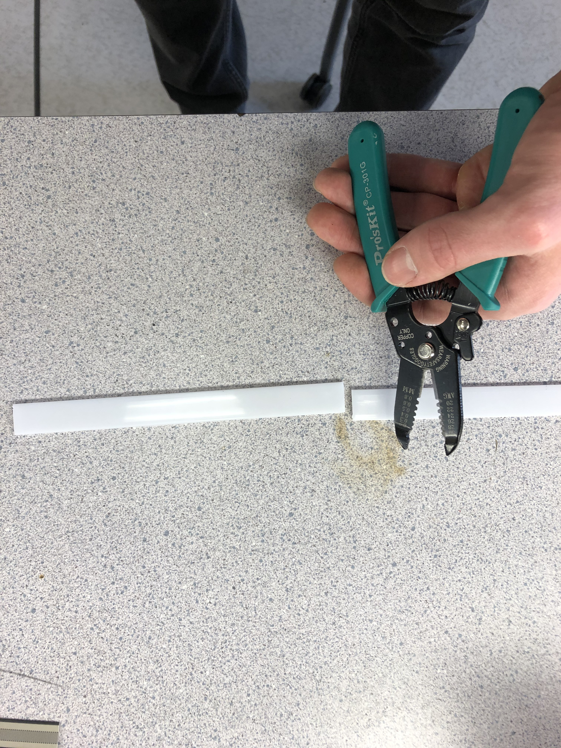
Images/general assembly/LED/IMG_2636.JPG
