udellc/Optron/Images/general assembly/LED/IMG_2637.JPG

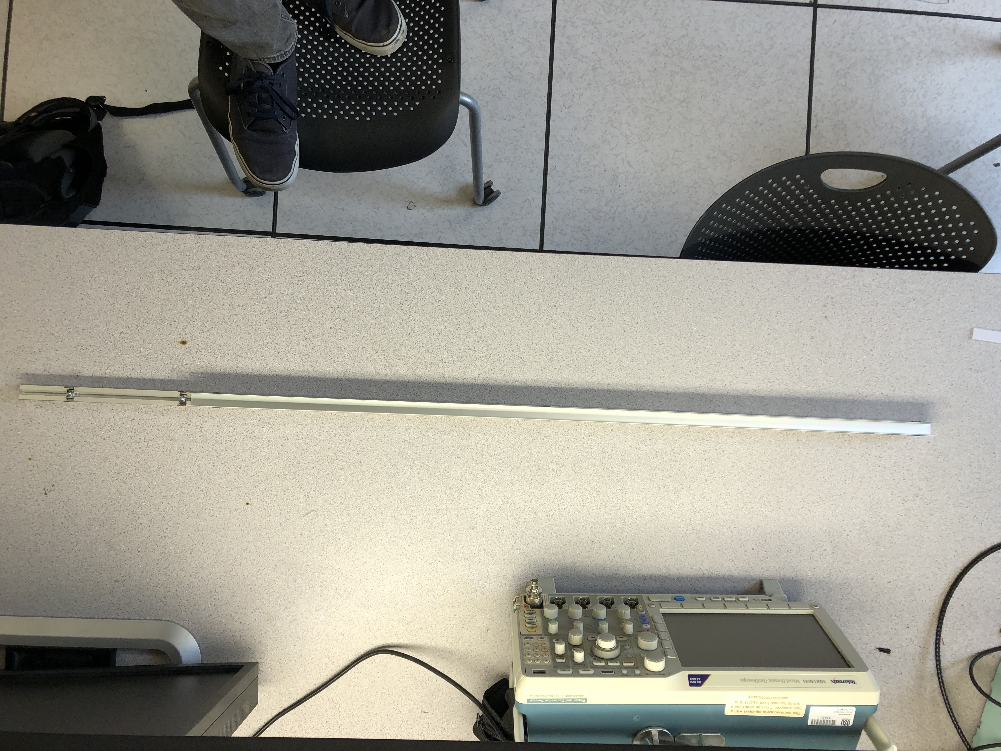
Images/general assembly/LED/IMG_2637.JPG
