udellc/Optron/Images/general assembly/LED/IMG_2639.JPG

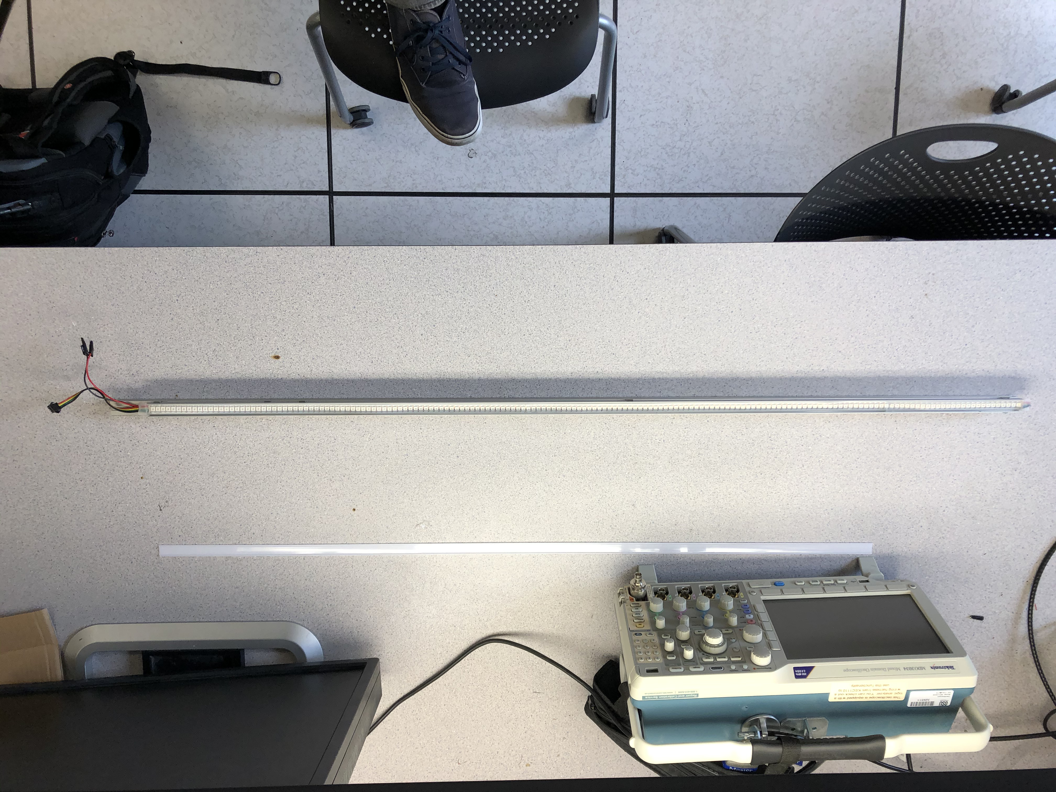
Images/general assembly/LED/IMG_2639.JPG
