udellc/Optron/Images/general assembly/LED/IMG_2641.JPG

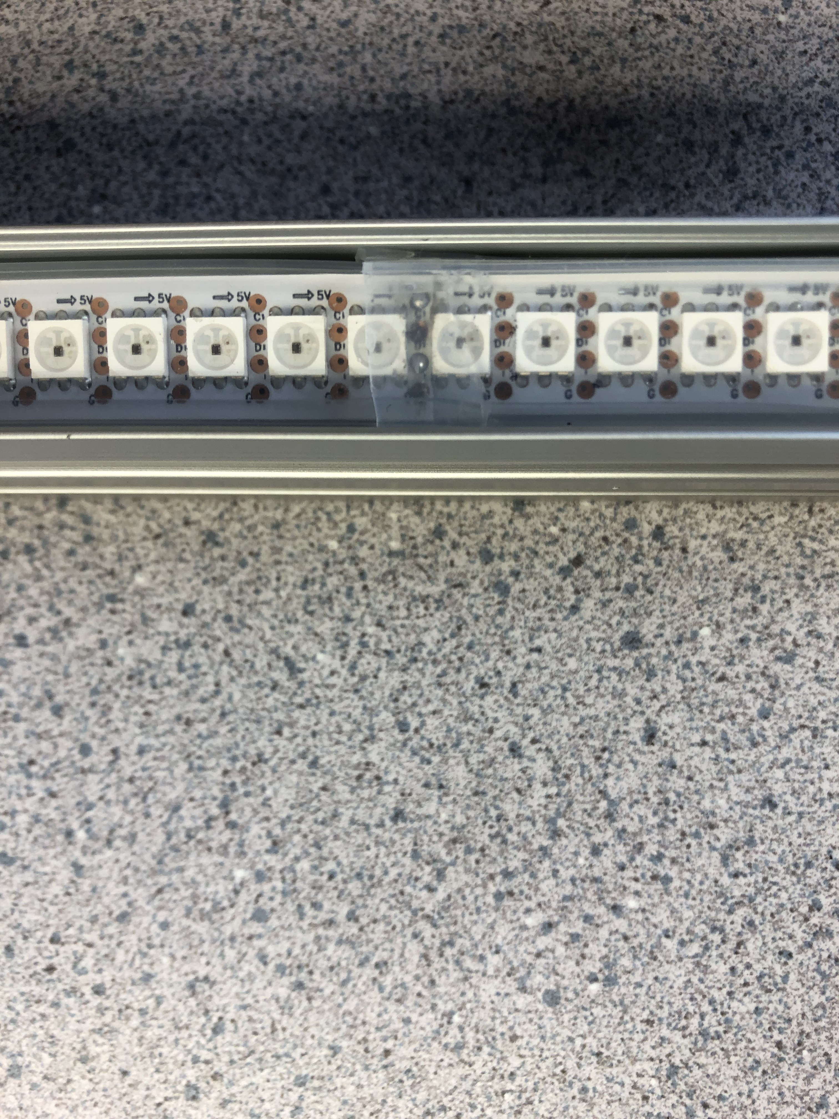
Images/general assembly/LED/IMG_2641.JPG
