udellc/Optron/Images/general assembly/LED/IMG_2643.JPG

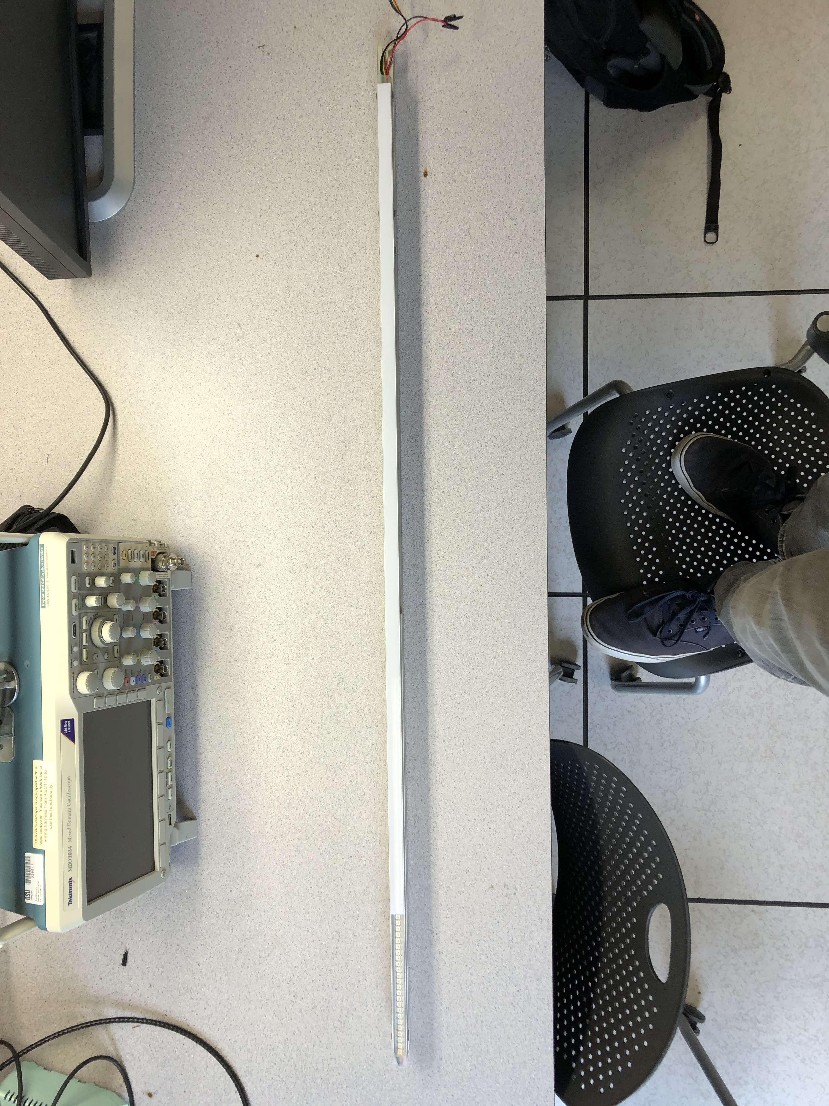
Images/general assembly/LED/IMG_2643.JPG
