udellc/Optron/Images/general assembly/LED/IMG_2644.JPG

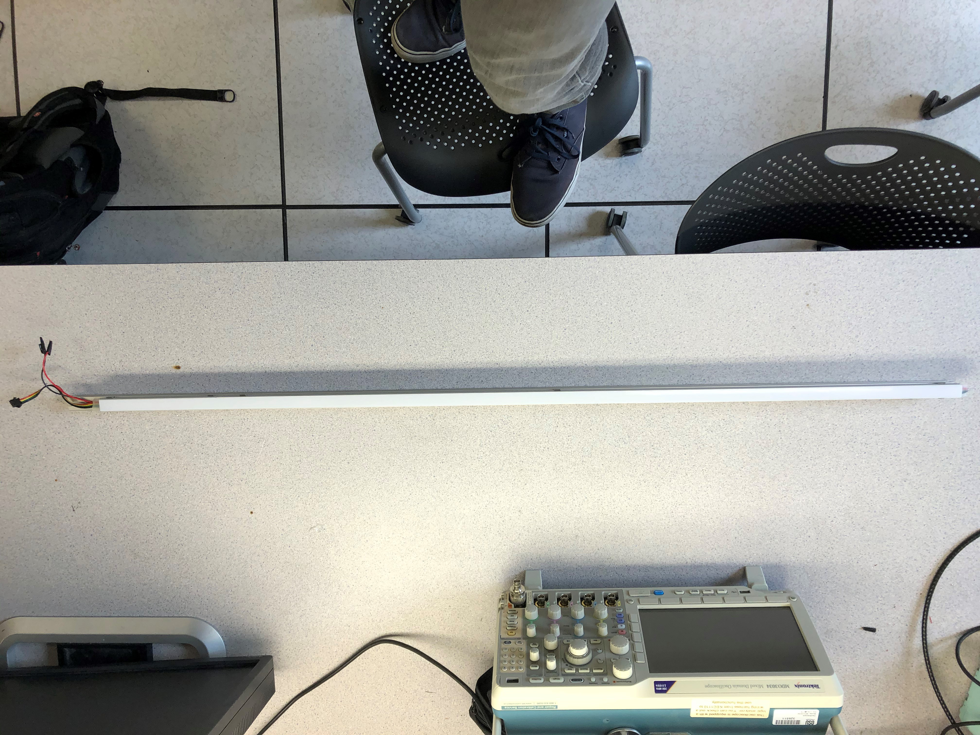
Images/general assembly/LED/IMG_2644.JPG
